Degeneracy-Evil/cpu-designers/Report/media/嵌入式cpu测试.jpg

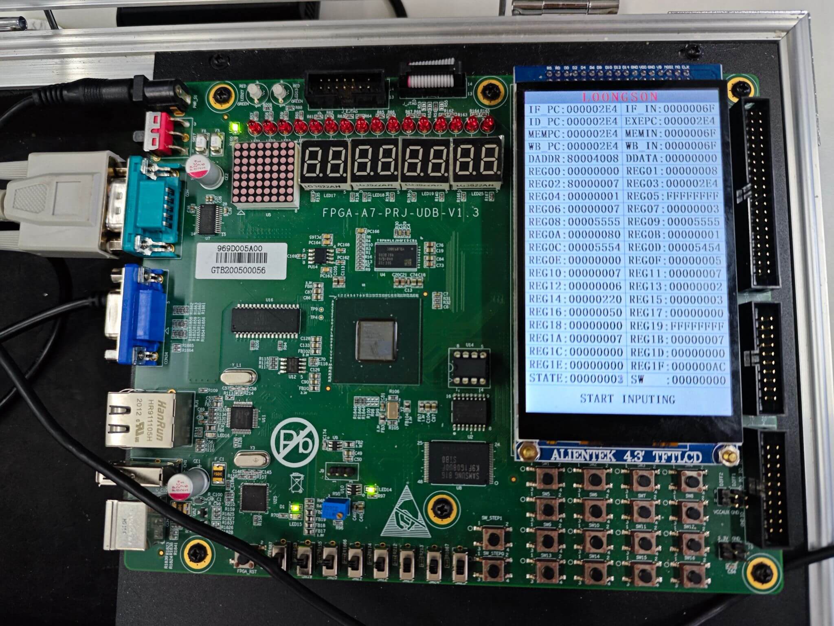
Report/media/嵌入式cpu测试.jpg
