Degeneracy-Evil/cpu-designers/Report/media/debug.jpg

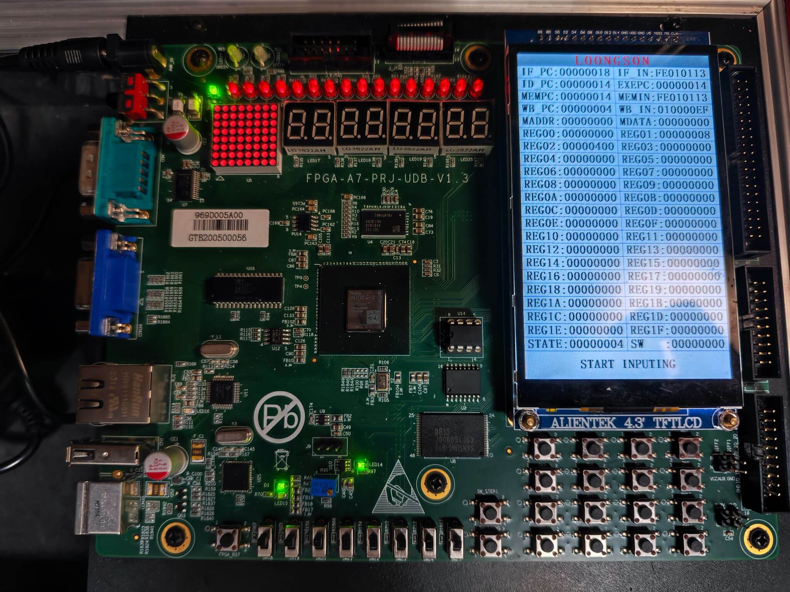
Report/media/debug.jpg
