Degeneracy-Evil/cpu-designers/Reference/FPGA基础信息.md

# FPGA基础信息

芯片型号：xc7a200tfbg676-2

硬件描述：lcd_module.dcp

系统clock频率：100MHz

## 存储模块

SRAM：IDT 71V124SA10TYG，128K（地址空间） × 8位（数据位宽），总容量 1Mbit，10ns
DDR3：Samsung DDR3 SDRAM K4B1G1646G-BCK0 128MB x16 1866Mbps PC3L-14900 CL13
NAND Flash：Samsung K9F1G08U0C-PCB0 128M x 8bits ，异步并行接口，Page=2KB + 64B，Block=128KB + 4KB，ECC
