Degeneracy-Evil/cpu-designers/dev/docs/IS/29-Zc扩展-代码体积缩减.md

## 第29章 "Zc*"扩展：代码体积缩减，版本1.0.0

## 29.1. Zc*概述

Zc*是一组扩展，定义了现有C扩展的子集（Zca、Zcd、Zcf）以及仅包含16位编码的新扩展。

Zcm*都重用了*c.fld*、*c.fsd*、*c.fldsp*、*c.fsdsp*的编码。

*表40. Zc*扩展概览*

|指令|Zca|Zcf|Zcd|Zcb|Zcmp|Zcmt|
|---|---|---|---|---|---|---|
|Zca扩展被添加为一种引用C扩展中不包含浮点加载和存储指令的方式|||||||
|C excl. c.f*|yes||||||
|Zcf扩展被添加为一种引用压缩单精度浮点加载/存储的方式|||||||
|c.flw||rv32|||||
|c.flwsp||rv32|||||
|c.fsw||rv32|||||
|c.fswsp||rv32|||||
|Zcd扩展被添加为一种引用压缩双精度浮点加载/存储的方式|||||||
|c.fld|||yes||||
|c.fldsp|||yes||||
|c.fsd|||yes||||
|c.fsdsp|||yes||||
|可在所有架构上使用的简单操作|||||||
|c.lbu||||yes|||
|c.lh||||yes|||
|c.lhu||||yes|||
|c.sb||||yes|||
|c.sh||||yes|||
|c.zext.b||||yes|||
|c.sext.b||||yes|||
|c.zext.h||||yes|||
|c.sext.h||||yes|||
|c.zext.w||||yes|||
|c.mul||||yes|||
|c.not||||yes|||
|PUSH/POP和双寄存器移动，与*c.fsdsp*编码重叠。面向嵌入式CPU的复杂操作|||||||
|cm.push|||||yes||
|cm.pop|||||yes||
|cm.popret|||||yes||
|cm.popretz|||||yes||
|cm.mva01s|||||yes||
|cm.mvsa01|||||yes||
|表跳转，与*c.fsdsp*编码重叠。面向嵌入式CPU的复杂操作|||||||
|cm.jt||||||yes|
|cm.jalt||||||yes|

## 29.2. C

C扩展是以下扩展的超集：

- Zca
- 如果指定了F，则包含Zcf（仅RV32）
- 如果指定了D，则包含Zcd

由于C定义了与Zca、Zcf和Zcd相同的指令，规则如下：

- C总是蕴含Zca
- C+F蕴含Zcf（仅RV32）
- C+D蕴含Zcd

## 29.3. Zce

Zce扩展旨在用于微控制器，包括所有相关的Zc扩展。

- 在不带F的RV32上指定Zce包含Zca、Zcb、Zcmp、Zcmt
- 在带F的RV32上指定Zce包含Zca、Zcb、Zcmp、Zcmt*和*Zcf
- 在RV64上指定Zce始终包含Zca、Zcb、Zcmp、Zcmt
  - Zcf在RV64中不存在

因此，常见的ISA字符串可以如下更新以包含相关的Zc扩展，例如：

- RV32IMC变为RV32IM_Zce
- RV32IMCF变为RV32IMF_Zce

## 29.4. MISA.C

如果选择了以下扩展，则MISA.C被设置：

- Zca且非F
- Zca、Zcf和F（但非D）被指定（仅RV32）
- Zca、Zcf和Zcd如果D被指定（仅RV32）
  - 此配置排除Zcmp、Zcmt
- Zca、Zcd如果D被指定（仅RV64）
  - 此配置排除Zcmp、Zcmt

## 29.5. Zca

Zca扩展被添加为一种引用C扩展中不包含浮点加载和存储指令的方式。

因此它*排除*了所有16位浮点加载和存储：*c.flw*、*c.flwsp*、*c.fsw*、*c.fswsp*、*c.fld*、*c.fldsp*、*c.fsd*、*c.fsdsp*。

**评论：** C扩展仅在D和F也被指定时才包含F/D指令。

## 29.6. Zcf（仅RV32）

Zcf是现有的压缩单精度浮点加载和存储集合：*c.flw*、*c.flwsp*、*c.fsw*、*c.fswsp*。

Zcf仅与RV32相关，不能为RV64指定。

Zcf扩展依赖于Zca和F扩展。

## 29.7. Zcd

Zcd是现有的压缩双精度浮点加载和存储集合：*c.fld*、*c.fldsp*、*c.fsd*、*c.fsdsp*。

Zcd扩展依赖于Zca和D扩展。

## 29.8. Zcb

Zcb具有简单的代码体积节省指令，这些指令在所有CPU上都容易实现。

所有编码目前对所有架构都是保留的，且与任何现有扩展没有冲突。

**评论：** Zcb可以在任何CPU上实现，因为这些指令是应用类配置文件中现有32位指令的16位版本。

Zcb扩展依赖于Zca扩展。

如各个指令页面所示，Zcb中的许多指令依赖于另一个扩展的实现。例如，*c.mul*仅在M或Zmmul被实现时才实现，*c.sext.b*仅在Zbb被实现时才实现。

*c.mul*编码使用CA寄存器格式，与其他指令如*c.sub*、*c.xor*等一起。

**评论：** *c.sext.w是c.addiw rd, 0 (RV64)的伪指令。*

|RV32|RV64|助记符|指令|
|---|---|---|---|
|yes|yes|c.lbu *rd'*, uimm(*rs1'*)|加载无符号字节，16位编码|
|yes|yes|c.lhu *rd'*, uimm(*rs1'*)|加载无符号半字，16位编码|
|yes|yes|c.lh *rd'*, uimm(*rs1'*)|加载有符号半字，16位编码|
|yes|yes|c.sb *rs2'*, uimm(*rs1'*)|存储字节，16位编码|
|yes|yes|c.sh *rs2'*, uimm(*rs1'*)|存储半字，16位编码|
|yes|yes|c.zext.b *rsd'*|零扩展字节，16位编码|
|yes|yes|c.sext.b *rsd'*|符号扩展字节，16位编码|
|yes|yes|c.zext.h *rsd'*|零扩展半字，16位编码|
|yes|yes|c.sext.h *rsd'*|符号扩展半字，16位编码|
||yes|c.zext.w *rsd'*|零扩展字，16位编码|
|yes|yes|c.not *rsd'*|按位取反，16位编码|
|yes|yes|c.mul *rsd'*, *rs2'*|乘法，16位编码|

## 29.9. Zcmp

Zcmp扩展是一组可以作为现有32位RISC-V指令序列执行的指令。

此扩展重用了*c.fsdsp*的一些编码。因此它与Zcd*不兼容*，Zcd在C和D扩展同时存在时被包含。

**评论：** Zcmp主要面向嵌入式类CPU，因为实现复杂性较高。此外，它不兼容应用类配置文件。

Zcmp扩展依赖于Zca扩展。

PUSH/POP汇编语法使用多个变量，其含义如下：

- *reg_list*是一个包含1到13个寄存器的列表（ra和0到12个s寄存器）
  - 有效值：{ra}、{ra, s0}、{ra, s0-s1}、{ra, s0-s2}、…、{ra, s0-s8}、{ra, s0-s9}、{ra, s0-s11}
  - 注意{ra, s0-s10}是*无效*的，提供12个列表而非13个以获得更好的编码
- *stack_adj*是栈帧的总大小。
  - 有效值随寄存器列表长度和具体编码而变化，详见各指令页面。

|RV32|RV64|助记符|指令|
|---|---|---|---|
|yes|yes|cm.push *{reg_list}*, -*stack_adj*|cm.push|
|yes|yes|cm.pop *{reg_list}*, *stack_adj*|cm.pop|
|yes|yes|cm.popret *{reg_list}*, *stack_adj*|cm.popret|
|yes|yes|cm.popretz *{reg_list}*, *stack_adj*|cm.popretz|
|yes|yes|cm.mva01s *rs1'*, *rs2'*|将两个s0-s7寄存器移动到a0-a1|
|yes|yes|cm.mvsa01 *r1s'*, *r2s'*|将a0-a1移动到两个不同的s0-s7寄存器|

## 29.10. Zcmt

Zcmt添加了表跳转指令，还添加了jvt CSR。如果实现了Smstateen，则jvt CSR需要状态使能。详情参见jvt CSR，表跳转基向量和控制寄存器。

此扩展重用了*c.fsdsp*的一些编码。因此它与Zcd*不兼容*，Zcd在C和D扩展同时存在时被包含。

**评论：** Zcmt主要面向嵌入式类CPU，因为实现复杂性较高。此外，它与RVA配置文件不兼容。

Zcmt扩展依赖于Zca和Zicsr扩展。

|RV32|RV64|助记符|指令|
|---|---|---|---|
|yes|yes|cm.jt *index*|通过表跳转|
|yes|yes|cm.jalt *index*|通过表跳转并链接|

## 29.11. Zc指令格式

本规范中的若干指令使用以下新指令格式。

|格式|指令|15:10|9|8|7|6|5|4|3|2|1|0|
|---|---|---|---|---|---|---|---|---|---|---|---|---|---|
|CLB|c.lbu|funct6|rs1'|||uimm||rd'|||op||
|CSB|c.sb|funct6|rs1'|||uimm||rs2'|||op||
|CLH|c.lhu, c.lh|funct6|rs1'|||funct<br>1|uim<br>m|rd'|||op||
|CSH|c.sh|funct6|rs1'|||funct<br>1|uim<br>m|rs2'|||op||
|CU|c.[sz]ext.*, c.not|funct6|rd'/rs1'|||funct5|||||op||
|CMMV|cm.mvsa01<br>cm.mva01s|funct6|r1s'|||funct2||r2s'|||op||
|CMJT|cm.jt cm.jalt|funct6|index||||||||op||
|CMPP|cm.push*, cm.pop*|funct6|funct2||urlist||||spimm||op||

**评论：** *c.mul使用现有的CA格式。*

## 29.12. Zcb指令

## 29.12.1. c.lbu

### 概要

加载无符号字节，16位编码

### 助记符

c.lbu *rd'* , *uimm* ( *rs1'* )

编码（RV32, RV64）：

|0<br>1<br>2<br>4<br>5<br>6<br>7<br>9<br>10<br>12<br>13<br>15|0<br>1<br>2<br>4<br>5<br>6<br>7<br>9<br>10<br>12<br>13<br>15|0<br>1<br>2<br>4<br>5<br>6<br>7<br>9<br>10<br>12<br>13<br>15|0<br>1<br>2<br>4<br>5<br>6<br>7<br>9<br>10<br>12<br>13<br>15|0<br>1<br>2<br>4<br>5<br>6<br>7<br>9<br>10<br>12<br>13<br>15|0<br>1<br>2<br>4<br>5<br>6<br>7<br>9<br>10<br>12<br>13<br>15|
|---|---|---|---|---|---|---|
|0<br>0<br>1|0<br>0<br>0|rs1'|uimm[0|1]|rd'|0<br>0|
|C0<br>FUNCT3|||||||

立即数偏移量按如下方式形成：

```
  uimm[31:2] = 0;
  uimm[1]    = encoding[5];
  uimm[0]    = encoding[6];
```

### 描述

此指令从内存地址加载一个字节，该地址通过将*rs1'*与零扩展立即数*uimm*相加形成。结果字节被零扩展到XLEN位并写入*rd'*。

**评论：** *rd'和rs1'来自标准8寄存器集x8-x15。*

### 前置条件

无

### 操作

```
//这不是SAIL，是伪代码。SAIL尚未编写。
```

```
X(rdc) = EXTZ(mem[X(rs1c)+EXTZ(uimm)][7..0]);
```

## 29.12.2. c.lhu

### 概要

加载无符号半字，16位编码

### 助记符

c.lhu *rd'* , *uimm* ( *rs1'* )

编码（RV32, RV64）：

|0<br>1<br>2<br>4<br>5<br>6<br>7<br>9<br>10<br>12<br>13<br>15|0<br>1<br>2<br>4<br>5<br>6<br>7<br>9<br>10<br>12<br>13<br>15|0<br>1<br>2<br>4<br>5<br>6<br>7<br>9<br>10<br>12<br>13<br>15|0<br>1<br>2<br>4<br>5<br>6<br>7<br>9<br>10<br>12<br>13<br>15|0<br>1<br>2<br>4<br>5<br>6<br>7<br>9<br>10<br>12<br>13<br>15|0<br>1<br>2<br>4<br>5<br>6<br>7<br>9<br>10<br>12<br>13<br>15|0<br>1<br>2<br>4<br>5<br>6<br>7<br>9<br>10<br>12<br>13<br>15|
|---|---|---|---|---|---|---|
|0<br>0<br>1|1<br>0<br>0|rs1'|0|uimm[1]|rd'<br>|0<br>0|
|C0<br>FUNCT3||||||||

立即数偏移量按如下方式形成：

```
  uimm[31:2] = 0;
  uimm[1]    = encoding[5];
  uimm[0]    = 0;
```

### 描述

此指令从内存地址加载一个半字，该地址通过将*rs1'*与零扩展立即数*uimm*相加形成。结果半字被零扩展到XLEN位并写入*rd'*。

**评论：** *rd'和rs1'来自标准8寄存器集x8-x15。*

### 前置条件

无

### 操作

```
//这不是SAIL，是伪代码。SAIL尚未编写。
```

```
X(rdc) = EXTZ(load_mem[X(rs1c)+EXTZ(uimm)][15..0]);
```

## 29.12.3. c.lh

### 概要

加载有符号半字，16位编码

### 助记符

c.lh *rd'* , *uimm* ( *rs1'* )

编码（RV32, RV64）：

|0<br>1<br>2<br>4<br>5<br>6<br>7<br>9<br>10<br>12<br>13<br>15|0<br>1<br>2<br>4<br>5<br>6<br>7<br>9<br>10<br>12<br>13<br>15|0<br>1<br>2<br>4<br>5<br>6<br>7<br>9<br>10<br>12<br>13<br>15|0<br>1<br>2<br>4<br>5<br>6<br>7<br>9<br>10<br>12<br>13<br>15|0<br>1<br>2<br>4<br>5<br>6<br>7<br>9<br>10<br>12<br>13<br>15|0<br>1<br>2<br>4<br>5<br>6<br>7<br>9<br>10<br>12<br>13<br>15|0<br>1<br>2<br>4<br>5<br>6<br>7<br>9<br>10<br>12<br>13<br>15|
|---|---|---|---|---|---|---|
|0<br>0<br>1|1<br>0<br>0|rs1'|1|uimm[1]|rd'<br>|0<br>0|
|C0<br>FUNCT3||||||||

立即数偏移量按如下方式形成：

```
  uimm[31:2] = 0;
  uimm[1]    = encoding[5];
  uimm[0]    = 0;
```

### 描述

此指令从内存地址加载一个半字，该地址通过将*rs1'*与零扩展立即数*uimm*相加形成。结果半字被符号扩展到XLEN位并写入*rd'*。

**评论：** *rd'和rs1'来自标准8寄存器集x8-x15。*

### 前置条件

无

### 操作

```
//这不是SAIL，是伪代码。SAIL尚未编写。
```

```
X(rdc) = EXTS(load_mem[X(rs1c)+EXTZ(uimm)][15..0]);
```

## 29.12.4. c.sb

### 概要

存储字节，16位编码

### 助记符

c.sb *rs2'* , *uimm* ( *rs1'* )

编码（RV32, RV64）：

|0<br>1<br>2<br>4<br>5<br>6<br>7<br>9<br>10<br>12<br>13<br>15|0<br>1<br>2<br>4<br>5<br>6<br>7<br>9<br>10<br>12<br>13<br>15|0<br>1<br>2<br>4<br>5<br>6<br>7<br>9<br>10<br>12<br>13<br>15|0<br>1<br>2<br>4<br>5<br>6<br>7<br>9<br>10<br>12<br>13<br>15|0<br>1<br>2<br>4<br>5<br>6<br>7<br>9<br>10<br>12<br>13<br>15|0<br>1<br>2<br>4<br>5<br>6<br>7<br>9<br>10<br>12<br>13<br>15|
|---|---|---|---|---|---|---|
|0<br>0<br>1|0<br>1<br>0|rs1'|uimm[0|1]|rs2'|0<br>0|
|C0<br>FUNCT3|||||||

立即数偏移量按如下方式形成：

```
  uimm[31:2] = 0;
  uimm[1]    = encoding[5];
  uimm[0]    = encoding[6];
```

### 描述

此指令将*rs2'*的最低有效字节存储到内存地址，该地址通过将*rs1'*与零扩展立即数*uimm*相加形成。

**评论：** *rs1'和rs2'来自标准8寄存器集x8-x15。*

### 前置条件

无

### 操作

```
//这不是SAIL，是伪代码。SAIL尚未编写。
```

```
mem[X(rs1c)+EXTZ(uimm)][7..0] = X(rs2c)
```

## 29.12.5. c.sh

### 概要

存储半字，16位编码

### 助记符

c.sh *rs2'* , *uimm* ( *rs1'* )

编码（RV32, RV64）：

|0<br>1<br>2<br>4<br>5<br>6<br>7<br>9<br>10<br>12<br>13<br>15|0<br>1<br>2<br>4<br>5<br>6<br>7<br>9<br>10<br>12<br>13<br>15|0<br>1<br>2<br>4<br>5<br>6<br>7<br>9<br>10<br>12<br>13<br>15|0<br>1<br>2<br>4<br>5<br>6<br>7<br>9<br>10<br>12<br>13<br>15|0<br>1<br>2<br>4<br>5<br>6<br>7<br>9<br>10<br>12<br>13<br>15|0<br>1<br>2<br>4<br>5<br>6<br>7<br>9<br>10<br>12<br>13<br>15|0<br>1<br>2<br>4<br>5<br>6<br>7<br>9<br>10<br>12<br>13<br>15|
|---|---|---|---|---|---|---|
|0<br>0<br>1|1<br>1<br>0|rs1'|0|uimm[1]|rs2'<br>|0<br>0|
|C0<br>FUNCT3||||||||

立即数偏移量按如下方式形成：

```
  uimm[31:2] = 0;
  uimm[1]    = encoding[5];
  uimm[0]    = 0;
```

### 描述

此指令将*rs2'*的最低有效半字存储到内存地址，该地址通过将*rs1'*与零扩展立即数*uimm*相加形成。

**评论：** *rs1'和rs2'来自标准8寄存器集x8-x15。*

### 前置条件

无

### 操作

```
//这不是SAIL，是伪代码。SAIL尚未编写。
```

```
mem[X(rs1c)+EXTZ(uimm)][15..0] = X(rs2c)
```

## 29.12.6. c.zext.b

### 概要

零扩展字节，16位编码

### 助记符

c.zext.b *rd'/rs1'*

编码（RV32, RV64）：

|0<br>1<br>2<br>4<br>5<br>6<br>7<br>9<br>10<br>12<br>13<br>15|0<br>1<br>2<br>4<br>5<br>6<br>7<br>9<br>10<br>12<br>13<br>15|0<br>1<br>2<br>4<br>5<br>6<br>7<br>9<br>10<br>12<br>13<br>15|0<br>1<br>2<br>4<br>5<br>6<br>7<br>9<br>10<br>12<br>13<br>15|0<br>1<br>2<br>4<br>5<br>6<br>7<br>9<br>10<br>12<br>13<br>15|0<br>1<br>2<br>4<br>5<br>6<br>7<br>9<br>10<br>12<br>13<br>15|
|---|---|---|---|---|---|---|
|0<br>0<br>1|1<br>1<br>1|rd'/rs1'|1<br>1|0<br>0<br>0|1<br>0|
|C1<br>C.ZEXT.B<br>FUNCT2<br>SRCDST<br>FUNCT3|||||||

### 描述

此指令接受单个源/目标操作数。它将操作数的最低有效字节零扩展到XLEN位，通过在高于7的所有位中插入零。

**评论：** *rd'/rs1'来自标准8寄存器集x8-x15。*

### 前置条件

无

32位等价指令：

```
andi rd'/rs1', rd'/rs1', 0xff
```

**评论：** *rd'/rs1'的SAIL模块变量称为rsdc。*

### 操作

```
X(rsdc) = EXTZ(X(rsdc)[7..0]);
```

## 29.12.7. c.sext.b

### 概要

符号扩展字节，16位编码

### 助记符

c.sext.b *rd'/rs1'*

编码（RV32, RV64）：

|0<br>1<br>2<br>4<br>5<br>6<br>7<br>9<br>10<br>12<br>13<br>15|0<br>1<br>2<br>4<br>5<br>6<br>7<br>9<br>10<br>12<br>13<br>15|0<br>1<br>2<br>4<br>5<br>6<br>7<br>9<br>10<br>12<br>13<br>15|0<br>1<br>2<br>4<br>5<br>6<br>7<br>9<br>10<br>12<br>13<br>15|0<br>1<br>2<br>4<br>5<br>6<br>7<br>9<br>10<br>12<br>13<br>15|0<br>1<br>2<br>4<br>5<br>6<br>7<br>9<br>10<br>12<br>13<br>15|
|---|---|---|---|---|---|---|
|0<br>0<br>1|1<br>1<br>1|rd'/rs1'|1<br>1|1<br>0<br>0|1<br>0|
|C1<br>C.SEXT.B<br>FUNCT2<br>SRCDST<br>FUNCT3|||||||

### 描述

此指令接受单个源/目标操作数。它将操作数中的最低有效字节符号扩展到XLEN位，通过将字节中的最高有效位（即位7）复制到所有更高位。

**评论：** *rd'/rs1'来自标准8寄存器集x8-x15。*

### 前置条件

还需要Zbb。

**评论：** *rd'/rs1'的SAIL模块变量称为rsdc。*

### 操作

```
X(rsdc) = EXTS(X(rsdc)[7..0]);
```

## 29.12.8. c.zext.h

### 概要

零扩展半字，16位编码

### 助记符

c.zext.h *rd'/rs1'*

编码（RV32, RV64）：

|0<br>1<br>2<br>4<br>5<br>6<br>7<br>9<br>10<br>12<br>13<br>15|0<br>1<br>2<br>4<br>5<br>6<br>7<br>9<br>10<br>12<br>13<br>15|0<br>1<br>2<br>4<br>5<br>6<br>7<br>9<br>10<br>12<br>13<br>15|0<br>1<br>2<br>4<br>5<br>6<br>7<br>9<br>10<br>12<br>13<br>15|0<br>1<br>2<br>4<br>5<br>6<br>7<br>9<br>10<br>12<br>13<br>15|0<br>1<br>2<br>4<br>5<br>6<br>7<br>9<br>10<br>12<br>13<br>15|
|---|---|---|---|---|---|---|
|0<br>0<br>1|1<br>1<br>1|rd'/rs1'|1<br>1|0<br>1<br>0|1<br>0|
|C1<br>C.ZEXT.H<br>FUNCT2<br>SRCDST<br>FUNCT3|||||||

### 描述

此指令接受单个源/目标操作数。它将操作数的最低有效半字零扩展到XLEN位，通过在高于15的所有位中插入零。

**评论：** *rd'/rs1'来自标准8寄存器集x8-x15。*

### 前置条件

还需要Zbb。

**评论：** *rd'/rs1'的SAIL模块变量称为rsdc。*

### 操作

```
X(rsdc) = EXTZ(X(rsdc)[15..0]);
```

## 29.12.9. c.sext.h

### 概要

符号扩展半字，16位编码

### 助记符

c.sext.h *rd'/rs1'*

编码（RV32, RV64）：

|0<br>1<br>2<br>4<br>5<br>6<br>7<br>9<br>10<br>12<br>13<br>15|0<br>1<br>2<br>4<br>5<br>6<br>7<br>9<br>10<br>12<br>13<br>15|0<br>1<br>2<br>4<br>5<br>6<br>7<br>9<br>10<br>12<br>13<br>15|0<br>1<br>2<br>4<br>5<br>6<br>7<br>9<br>10<br>12<br>13<br>15|0<br>1<br>2<br>4<br>5<br>6<br>7<br>9<br>10<br>12<br>13<br>15|0<br>1<br>2<br>4<br>5<br>6<br>7<br>9<br>10<br>12<br>13<br>15|
|---|---|---|---|---|---|---|
|0<br>0<br>1|1<br>1<br>1|rd'/rs1'|1<br>1|1<br>1<br>0|1<br>0|
|C1<br>C.SEXT.H<br>FUNCT2<br>SRCDST<br>FUNCT3|||||||

### 描述

此指令接受单个源/目标操作数。它将操作数中的最低有效半字符号扩展到XLEN位，通过将半字中的最高有效位（即位15）复制到所有更高位。

**评论：** *rd'/rs1'来自标准8寄存器集x8-x15。*

### 前置条件

还需要Zbb。

**评论：** *rd'/rs1'的SAIL模块变量称为rsdc。*

### 操作

```
X(rsdc) = EXTS(X(rsdc)[15..0]);
```

## 29.12.10. c.zext.w

### 概要

零扩展字，16位编码

### 助记符

c.zext.w *rd'/rs1'*

编码（RV64）：

|0<br>1<br>2<br>4<br>5<br>6<br>7<br>9<br>10<br>12<br>13<br>15|0<br>1<br>2<br>4<br>5<br>6<br>7<br>9<br>10<br>12<br>13<br>15|0<br>1<br>2<br>4<br>5<br>6<br>7<br>9<br>10<br>12<br>13<br>15|0<br>1<br>2<br>4<br>5<br>6<br>7<br>9<br>10<br>12<br>13<br>15|0<br>1<br>2<br>4<br>5<br>6<br>7<br>9<br>10<br>12<br>13<br>15|0<br>1<br>2<br>4<br>5<br>6<br>7<br>9<br>10<br>12<br>13<br>15|
|---|---|---|---|---|---|---|
|0<br>0<br>1|1<br>1<br>1|rd'/rs1'|1<br>1|0<br>0<br>1|1<br>0|
|C1<br>C.ZEXT.W<br>FUNCT2<br>SRCDST<br>FUNCT3|||||||

### 描述

此指令接受单个源/目标操作数。它将操作数的最低有效字零扩展到XLEN位，通过在高于31的所有位中插入零。

**评论：** *rd'/rs1'来自标准8寄存器集x8-x15。*

### 前置条件

还需要Zba。

32位等价指令：

```
add.uw rd'/rs1', rd'/rs1', zero
```

**评论：** *rd'/rs1'的SAIL模块变量称为rsdc。*

### 操作

```
X(rsdc) = EXTZ(X(rsdc)[31..0]);
```

## 29.12.11. c.not

### 概要

按位取反，16位编码

### 助记符

c.not *rd'/rs1'*

编码（RV32, RV64）：

|0<br>1<br>2<br>4<br>5<br>6<br>7<br>9<br>10<br>12<br>13<br>15|0<br>1<br>2<br>4<br>5<br>6<br>7<br>9<br>10<br>12<br>13<br>15|0<br>1<br>2<br>4<br>5<br>6<br>7<br>9<br>10<br>12<br>13<br>15|0<br>1<br>2<br>4<br>5<br>6<br>7<br>9<br>10<br>12<br>13<br>15|0<br>1<br>2<br>4<br>5<br>6<br>7<br>9<br>10<br>12<br>13<br>15|0<br>1<br>2<br>4<br>5<br>6<br>7<br>9<br>10<br>12<br>13<br>15|
|---|---|---|---|---|---|---|
|0<br>0<br>1|1<br>1<br>1|rd'/rs1'|1<br>1|1<br>0<br>1|1<br>0|
|C1<br>C.NOT<br>FUNCT2<br>SRCDST<br>FUNCT3|||||||

### 描述

此指令取*rd'/rs1'*的反码，并将结果写入同一寄存器。

**评论：** *rd'/rs1'来自标准8寄存器集x8-x15。*

### 前置条件

无

32位等价指令：

```
xori rd'/rs1', rd'/rs1', -1
```

**评论：** *rd'/rs1'的SAIL模块变量称为rsdc。*

### 操作

```
X(rsdc) = X(rsdc) XOR -1;
```

## 29.12.12. c.mul

### 概要

乘法，16位编码

### 助记符

c.mul *rsd'* , *rs2'*

编码（RV32, RV64）：

|0<br>1<br>2<br>4<br>5<br>6<br>7<br>9<br>10<br>12<br>13<br>15|0<br>1<br>2<br>4<br>5<br>6<br>7<br>9<br>10<br>12<br>13<br>15|0<br>1<br>2<br>4<br>5<br>6<br>7<br>9<br>10<br>12<br>13<br>15|0<br>1<br>2<br>4<br>5<br>6<br>7<br>9<br>10<br>12<br>13<br>15|0<br>1<br>2<br>4<br>5<br>6<br>7<br>9<br>10<br>12<br>13<br>15|0<br>1<br>2<br>4<br>5<br>6<br>7<br>9<br>10<br>12<br>13<br>15|
|---|---|---|---|---|---|---|
|0<br>0<br>1|1<br>1<br>1|rd'/rs1'|0<br>1|rs2'|1<br>0|
|C1<br>SRC2<br>FUNCT2<br>SRCDST<br>FUNCT3|||||||

### 描述

此指令将来自*rsd'*和*rs2'*的源操作数的XLEN位相乘，并将结果的最低XLEN位写入*rsd'*。

**评论：** *rd'/rs1'和rs2'来自标准8寄存器集x8-x15。*

### 前置条件

必须配置M或Zmmul。

**评论：** *rd'/rs1'的SAIL模块变量称为rsdc，rs2'的模块变量称为rs2c。*

### 操作

```
let result_wide = to_bits(2 * sizeof(xlen), signed(X(rsdc)) * signed(X(rs2c)));
X(rsdc) = result_wide[(sizeof(xlen) - 1) .. 0];
```

## 29.13. PUSH/POP寄存器指令

这些指令统称为PUSH/POP：

- cm.push
- cm.pop
- cm.popret
- cm.popretz

术语PUSH指*cm.push*。

术语POP指*cm.pop*。

术语POPRET指*cm.popret和cm.popretz*。

这些指令的公共细节在本节中。

## 29.13.1. PUSH/POP功能概述

PUSH、POP、POPRET用于减少函数序幕和尾声的大小。

1. PUSH指令
   - 调整栈指针以创建栈帧
   - 将寄存器列表中指定的寄存器压入（存储到）栈帧

2. POP指令
   - 从栈帧弹出（加载）寄存器列表中的寄存器
   - 调整栈指针以销毁栈帧

3. POPRET指令
   - 从栈帧弹出（加载）寄存器列表中的寄存器
   - *cm.popretz*还将零移入*a0*作为返回值
   - 调整栈指针以销毁栈帧
   - 执行*ret*指令从函数返回

## 29.13.2. 示例用法

此示例说明了PUSH和POPRET的使用。

EMBench基准测试picojpeg中的*processMarkers*函数，位于github上的以下文件：libpicojpeg.c

序幕和尾声使用GCC10编译为：

```
   0001098a <processMarkers>:
   1098a:       711d                    addi    sp,sp,-96 ;#cm.push(1)
   1098c:       c8ca                    sw      s2,80(sp) ;#cm.push(2)
   1098e:       c6ce                    sw      s3,76(sp) ;#cm.push(3)
   10990:       c4d2                    sw      s4,72(sp) ;#cm.push(4)
   10992:       ce86                    sw      ra,92(sp) ;#cm.push(5)
   10994:       cca2                    sw      s0,88(sp) ;#cm.push(6)
   10996:       caa6                    sw      s1,84(sp) ;#cm.push(7)
   10998:       c2d6                    sw      s5,68(sp) ;#cm.push(8)
   1099a:       c0da                    sw      s6,64(sp) ;#cm.push(9)
   1099c:       de5e                    sw      s7,60(sp) ;#cm.push(10)
   1099e:       dc62                    sw      s8,56(sp) ;#cm.push(11)
   109a0:       da66                    sw      s9,52(sp) ;#cm.push(12)
   109a2:       d86a                    sw      s10,48(sp);#cm.push(13)
   109a4:       d66e                    sw      s11,44(sp);#cm.push(14)
...
   109f4:       4501                    li      a0,0      ;#cm.popretz(1)
   109f6:       40f6                    lw      ra,92(sp) ;#cm.popretz(2)
   109f8:       4466                    lw      s0,88(sp) ;#cm.popretz(3)
   109fa:       44d6                    lw      s1,84(sp) ;#cm.popretz(4)
   109fc:       4946                    lw      s2,80(sp) ;#cm.popretz(5)
   109fe:       49b6                    lw      s3,76(sp) ;#cm.popretz(6)
   10a00:       4a26                    lw      s4,72(sp) ;#cm.popretz(7)
   10a02:       4a96                    lw      s5,68(sp) ;#cm.popretz(8)
   10a04:       4b06                    lw      s6,64(sp) ;#cm.popretz(9)
   10a06:       5bf2                    lw      s7,60(sp) ;#cm.popretz(10)
   10a08:       5c62                    lw      s8,56(sp) ;#cm.popretz(11)
   10a0a:       5cd2                    lw      s9,52(sp) ;#cm.popretz(12)
   10a0c:       5d42                    lw      s10,48(sp);#cm.popretz(13)
   10a0e:       5db2                    lw      s11,44(sp);#cm.popretz(14)
   10a10:       6125                    addi    sp,sp,96  ;#cm.popretz(15)
   10a12:       8082                    ret               ;#cm.popretz(16)
```

使用GCC选项*-msave-restore*的输出如下：

```
0001080e <processMarkers>:
   1080e:       73a012ef                jal     t0,11f48 <__riscv_save_12>
   10812:       1101                    addi    sp,sp,-32
...
   10862:       4501                    li      a0,0
   10864:       6105                    addi    sp,sp,32
   10866:       71e0106f                j       11f84 <__riscv_restore_12>
```

使用PUSH/POPRET后简化为：

```
0001080e <processMarkers>:
   1080e:       b8fa                    cm.push    {ra,s0-s11},-96
...
   10866:       bcfa                    cm.popretz {ra,s0-s11}, 96
```

序幕/尾声从原始代码的60字节减少到使用*-msave-restore*的14字节，再减少到使用PUSH和POPRET的4字节。除了减少代码大小外，PUSH和POPRET还消除了调用毫码*save/restore*例程的分支，因此也可能具有更好的性能。

**评论：** *当目标函数超出±1 MB范围时，对<riscv_save_0>/<riscv_restore_0>的调用变为64位，将序幕/尾声大小增加到22字节。POP通常在尾调用序列中使用，在销毁栈帧后不使用ret返回ra。*

## 29.13.2.1. 栈指针调整处理

这些指令都自动调整栈指针，调整量足以覆盖保存或恢复的寄存器所需的内存。此外，编码中的*spimm*字段允许栈指针以16字节的额外增量进行调整。编码中只有一个小范围的可用值；如果范围不够，可以使用单独的*c.addi16sp*来增加范围。

## 29.13.2.2. 寄存器列表处理

不支持不包含*s11*的*{ra, s0-s10}*寄存器列表。因此在这种情况下必须使用*{ra, s0-s11}*寄存器列表。

## 29.13.3. PUSH/POP故障处理

正确执行要求*sp*引用幂等内存（另见非幂等内存处理），因为内核必须能够处理在序列期间检测到的陷阱。整个PUSH/POP序列在从陷阱处理程序返回后重新执行，并且序列期间可能发生多次陷阱。

如果在序列期间发生陷阱，*xEPC*使用指令的PC更新，*xTVAL*（如果不是只读零）使用坏地址更新（如果是访问故障），*xCAUSE*使用陷阱类型更新。

**评论：** *是否允许在序列执行期间发生中断由实现定义。*

## 29.13.4. 执行的软件视图

## 29.13.4.1. PUSH序列的软件视图

从软件角度看，PUSH序列表现为：

- 一系列写入伪代码所需字节的存储操作
  - 字节可以按任何顺序写入。
  - 字节可以组合成更大的访问。
  - 任何字节可能被多次写入。
- 一次栈指针调整

**评论：** *如果实现允许在序列期间中断，并且中断处理程序使用sp分配栈内存，那么在中断之前执行的任何存储操作都可能被处理程序覆盖。这是安全的，因为内存是幂等的，存储操作将在执行恢复时重新执行。*

栈指针调整必须仅在确定整个PUSH指令将提交时才提交。

存储操作也可能从总线返回不精确故障。内核实现是等待总线响应后再继续序列的最后阶段，还是在完成PUSH指令后处理错误响应，由平台定义。

例如：

```
cm.push  {ra, s0-s5}, -64
```

对软件表现为：

```
# sp-1到sp-28的任何字节可能在指令完成之前被多次写入
# 因此这些更新可能在栈指针以下的中断/异常处理程序中可见
sw  s5, -4(sp)
sw  s4, -8(sp)
sw  s3,-12(sp)
sw  s2,-16(sp)
sw  s1,-20(sp)
sw  s0,-24(sp)
sw  ra,-28(sp)
# 这必须只执行一次，并且只在所有存储操作完成且没有任何精确故障后执行
# 因此此更新仅在cm.push已完成时在中断/异常处理程序中可见
addi sp, sp, -64
```

## 29.13.4.2. POP/POPRET序列的软件视图

从软件角度看，POP/POPRET序列表现为：

- 一系列读取伪代码所需字节的加载操作。
  - 字节可以按任何顺序加载。
  - 字节可以组合成更大的访问。
  - 任何字节可能被多次加载。
- 一次栈指针调整
- 可选的`li a0, 0`
- 可选的`ret`

如果在序列期间发生陷阱，则在陷阱之前执行的任何加载操作都可能更新架构状态。一旦陷阱处理程序完成，加载操作将重新执行，因此值将被覆盖。因此允许实现在发生故障之前更新一些目标寄存器。

可选的`li a0, 0`、栈指针调整和可选的`ret`必须仅在确定整个POP/POPRET指令将提交时才提交。

对于POPRET，一旦栈指针调整已提交，`ret`必须执行。

例如：

```
cm.popretz {ra, s0-s3}, 32;
```

对软件表现为：

```
# 这些加载指令中的任何或全部可能多次执行
# 因此这些更新可能在中断/异常处理程序中可见
lw   s3, 28(sp)
lw   s2, 24(sp)
lw   s1, 20(sp)
lw   s0, 16(sp)
lw   ra, 12(sp)
# 这些必须只执行一次，仅在所有加载操作成功完成后执行
# 所有指令必须原子执行
# 因此这些更新在中断/异常处理程序中不可见
li a0, 0
addi sp, sp, 32
ret
```

## 29.13.5. 非幂等内存处理

实现可能需要将PUSH/POP指令发出到非幂等内存。

如果内核实现不支持PUSH/POP到非幂等内存，内核可以使用幂等性PMA来检测它，并采取加载（POP/POPRET）或存储（PUSH）访问故障异常以避免不可预测的结果。

软件应仅在软件能够容忍所需内存访问在导致异常的情况下被重复发出时，才对非幂等内存区域使用这些指令。

## 29.13.6. RV32I PUSH/POP序列示例

包含的示例显示了加载/存储序列展开和栈调整。*cm.popret*和*cm.popretz*的示例未包含，因为展开序列与*cm.pop*的差异在所有情况下都很微小。

## 29.13.6.1. cm.push {ra, s0-s2}, -64

编码：*rlist*=7，*spimm*=3

展开为：

```
sw  s2,  -4(sp);
sw  s1,  -8(sp);
sw  s0, -12(sp);
sw  ra, -16(sp);
addi sp, sp, -64;
```

## 29.13.6.2. cm.push {ra, s0-s11}, -112

编码：*rlist*=15，*spimm*=3

展开为：

```
sw  s11,  -4(sp);
sw  s10,  -8(sp);
sw  s9,  -12(sp);
sw  s8,  -16(sp);
sw  s7,  -20(sp);
sw  s6,  -24(sp);
sw  s5,  -28(sp);
sw  s4,  -32(sp);
sw  s3,  -36(sp);
sw  s2,  -40(sp);
sw  s1,  -44(sp);
sw  s0,  -48(sp);
sw  ra,  -52(sp);
addi sp, sp, -112;
```

## 29.13.6.3. cm.pop {ra}, 16

编码：*rlist*=4，*spimm*=0

展开为：

```
lw   ra, 12(sp);
addi sp, sp, 16;
```

## 29.13.6.4. cm.pop {ra, s0-s3}, 48

编码：*rlist*=8，*spimm*=1

展开为：

```
lw   s3, 44(sp);
lw   s2, 40(sp);
lw   s1, 36(sp);
lw   s0, 32(sp);
lw   ra, 28(sp);
addi sp, sp, 48;
```

## 29.13.6.5. cm.pop {ra, s0-s4}, 64

编码：*rlist*=9，*spimm*=2

展开为：

```
lw   s4, 60(sp);
lw   s3, 56(sp);
lw   s2, 52(sp);
lw   s1, 48(sp);
lw   s0, 44(sp);
lw   ra, 40(sp);
addi sp, sp, 64;
```

## 29.13.7. cm.push

### 概要

创建栈帧：将ra和0到12个保存寄存器存储到栈帧，可选地分配额外的栈空间。

### 助记符

cm.push *{reg_list}*, -*stack_adj*

编码（RV32, RV64）：

|0<br>1<br>2<br>3<br>4<br>7<br>8<br>12<br>13<br>15|0<br>1<br>2<br>3<br>4<br>7<br>8<br>12<br>13<br>15|0<br>1<br>2<br>3<br>4<br>7<br>8<br>12<br>13<br>15|0<br>1<br>2<br>3<br>4<br>7<br>8<br>12<br>13<br>15|0<br>1<br>2<br>3<br>4<br>7<br>8<br>12<br>13<br>15|
|---|---|---|---|---|
|1<br>0<br>1|0<br>0<br>0<br>1<br>1|rlist|spimm|0<br>1|
|C2<br>FUNCT3|||||

**评论：** *rlist值0到3保留用于未来的EABI变体，名为cm.push.e*

汇编语法：

```
cm.push {reg_list},  -stack_adj
cm.push {xreg_list}, -stack_adj
```

汇编语法中使用的变量定义如下。

```
RV32E:
switch (rlist){
  case  4: {reg_list="ra";         xreg_list="x1";}
  case  5: {reg_list="ra, s0";     xreg_list="x1, x8";}
  case  6: {reg_list="ra, s0-s1";  xreg_list="x1, x8-x9";}
default: reserved();
}
stack_adj      = stack_adj_base + spimm * 16;
```

```
RV32I, RV64:
switch (rlist){
  case  4: {reg_list="ra";         xreg_list="x1";}
  case  5: {reg_list="ra, s0";     xreg_list="x1, x8";}
  case  6: {reg_list="ra, s0-s1";  xreg_list="x1, x8-x9";}
  case  7: {reg_list="ra, s0-s2";  xreg_list="x1, x8-x9, x18";}
  case  8: {reg_list="ra, s0-s3";  xreg_list="x1, x8-x9, x18-x19";}
  case  9: {reg_list="ra, s0-s4";  xreg_list="x1, x8-x9, x18-x20";}
  case 10: {reg_list="ra, s0-s5";  xreg_list="x1, x8-x9, x18-x21";}
  case 11: {reg_list="ra, s0-s6";  xreg_list="x1, x8-x9, x18-x22";}
  case 12: {reg_list="ra, s0-s7";  xreg_list="x1, x8-x9, x18-x23";}
  case 13: {reg_list="ra, s0-s8";  xreg_list="x1, x8-x9, x18-x24";}
  case 14: {reg_list="ra, s0-s9";  xreg_list="x1, x8-x9, x18-x25";}
//注意 - 要包含s10，也必须包含s11
  case 15: {reg_list="ra, s0-s11"; xreg_list="x1, x8-x9, x18-x27";}
default: reserved();
}
stack_adj      = stack_adj_base + spimm * 16;
RV32E:
stack_adj_base = 16;
有效值:
stack_adj      = [16|32|48|64];
RV32I:
switch (rlist) {
  case  4.. 7: stack_adj_base = 16;
  case  8..11: stack_adj_base = 32;
  case 12..14: stack_adj_base = 48;
  case     15: stack_adj_base = 64;
}
有效值:
switch (rlist) {
  case  4.. 7: stack_adj = [16|32|48| 64];
  case  8..11: stack_adj = [32|48|64| 80];
  case 12..14: stack_adj = [48|64|80| 96];
  case     15: stack_adj = [64|80|96|112];
}
```

```
RV64:
switch (rlist) {
  case  4.. 5: stack_adj_base =  16;
  case  6.. 7: stack_adj_base =  32;
  case  8.. 9: stack_adj_base =  48;
  case 10..11: stack_adj_base =  64;
  case 12..13: stack_adj_base =  80;
  case     14: stack_adj_base =  96;
  case     15: stack_adj_base = 112;
}
有效值:
switch (rlist) {
  case  4.. 5: stack_adj = [ 16| 32| 48| 64];
  case  6.. 7: stack_adj = [ 32| 48| 64| 80];
  case  8.. 9: stack_adj = [ 48| 64| 80| 96];
  case 10..11: stack_adj = [ 64| 80| 96|112];
  case 12..13: stack_adj = [ 80| 96|112|128];
  case     14: stack_adj = [ 96|112|128|144];
  case     15: stack_adj = [112|128|144|160];
}
```

### 描述

此指令将*reg_list*中的寄存器压入（存储到）栈指针以下的内存，然后通过将栈指针减去*stack_adj*来创建栈帧，包括*spimm*值请求的任何额外栈空间。

**评论：** *所有ABI寄存器映射都是针对UABI的。一旦EABI冻结，计划推出EABI版本。*

更多信息请参见PUSH/POP寄存器指令。

栈调整计算：

*stack_adj_base*是覆盖列表中寄存器所需的最小字节数，以16字节地址增量倍数计算。

*spimm*是为栈帧分配的额外16字节地址增量的数量。

总栈调整量表示栈帧的总大小，即*stack_adj_base*加上*spimm*缩放16倍的值，如上所定义。

### 前置条件

无

32位等价指令：

不存在直接等价编码

### 操作

伪代码的第一部分可能在指令成功完成之前多次执行。

```
//这不是SAIL，是伪代码。SAIL尚未编写。
if (XLEN==32) bytes=4; else bytes=8;
addr=sp-bytes;
for(i in27,26,25,24,23,22,21,20,19,18,9,8,1)  {
//如果寄存器i在xreg_list中
if (xreg_list[i]) {
    switch(bytes) {
4:  asm("sw x[i], 0(addr)");
8:  asm("sd x[i], 0(addr)");
    }
    addr-=bytes;
  }
}
```

伪代码的最后部分原子执行，并且仅当上述部分在没有任何异常或中断的情况下完成时才执行。

```
//这不是SAIL，是伪代码。SAIL尚未编写。
sp-=stack_adj;
```

## 29.13.8. cm.pop

### 概要

销毁栈帧：从栈帧加载ra和0到12个保存寄存器，释放栈帧。

### 助记符

cm.pop *{reg_list}*, *stack_adj*

编码（RV32, RV64）：

|0<br>1<br>2<br>3<br>4<br>7<br>8<br>12<br>13<br>15|0<br>1<br>2<br>3<br>4<br>7<br>8<br>12<br>13<br>15|0<br>1<br>2<br>3<br>4<br>7<br>8<br>12<br>13<br>15|0<br>1<br>2<br>3<br>4<br>7<br>8<br>12<br>13<br>15|0<br>1<br>2<br>3<br>4<br>7<br>8<br>12<br>13<br>15|
|---|---|---|---|---|
|1<br>0<br>1|0<br>1<br>0<br>1<br>1|rlist|spimm|0<br>1|
|C2<br>FUNCT3|||||

**评论：** *rlist值0到3保留用于未来的EABI变体，名为cm.pop.e*

汇编语法：

```
cm.pop {reg_list},  stack_adj
cm.pop {xreg_list}, stack_adj
```

汇编语法中使用的变量定义如下。

```
RV32E:
switch (rlist){
  case  4: {reg_list="ra";         xreg_list="x1";}
  case  5: {reg_list="ra, s0";     xreg_list="x1, x8";}
  case  6: {reg_list="ra, s0-s1";  xreg_list="x1, x8-x9";}
default: reserved();
}
stack_adj      = stack_adj_base + spimm * 16;
```

```
RV32I, RV64:
switch (rlist){
  case  4: {reg_list="ra";         xreg_list="x1";}
  case  5: {reg_list="ra, s0";     xreg_list="x1, x8";}
  case  6: {reg_list="ra, s0-s1";  xreg_list="x1, x8-x9";}
  case  7: {reg_list="ra, s0-s2";  xreg_list="x1, x8-x9, x18";}
  case  8: {reg_list="ra, s0-s3";  xreg_list="x1, x8-x9, x18-x19";}
  case  9: {reg_list="ra, s0-s4";  xreg_list="x1, x8-x9, x18-x20";}
  case 10: {reg_list="ra, s0-s5";  xreg_list="x1, x8-x9, x18-x21";}
  case 11: {reg_list="ra, s0-s6";  xreg_list="x1, x8-x9, x18-x22";}
  case 12: {reg_list="ra, s0-s7";  xreg_list="x1, x8-x9, x18-x23";}
  case 13: {reg_list="ra, s0-s8";  xreg_list="x1, x8-x9, x18-x24";}
  case 14: {reg_list="ra, s0-s9";  xreg_list="x1, x8-x9, x18-x25";}
//注意 - 要包含s10，也必须包含s11
  case 15: {reg_list="ra, s0-s11"; xreg_list="x1, x8-x9, x18-x27";}
default: reserved();
}
stack_adj      = stack_adj_base + spimm * 16;
```

```
RV32E:
stack_adj_base = 16;
有效值:
stack_adj      = [16|32|48|64];
```

```
RV32I:
switch (rlist) {
  case  4.. 7: stack_adj_base = 16;
  case  8..11: stack_adj_base = 32;
  case 12..14: stack_adj_base = 48;
  case     15: stack_adj_base = 64;
}
有效值:
switch (rlist) {
  case  4.. 7: stack_adj = [16|32|48| 64];
  case  8..11: stack_adj = [32|48|64| 80];
  case 12..14: stack_adj = [48|64|80| 96];
  case     15: stack_adj = [64|80|96|112];
}
```

```
RV64:
switch (rlist) {
  case  4.. 5: stack_adj_base =  16;
  case  6.. 7: stack_adj_base =  32;
  case  8.. 9: stack_adj_base =  48;
  case 10..11: stack_adj_base =  64;
  case 12..13: stack_adj_base =  80;
  case     14: stack_adj_base =  96;
  case     15: stack_adj_base = 112;
}
有效值:
switch (rlist) {
  case  4.. 5: stack_adj = [ 16| 32| 48| 64];
  case  6.. 7: stack_adj = [ 32| 48| 64| 80];
  case  8.. 9: stack_adj = [ 48| 64| 80| 96];
  case 10..11: stack_adj = [ 64| 80| 96|112];
  case 12..13: stack_adj = [ 80| 96|112|128];
  case     14: stack_adj = [ 96|112|128|144];
  case     15: stack_adj = [112|128|144|160];
}
```

### 描述

此指令从栈内存弹出（加载）*reg_list*中的寄存器，然后将栈指针调整*stack_adj*。

**评论：** *所有ABI寄存器映射都是针对UABI的。一旦EABI冻结，计划推出EABI版本。*

更多信息请参见PUSH/POP寄存器指令。

栈调整计算：

*stack_adj_base*是覆盖列表中寄存器所需的最小字节数，以16字节地址增量倍数计算。

*spimm*是为栈帧分配的额外16字节地址增量的数量。

总栈调整量表示栈帧的总大小，即*stack_adj_base*加上*spimm*缩放16倍的值，如上所定义。

### 前置条件

无

32位等价指令：

不存在直接等价编码

### 操作

伪代码的第一部分可能在指令成功完成之前多次执行。

```
//这不是SAIL，是伪代码。SAIL尚未编写。
if (XLEN==32) bytes=4; else bytes=8;
addr=sp+stack_adj-bytes;
for(i in27,26,25,24,23,22,21,20,19,18,9,8,1)  {
//如果寄存器i在xreg_list中
if (xreg_list[i]) {
    switch(bytes) {
4:  asm("lw x[i], 0(addr)");
8:  asm("ld x[i], 0(addr)");
    }
    addr-=bytes;
  }
}
```

伪代码的最后部分原子执行，并且仅当上述部分在没有任何异常或中断的情况下完成时才执行。

```
//这不是SAIL，是伪代码。SAIL尚未编写。
sp+=stack_adj;
```

## 29.13.9. cm.popretz

### 概要

销毁栈帧：从栈帧加载ra和0到12个保存寄存器，释放栈帧，将零移入a0，返回ra。

### 助记符

cm.popretz *{reg_list}*, *stack_adj*

编码（RV32, RV64）：

|0<br>1<br>2<br>3<br>4<br>7<br>8<br>12<br>13<br>15|0<br>1<br>2<br>3<br>4<br>7<br>8<br>12<br>13<br>15|0<br>1<br>2<br>3<br>4<br>7<br>8<br>12<br>13<br>15|0<br>1<br>2<br>3<br>4<br>7<br>8<br>12<br>13<br>15|0<br>1<br>2<br>3<br>4<br>7<br>8<br>12<br>13<br>15|
|---|---|---|---|---|
|1<br>0<br>1|0<br>0<br>1<br>1<br>1|rlist|spimm[5:4]|0<br>1|
|C2<br>FUNCT3|||||

**评论：** *rlist值0到3保留用于未来的EABI变体，名为cm.popretz.e*

汇编语法：

```
cm.popretz {reg_list},  stack_adj
cm.popretz {xreg_list}, stack_adj
```

```
RV32E:
switch (rlist){
  case  4: {reg_list="ra";         xreg_list="x1";}
  case  5: {reg_list="ra, s0";     xreg_list="x1, x8";}
  case  6: {reg_list="ra, s0-s1";  xreg_list="x1, x8-x9";}
default: reserved();
}
stack_adj      = stack_adj_base + spimm * 16;
```

```
RV32I, RV64:

switch (rlist){
  case  4: {reg_list="ra";         xreg_list="x1";}
  case  5: {reg_list="ra, s0";     xreg_list="x1, x8";}
  case  6: {reg_list="ra, s0-s1";  xreg_list="x1, x8-x9";}
  case  7: {reg_list="ra, s0-s2";  xreg_list="x1, x8-x9, x18";}
  case  8: {reg_list="ra, s0-s3";  xreg_list="x1, x8-x9, x18-x19";}
  case  9: {reg_list="ra, s0-s4";  xreg_list="x1, x8-x9, x18-x20";}
  case 10: {reg_list="ra, s0-s5";  xreg_list="x1, x8-x9, x18-x21";}
  case 11: {reg_list="ra, s0-s6";  xreg_list="x1, x8-x9, x18-x22";}
  case 12: {reg_list="ra, s0-s7";  xreg_list="x1, x8-x9, x18-x23";}
  case 13: {reg_list="ra, s0-s8";  xreg_list="x1, x8-x9, x18-x24";}
  case 14: {reg_list="ra, s0-s9";  xreg_list="x1, x8-x9, x18-x25";}
//注意 - 要包含s10，也必须包含s11
  case 15: {reg_list="ra, s0-s11"; xreg_list="x1, x8-x9, x18-x27";}
default: reserved();
}
stack_adj      = stack_adj_base + spimm * 16;
```

```
RV32E:
stack_adj_base = 16;
有效值:
stack_adj      = [16|32|48|64];
```

```
RV32I:
switch (rlist) {
  case  4.. 7: stack_adj_base = 16;
  case  8..11: stack_adj_base = 32;
  case 12..14: stack_adj_base = 48;
  case     15: stack_adj_base = 64;
}
有效值:
switch (rlist) {
  case  4.. 7: stack_adj = [16|32|48| 64];
  case  8..11: stack_adj = [32|48|64| 80];
  case 12..14: stack_adj = [48|64|80| 96];
  case     15: stack_adj = [64|80|96|112];
}
```

```
RV64:
switch (rlist) {
  case  4.. 5: stack_adj_base =  16;
  case  6.. 7: stack_adj_base =  32;
  case  8.. 9: stack_adj_base =  48;
  case 10..11: stack_adj_base =  64;
  case 12..13: stack_adj_base =  80;
  case     14: stack_adj_base =  96;
  case     15: stack_adj_base = 112;
}
有效值:
switch (rlist) {
  case  4.. 5: stack_adj = [ 16| 32| 48| 64];
  case  6.. 7: stack_adj = [ 32| 48| 64| 80];
  case  8.. 9: stack_adj = [ 48| 64| 80| 96];
  case 10..11: stack_adj = [ 64| 80| 96|112];
  case 12..13: stack_adj = [ 80| 96|112|128];
  case     14: stack_adj = [ 96|112|128|144];
  case     15: stack_adj = [112|128|144|160];
}
```

### 描述

此指令从栈内存弹出（加载）*reg_list*中的寄存器，将栈指针调整*stack_adj*，将零移入a0，然后返回*ra*。

**评论：** *所有ABI寄存器映射都是针对UABI的。一旦EABI冻结，计划推出EABI版本。*

更多信息请参见PUSH/POP寄存器指令。

栈调整计算：

*stack_adj_base*是覆盖列表中寄存器所需的最小字节数，以16字节地址增量倍数计算。

*spimm*是为栈帧分配的额外16字节地址增量的数量。

总栈调整量表示栈帧的总大小，即*stack_adj_base*加上*spimm*缩放16倍的值，如上所定义。

### 前置条件

无

32位等价指令：

不存在直接等价编码

### 操作

伪代码的第一部分可能在指令成功完成之前多次执行。

```
//这不是SAIL，是伪代码。SAIL尚未编写。
if (XLEN==32) bytes=4; else bytes=8;
addr=sp+stack_adj-bytes;
for(i in27,26,25,24,23,22,21,20,19,18,9,8,1)  {
//如果寄存器i在xreg_list中
if (xreg_list[i]) {
    switch(bytes) {
4:  asm("lw x[i], 0(addr)");
8:  asm("ld x[i], 0(addr)");
    }
    addr-=bytes;
  }
}
```

伪代码的最后部分原子执行，并且仅当上述部分在没有任何异常或中断的情况下完成时才执行。

**评论：** *li a0, 0可以多次执行，但为方便起见包含在原子部分中。*

```
//这不是SAIL，是伪代码。SAIL尚未编写。
asm("li a0, 0");
sp+=stack_adj;
asm("ret");
```

## 29.13.10. cm.popret

### 概要

销毁栈帧：从栈帧加载ra和0到12个保存寄存器，释放栈帧，返回ra。

### 助记符

cm.popret *{reg_list}*, *stack_adj*

编码（RV32, RV64）：

|0<br>1<br>2<br>3<br>4<br>7<br>8<br>12<br>13<br>15|0<br>1<br>2<br>3<br>4<br>7<br>8<br>12<br>13<br>15|0<br>1<br>2<br>3<br>4<br>7<br>8<br>12<br>13<br>15|0<br>1<br>2<br>3<br>4<br>7<br>8<br>12<br>13<br>15|0<br>1<br>2<br>3<br>4<br>7<br>8<br>12<br>13<br>15|
|---|---|---|---|---|
|1<br>0<br>1|0<br>1<br>1<br>1<br>1|rlist|spimm|0<br>1|
|C2<br>FUNCT3|||||

**评论：** *rlist值0到3保留用于未来的EABI变体，名为cm.popret.e*

汇编语法：

```
cm.popret {reg_list},  stack_adj
cm.popret {xreg_list}, stack_adj
```

汇编语法中使用的变量定义如下。

```
RV32E:
switch (rlist){
  case  4: {reg_list="ra";         xreg_list="x1";}
  case  5: {reg_list="ra, s0";     xreg_list="x1, x8";}
  case  6: {reg_list="ra, s0-s1";  xreg_list="x1, x8-x9";}
default: reserved();
}
stack_adj      = stack_adj_base + spimm * 16;
```

```
RV32I, RV64:
switch (rlist){
  case  4: {reg_list="ra";         xreg_list="x1";}
  case  5: {reg_list="ra, s0";     xreg_list="x1, x8";}
  case  6: {reg_list="ra, s0-s1";  xreg_list="x1, x8-x9";}
  case  7: {reg_list="ra, s0-s2";  xreg_list="x1, x8-x9, x18";}
  case  8: {reg_list="ra, s0-s3";  xreg_list="x1, x8-x9, x18-x19";}
  case  9: {reg_list="ra, s0-s4";  xreg_list="x1, x8-x9, x18-x20";}
  case 10: {reg_list="ra, s0-s5";  xreg_list="x1, x8-x9, x18-x21";}
  case 11: {reg_list="ra, s0-s6";  xreg_list="x1, x8-x9, x18-x22";}
  case 12: {reg_list="ra, s0-s7";  xreg_list="x1, x8-x9, x18-x23";}
  case 13: {reg_list="ra, s0-s8";  xreg_list="x1, x8-x9, x18-x24";}
  case 14: {reg_list="ra, s0-s9";  xreg_list="x1, x8-x9, x18-x25";}
//注意 - 要包含s10，也必须包含s11
  case 15: {reg_list="ra, s0-s11"; xreg_list="x1, x8-x9, x18-x27";}
default: reserved();
}
stack_adj      = stack_adj_base + spimm * 16;
```

```
RV32E:
stack_adj_base = 16;
有效值:
stack_adj      = [16|32|48|64];
```

```
RV32I:
switch (rlist) {
  case  4.. 7: stack_adj_base = 16;
  case  8..11: stack_adj_base = 32;
  case 12..14: stack_adj_base = 48;
  case     15: stack_adj_base = 64;
}
有效值:
switch (rlist) {
  case  4.. 7: stack_adj = [16|32|48| 64];
  case  8..11: stack_adj = [32|48|64| 80];
  case 12..14: stack_adj = [48|64|80| 96];
  case     15: stack_adj = [64|80|96|112];
}
```

```
RV64:
switch (rlist) {
  case  4.. 5: stack_adj_base =  16;
  case  6.. 7: stack_adj_base =  32;
  case  8.. 9: stack_adj_base =  48;
  case 10..11: stack_adj_base =  64;
  case 12..13: stack_adj_base =  80;
  case     14: stack_adj_base =  96;
  case     15: stack_adj_base = 112;
}
有效值:
switch (rlist) {
  case  4.. 5: stack_adj = [ 16| 32| 48| 64];
  case  6.. 7: stack_adj = [ 32| 48| 64| 80];
  case  8.. 9: stack_adj = [ 48| 64| 80| 96];
  case 10..11: stack_adj = [ 64| 80| 96|112];
  case 12..13: stack_adj = [ 80| 96|112|128];
  case     14: stack_adj = [ 96|112|128|144];
  case     15: stack_adj = [112|128|144|160];
}
```

### 描述

此指令从栈内存弹出（加载）*reg_list*中的寄存器，将栈指针调整*stack_adj*，然后返回*ra*。

**评论：** *所有ABI寄存器映射都是针对UABI的。一旦EABI冻结，计划推出EABI版本。*

更多信息请参见PUSH/POP寄存器指令。

栈调整计算：

*stack_adj_base*是覆盖列表中寄存器所需的最小字节数，以16字节地址增量倍数计算。

*spimm*是为栈帧分配的额外16字节地址增量的数量。

总栈调整量表示栈帧的总大小，即*stack_adj_base*加上*spimm*缩放16倍的值，如上所定义。

### 前置条件

无

32位等价指令：

不存在直接等价编码

### 操作

伪代码的第一部分可能在指令成功完成之前多次执行。

```
//这不是SAIL，是伪代码。SAIL尚未编写。
if (XLEN==32) bytes=4; else bytes=8;
addr=sp+stack_adj-bytes;
for(i in27,26,25,24,23,22,21,20,19,18,9,8,1)  {
//如果寄存器i在xreg_list中
if (xreg_list[i]) {
    switch(bytes) {
4:  asm("lw x[i], 0(addr)");
8:  asm("ld x[i], 0(addr)");
    }
    addr-=bytes;
  }
}
```

伪代码的最后部分原子执行，并且仅当上述部分在没有任何异常或中断的情况下完成时才执行。

```
//这不是SAIL，是伪代码。SAIL尚未编写。
sp+=stack_adj;
asm("ret");
```

## 29.13.11. cm.mvsa01

### 概要

将a0-a1移动到s0-s7的两个寄存器中

### 助记符

cm.mvsa01 *r1s'* , *r2s'*

编码（RV32, RV64）：

|0<br>1<br>2<br>4<br>5<br>6<br>7<br>9<br>10<br>12<br>13<br>15|0<br>1<br>2<br>4<br>5<br>6<br>7<br>9<br>10<br>12<br>13<br>15|0<br>1<br>2<br>4<br>5<br>6<br>7<br>9<br>10<br>12<br>13<br>15|0<br>1<br>2<br>4<br>5<br>6<br>7<br>9<br>10<br>12<br>13<br>15|0<br>1<br>2<br>4<br>5<br>6<br>7<br>9<br>10<br>12<br>13<br>15|0<br>1<br>2<br>4<br>5<br>6<br>7<br>9<br>10<br>12<br>13<br>15|
|---|---|---|---|---|---|---|
|1<br>0<br>1|1<br>1<br>0|r1s'|1<br>0|r2s'|0<br>1|
|C2<br>FUNCT3|||||||

**评论：** *要使编码合法，r1s' != r2s'。*

汇编语法：

```
cm.mvsa01 r1s', r2s'
```

### 描述

此指令将*a0*移入*r1s'*，将*a1*移入*r2s'*。*r1s'*和*r2s'*必须不同。执行是原子的，因此不可能观察到只有*r1s'*或*r2s'*之一已更新的状态。

编码使用*sreg*编号指示符而不是*xreg*编号指示符以节省编码空间。它们之间的映射在下面的伪代码中指定。

**评论：** *s寄存器映射取自UABI，可能与当前未批准的EABI不匹配。未来可能包含cm.mvsa01.e。*

### 前置条件

无

32位等价指令：

不存在直接等价编码。

### 操作

```
//这不是SAIL，是伪代码。SAIL尚未编写。
if (RV32E && (r1sc>1 || r2sc>1)) {
  reserved();
}
xreg1 = {r1sc[2:1]>0,r1sc[2:1]==0,r1sc[2:0]};
xreg2 = {r2sc[2:1]>0,r2sc[2:1]==0,r2sc[2:0]};
X[xreg1] = X[10];
X[xreg2] = X[11];
```

## 29.13.12. cm.mva01s

### 概要

将两个s0-s7寄存器移动到a0-a1

### 助记符

cm.mva01s *r1s'* , *r2s'*

编码（RV32, RV64）：

|0<br>1<br>2<br>4<br>5<br>6<br>7<br>9<br>10<br>12<br>13<br>15|0<br>1<br>2<br>4<br>5<br>6<br>7<br>9<br>10<br>12<br>13<br>15|0<br>1<br>2<br>4<br>5<br>6<br>7<br>9<br>10<br>12<br>13<br>15|0<br>1<br>2<br>4<br>5<br>6<br>7<br>9<br>10<br>12<br>13<br>15|0<br>1<br>2<br>4<br>5<br>6<br>7<br>9<br>10<br>12<br>13<br>15|0<br>1<br>2<br>4<br>5<br>6<br>7<br>9<br>10<br>12<br>13<br>15|
|---|---|---|---|---|---|---|
|1<br>0<br>1|1<br>1<br>0|r1s'|1<br>1|r2s'|0<br>1|
|C2<br>FUNCT3|||||||

汇编语法：

```
cm.mva01s r1s', r2s'
```

### 描述

此指令将*r1s'*移入*a0*，将*r2s'*移入*a1*。执行是原子的，因此不可能观察到只有*a0*或*a1*之一已更新的状态。

编码使用*sreg*编号指示符而不是*xreg*编号指示符以节省编码空间。它们之间的映射在下面的伪代码中指定。

**评论：** *s寄存器映射取自UABI，可能与当前未批准的EABI不匹配。未来可能包含cm.mva01s.e。*

### 前置条件

无

32位等价指令：

不存在直接等价编码。

### 操作

```
//这不是SAIL，是伪代码。SAIL尚未编写。
if (RV32E && (r1sc>1 || r2sc>1)) {
  reserved();
}
xreg1 = {r1sc[2:1]>0,r1sc[2:1]==0,r1sc[2:0]};
xreg2 = {r2sc[2:1]>0,r2sc[2:1]==0,r2sc[2:0]};
X[10] = X[xreg1];
X[11] = X[xreg2];
```

## 29.14. 表跳转概述

*cm.jt*（通过表跳转）和*cm.jalt*（通过表跳转并链接）被称为表跳转。

表跳转在指令内存中使用一个256条目XLEN宽的表来包含函数地址。表必须至少64字节对齐。

表条目遵循当前数据字节序。这与始终为小端序的正常指令获取不同。

*cm.jt*和*cm.jalt*编码索引该表，允许访问完整XLEN宽地址空间中的函数。

这被用作一种字典压缩形式，以减少*jal* / *auipc+jalr* / *jr* / *auipc+jr*指令的代码大小。

表跳转允许链接器用*cm.jt*或*cm.jalt*编码以及表中的一个条目替换以下指令序列：

- 32位*j*调用
- 32位*jal* ra调用
- 64位*auipc+jr*调用到固定位置
- 64位*auipc+jalr ra*调用到固定位置
  - 使用*auipc+jr/jalr*序列是因为从PC的偏移超出了±1 MB范围。

如果实现了返回地址栈，那么由于*cm.jalt*等价于*jal ra*，它会被压入栈。

## 29.14.1. jvt

表的基址位于jvt CSR中（参见jvt CSR，表跳转基向量和控制寄存器），每个表条目是XLEN位。

如果同一个函数被以链接和不链接两种方式调用，则它必须在表中有两个条目。这通常由同一个函数被以尾调用和非尾调用方式调用引起。

## 29.14.2. 表跳转故障处理

对于表跳转指令，指令选择的表条目被视为指令本身的扩展。因此，表跳转指令的执行涉及两次指令获取，第一次读取指令（*cm.jt* / *cm.jalt*），第二次从跳转向量表（JVT）读取。两次指令获取都是*隐式*读取，并且都需要执行权限；读取权限不相关。建议第二次获取被硬件触发器和断点忽略。

对跳转向量表的内存写入需要指令屏障（*fence.i*）来保证它们对指令获取可见。

多个上下文可能具有不同的跳转向量表。如果自上次*fence.i*以来内存中的表未被更新，则可以在它们之间切换JVT而无需指令屏障。

如果任一次指令获取发生异常，xEPC设置为表跳转指令的PC，xCAUSE设置为预期的故障类型，xTVAL（如果未设置为零）包含导致故障的获取地址。

## 29.14.3. jvt CSR

### 概要

表跳转基向量和控制寄存器

地址：

0x017

权限：

URW

格式（RV32）：

```
31          6  5      0
base[XLEN-1:6] (WARL) mode
XLEN-6              6
```

格式（RV64）：

```
63          6  5      0
base[XLEN-1:6] (WARL) mode
XLEN-6              6
```

### 描述

*jvt*寄存器是一个XLEN位WARL读/写寄存器，保存跳转表配置，包括跳转表基地址（BASE）和跳转表模式（MODE）。

如果实现了第29.10节，则*jvt*也必须实现，但可以包含只读值。如果*jvt*是可写的，寄存器可持有的值集可能因实现而异。BASE字段中的值必须始终在64字节边界上对齐。注意CSR仅包含地址*base*的XLEN-1到6位。在计算跳转表访问时，*base*的低六位填充零以获得XLEN位跳转表基地址*jvt.base*，该地址始终在64字节边界上对齐。

*jvt.base*在启用虚拟内存时是虚拟地址。

*jvt.base*指向的内存被视为指令内存，用于执行表跳转指令，意味着具有执行访问权限。

*表41. jvt.mode定义*

||*表41. jvt.mode定义*|
|---|---|
|jvt.mode|注释|
|000000|跳转表模式|
|其他|保留用于未来标准使用|

*jvt.mode*是一个WARL字段，因此只能被编程为已实现的模式。因此发现机制是尝试编程不同的模式并读回值以查看哪些可用。跳转表模式*必须*被实现。

**评论：** *未来RISC-V Unified Discovery方法将报告可用模式。*

### 架构状态

*jvt* CSR向系统软件上下文（如OS进程）添加架构状态，因此必须在上下文切换时保存/恢复。

## 29.14.4. cm.jt

### 概要

通过表跳转

### 助记符

cm.jt *index*

编码（RV32, RV64）：

|0<br>1<br>2<br>9<br>10<br>12<br>13<br>15|0<br>1<br>2<br>9<br>10<br>12<br>13<br>15|0<br>1<br>2<br>9<br>10<br>12<br>13<br>15|0<br>1<br>2<br>9<br>10<br>12<br>13<br>15|
|---|---|---|---|
|1<br>0<br>1|0<br>0<br>0|index|0<br>1|
|C2<br>FUNCT3||||

**评论：** *要使此编码解码为cm.jt，index<32，否则解码为cm.jalt，参见通过表跳转并链接。*

**评论：** *如果jvt.mode = 0（跳转表模式），则cm.jt按此处指定的行为执行。如果jvt.mode是保留值，则cm.jt也被保留。未来其他定义的jvt.mode值可能改变cm.jt的行为。*

汇编语法：

```
cm.jt index
```

### 描述

*cm.jt*从内存中的跳转向量表读取一个条目，并跳转到读取的地址。

更多信息请参见表跳转概述。

### 前置条件

无

32位等价指令：

不存在直接等价编码。

### 操作

```
//这不是SAIL，是伪代码。SAIL尚未编写。
# table_address是临时内部状态，不代表真实寄存器
# InstMemory是按字节索引的
switch(XLEN) {
32:  table_address[XLEN-1:0] = jvt.base + (index<<2);
64:  table_address[XLEN-1:0] = jvt.base + (index<<3);
}
//从跳转表获取
pc = InstMemory[table_address][XLEN-1:0]&~0x1;  // 清除位0。
```

## 29.14.5. cm.jalt

### 概要

通过表跳转并可选链接

### 助记符

cm.jalt *index*

编码（RV32, RV64）：

|0<br>1<br>2<br>9<br>10<br>12<br>13<br>15|0<br>1<br>2<br>9<br>10<br>12<br>13<br>15|0<br>1<br>2<br>9<br>10<br>12<br>13<br>15|0<br>1<br>2<br>9<br>10<br>12<br>13<br>15|
|---|---|---|---|
|1<br>0<br>1|0<br>0<br>0|index|0<br>1|
|C2<br>FUNCT3||||

**评论：** *要使此编码解码为cm.jalt，index>=32，否则解码为cm.jt，参见通过表跳转。*

**评论：** *如果jvt.mode = 0（跳转表模式），则cm.jalt按此处指定的行为执行。如果jvt.mode是保留值，则cm.jalt也被保留。未来其他定义的jvt.mode值可能改变cm.jalt的行为。*

汇编语法：

```
cm.jalt index
```

### 描述

*cm.jalt*从内存中的跳转向量表读取一个条目，并跳转到读取的地址，链接到*ra*。

更多信息请参见表跳转概述。

### 前置条件

无

32位等价指令：

不存在直接等价编码。

### 操作

```
//这不是SAIL，是伪代码。SAIL尚未编写。
# table_address是临时内部状态，不代表真实寄存器
# InstMemory是按字节索引的
switch(XLEN) {
32:  table_address[XLEN-1:0] = jvt.base + (index<<2);
64:  table_address[XLEN-1:0] = jvt.base + (index<<3);
}
//从跳转表获取
ra = pc+2;
pc = InstMemory[table_address][XLEN-1:0]&~0x1;  // 清除位0。
```
