Degeneracy-Evil/cpu-designers/Reference/plantUML/README.md

# PlantUML 语言参考指引

本文档由 [PlantUML_Language_Reference_Guide_zh.pdf](./PlantUML_Language_Reference_Guide_zh.pdf) 自动提取生成。

版本: 1.2025.0

## 目录

| 章节 | 标题 | 文件 |
|---|---|---|
| 00 | 封面与介绍 | [ch00_封面与介绍.md](./ch00_封面与介绍.md) |
| 01 | 序列图 | [ch01_序列图.md](./ch01_序列图.md) |
| 02 | 用例图 | [ch02_用例图.md](./ch02_用例图.md) |
| 03 | 类图 | [ch03_类图.md](./ch03_类图.md) |
| 04 | 对象图 | [ch04_对象图.md](./ch04_对象图.md) |
| 05 | 活动图（旧语法） | [ch05_活动图（旧语法）.md](./ch05_活动图（旧语法）.md) |
| 06 | 活动图（新语法） | [ch06_活动图（新语法）.md](./ch06_活动图（新语法）.md) |
| 07 | 组件图 | [ch07_组件图.md](./ch07_组件图.md) |
| 08 | 部署图 | [ch08_部署图.md](./ch08_部署图.md) |
| 09 | 状态图 | [ch09_状态图.md](./ch09_状态图.md) |
| 10 | 定时图 | [ch10_定时图.md](./ch10_定时图.md) |
| 11 | JSON数据显示效果图 | [ch11_JSON数据显示效果图.md](./ch11_JSON数据显示效果图.md) |
| 12 | YAML显示效果图 | [ch12_YAML显示效果图.md](./ch12_YAML显示效果图.md) |
| 13 | 网络图(nwdiag) | [ch13_网络图(nwdiag).md](./ch13_网络图(nwdiag).md) |
| 14 | 线框图形界面(Salt) | [ch14_线框图形界面(Salt).md](./ch14_线框图形界面(Salt).md) |
| 15 | 架构图(Archimate) | [ch15_架构图(Archimate).md](./ch15_架构图(Archimate).md) |
| 16 | 甘特图 | [ch16_甘特图.md](./ch16_甘特图.md) |
| 17 | 思维导图(MindMap) | [ch17_思维导图(MindMap).md](./ch17_思维导图(MindMap).md) |
| 18 | 工作分解结构(WBS) | [ch18_工作分解结构(WBS).md](./ch18_工作分解结构(WBS).md) |
| 19 | 数学 | [ch19_数学.md](./ch19_数学.md) |
| 20 | 实体关系图(ER) | [ch20_实体关系图(ER).md](./ch20_实体关系图(ER).md) |
| 21 | 通用命令 | [ch21_通用命令.md](./ch21_通用命令.md) |
| 22 | Creole | [ch22_Creole.md](./ch22_Creole.md) |
| 23 | 精灵图(Sprite) | [ch23_精灵图(Sprite).md](./ch23_精灵图(Sprite).md) |
| 24 | 外观参数(Skinparam) | [ch24_外观参数(Skinparam).md](./ch24_外观参数(Skinparam).md) |
| 25 | 预处理 | [ch25_预处理.md](./ch25_预处理.md) |
| 26 | Ditaa | [ch26_Ditaa.md](./ch26_Ditaa.md) |
| 27 | 标准库(StdLib) | [ch27_标准库(StdLib).md](./ch27_标准库(StdLib).md) |
| 28 | 附录-目录索引 | [ch28_附录-目录索引.md](./ch28_附录-目录索引.md) |
