Degeneracy-Evil/cpu-designers/process/A-extension-process.md

# A 扩展（原子指令）实施进度

> 创建日期: 2026-06-15 | 关联计划: `plan/A-extension-implementation.md`

---

## 总体进度

| Phase | 内容 | 状态 | 完成日期 |
|---|---|---|---|
| Phase 1 | 流水线总线扩展 | ✅ 完成 | 2026-06-15 |
| Phase 2 | 译码级 A 扩展指令识别 | ✅ 完成 | 2026-06-15 |
| Phase 3 | 执行级信号透传 | ✅ 完成 | 2026-06-15 |
| Phase 4 | 访存级 AMO FSM + 保留集 + AMO 计算 | ✅ 完成 | 2026-06-15 |
| Phase 5 | 核心顶层连线 + CSR 更新 | ✅ 完成 | 2026-06-15 |
| Phase 6 | 测试程序 + Testbench | ✅ 完成 | 2026-06-15 |
| Phase 7 | 仿真验证 + Bug 修复 | ✅ 完成 | 2026-06-15 |

---
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
