Degeneracy-Evil/cpu-designers/Report/media/cache仿真结果.png

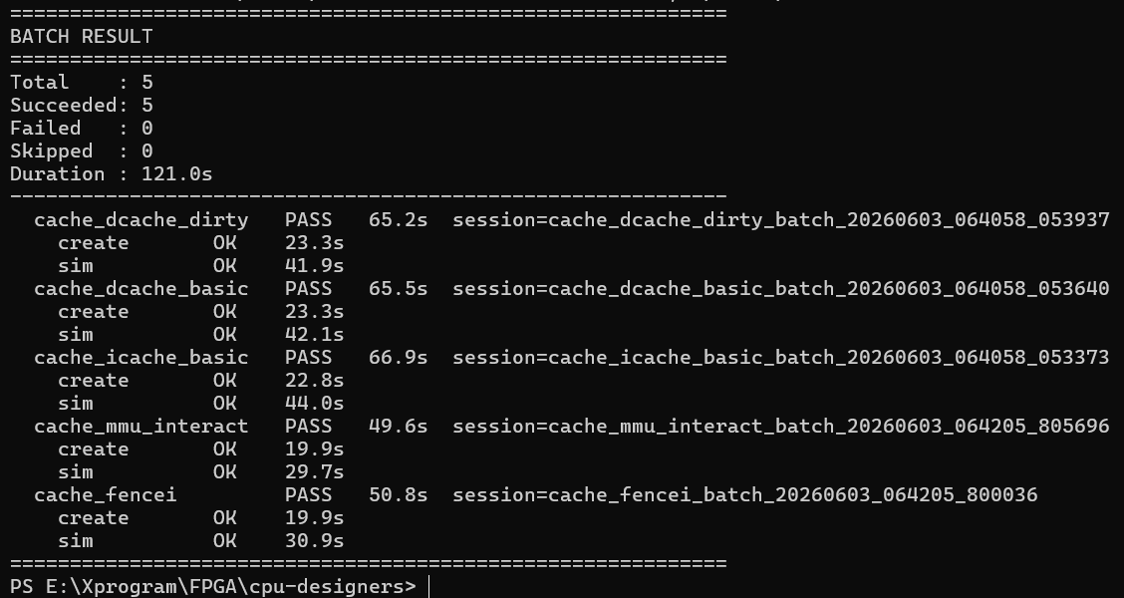
Report/media/cache仿真结果.png
