Degeneracy-Evil/cpu-designers/Report/media/cpu1-控制台.png

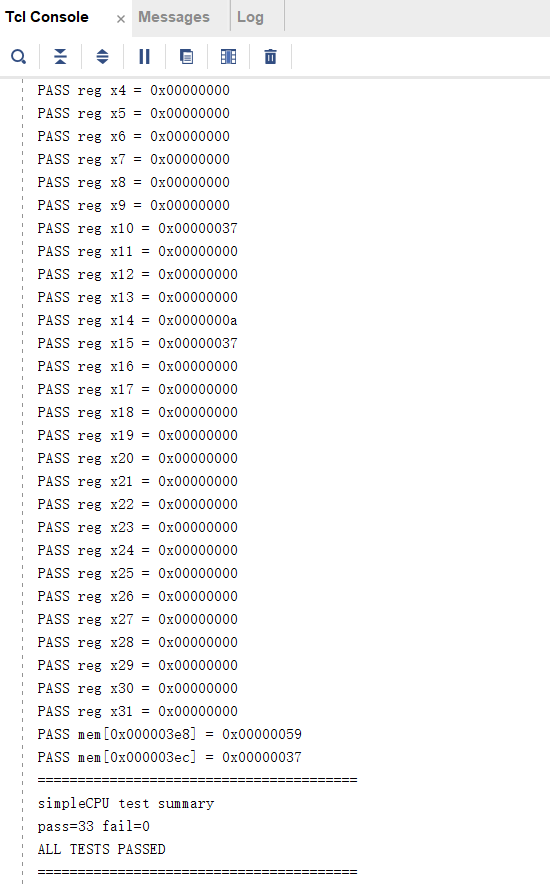
Report/media/cpu1-控制台.png
