Degeneracy-Evil/cpu-designers/Report/media/cpu1-波形.png

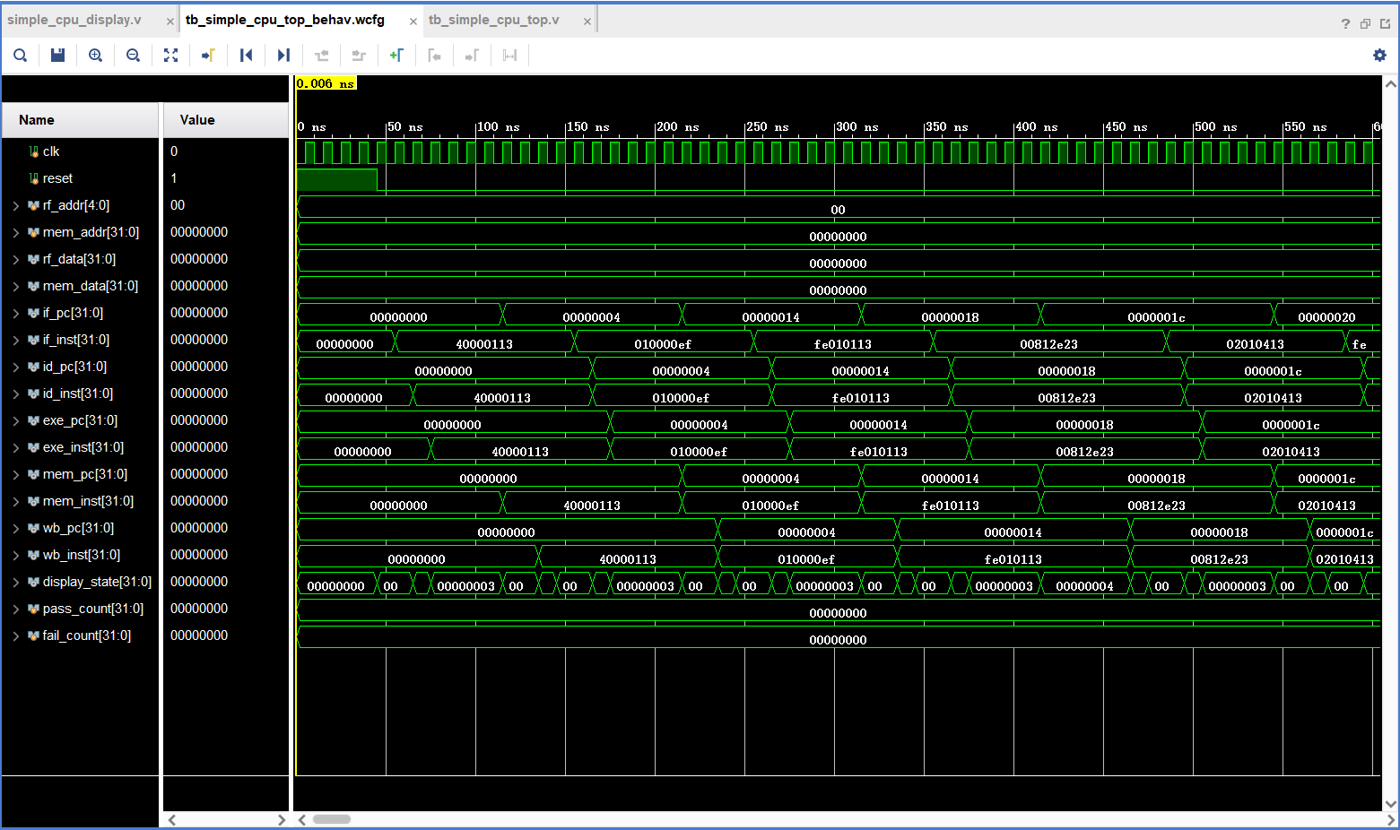
Report/media/cpu1-波形.png
