Degeneracy-Evil/cpu-designers/Report/media/dcache_basic_控制台.png

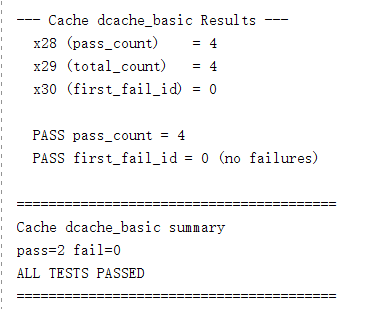
Report/media/dcache_basic_控制台.png
