Degeneracy-Evil/cpu-designers/Report/media/dcache_basic_波形图.png

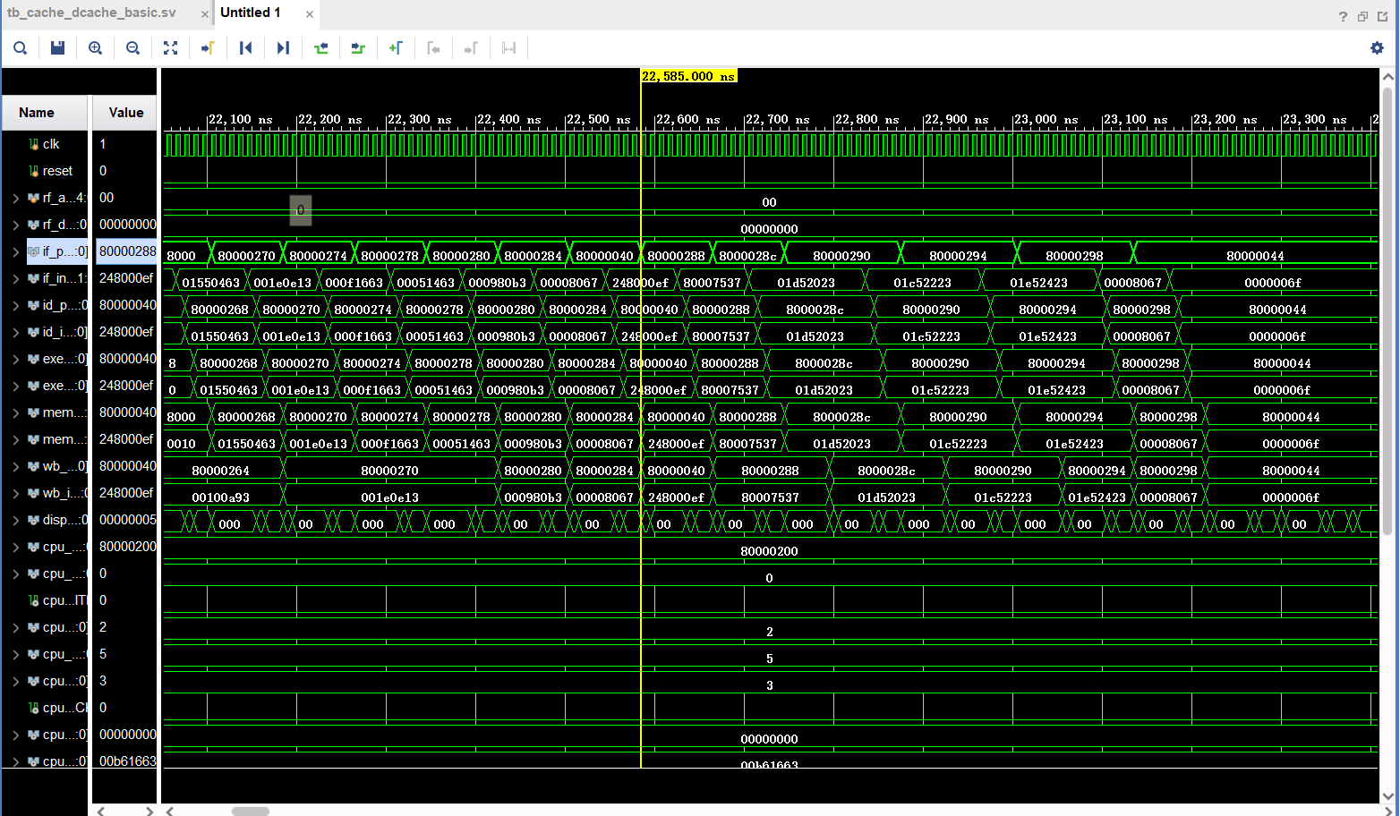
Report/media/dcache_basic_波形图.png
