Degeneracy-Evil/cpu-designers/Report/media/fib10-37.jpg

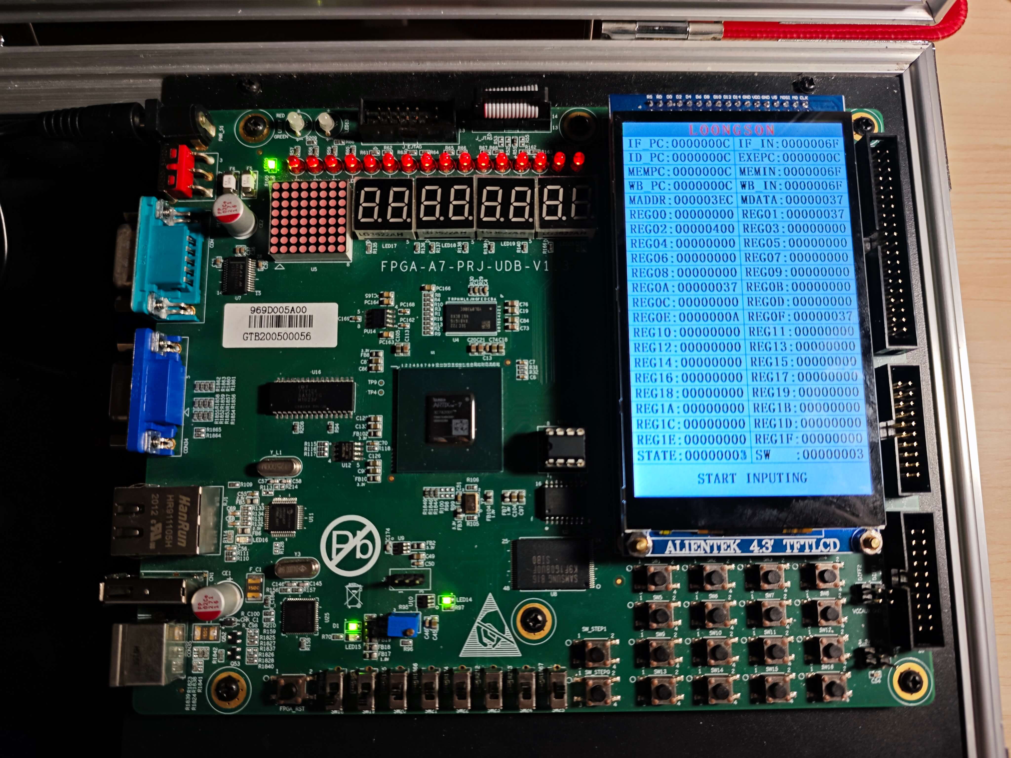
Report/media/fib10-37.jpg
