Degeneracy-Evil/cpu-designers/Report/media/fib10-55.jpg

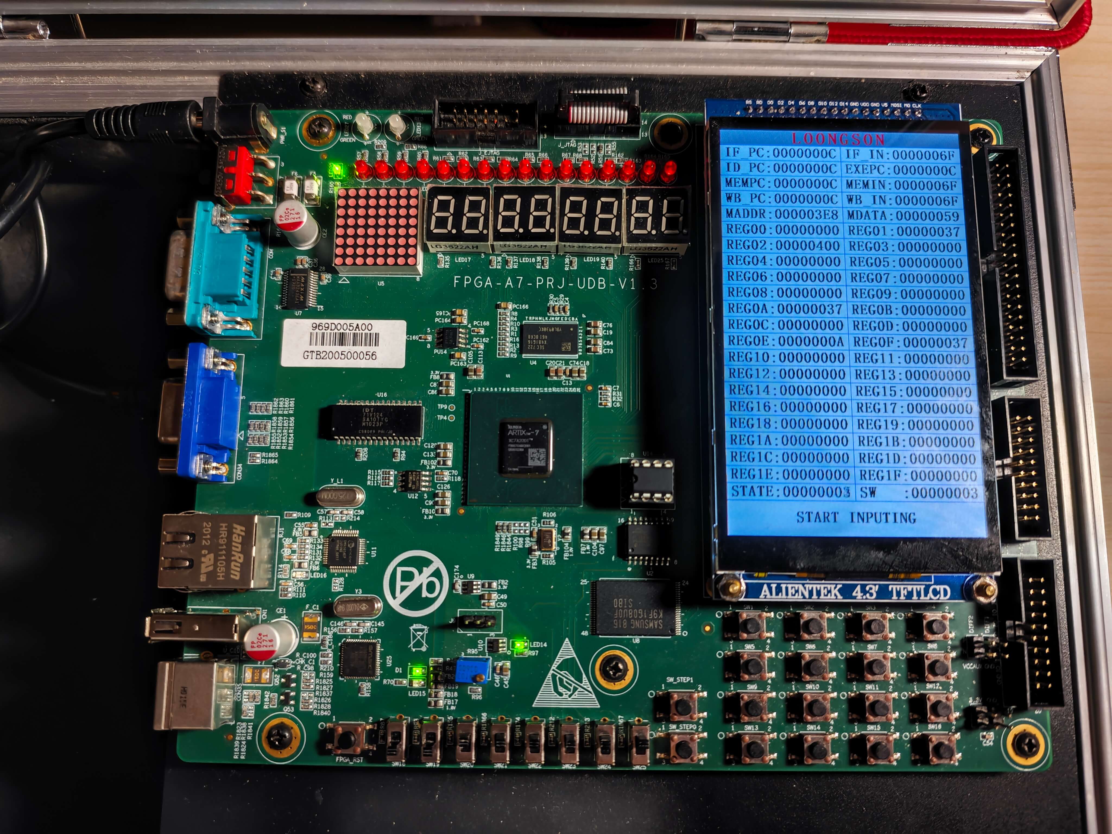
Report/media/fib10-55.jpg
