Degeneracy-Evil/cpu-designers/Report/media/Linux-1.png

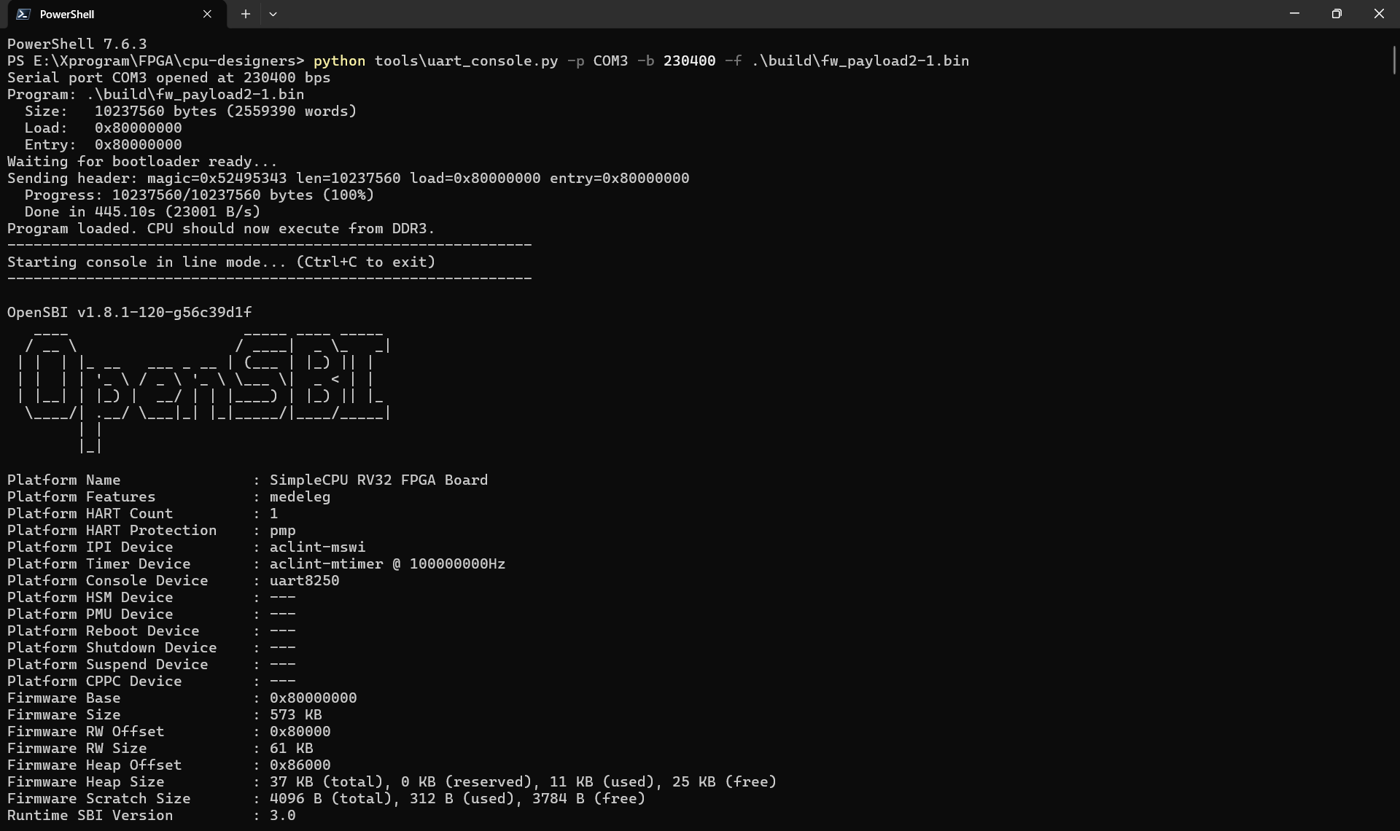
Report/media/Linux-1.png
