Degeneracy-Evil/cpu-designers/Report/media/Linux-2.png

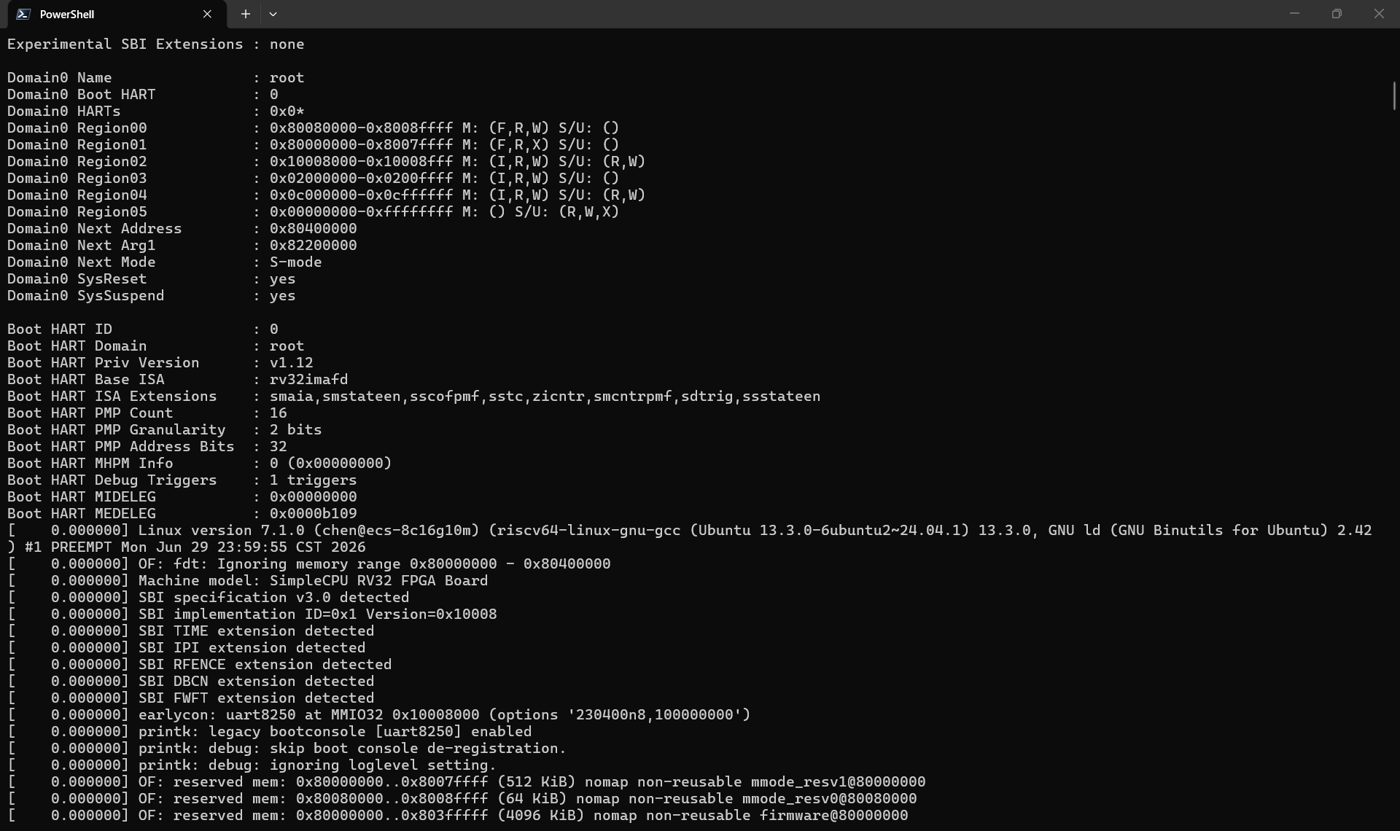
Report/media/Linux-2.png
