Degeneracy-Evil/cpu-designers/Report/media/Linux-3.png

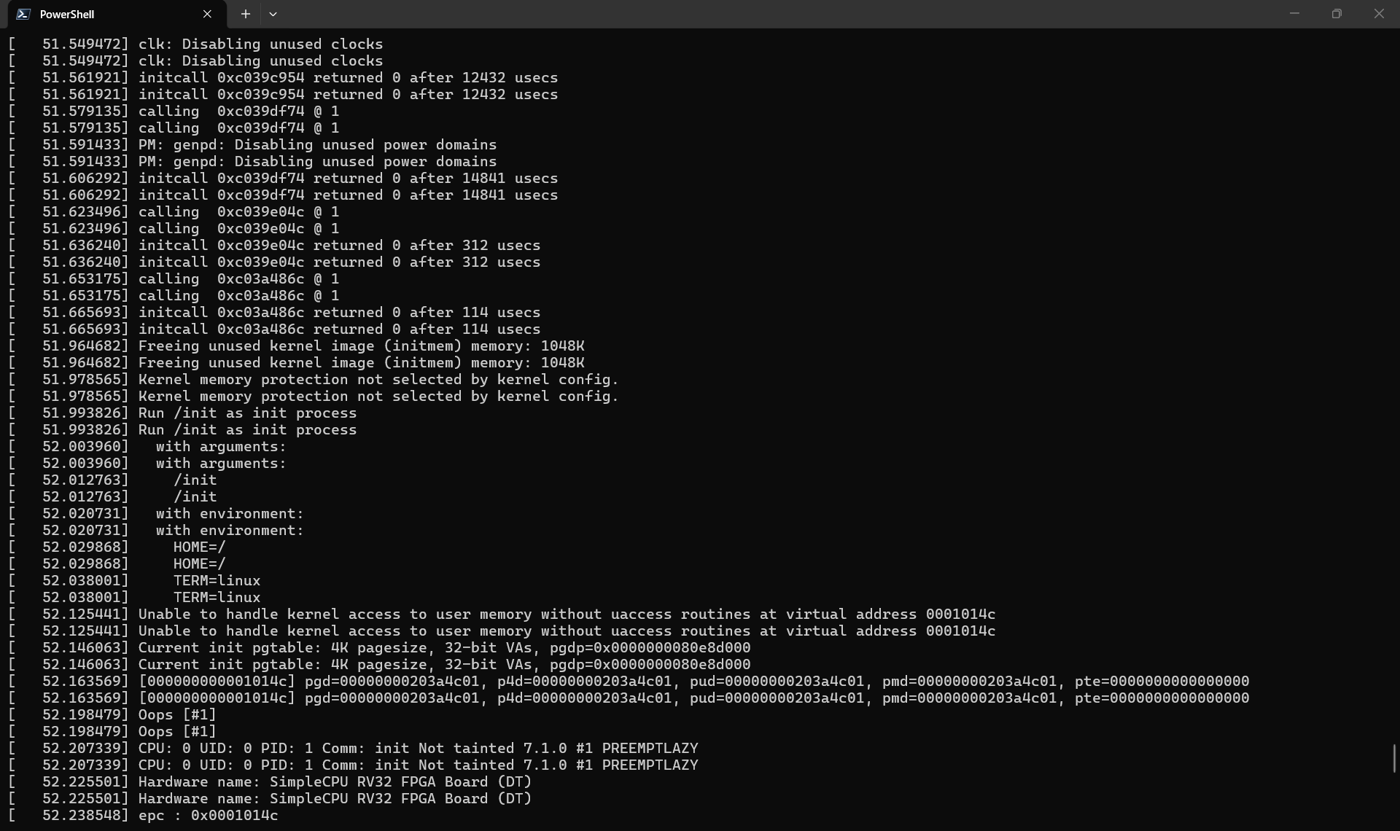
Report/media/Linux-3.png
