Degeneracy-Evil/cpu-designers/Report/media/linux_lcd.jpg

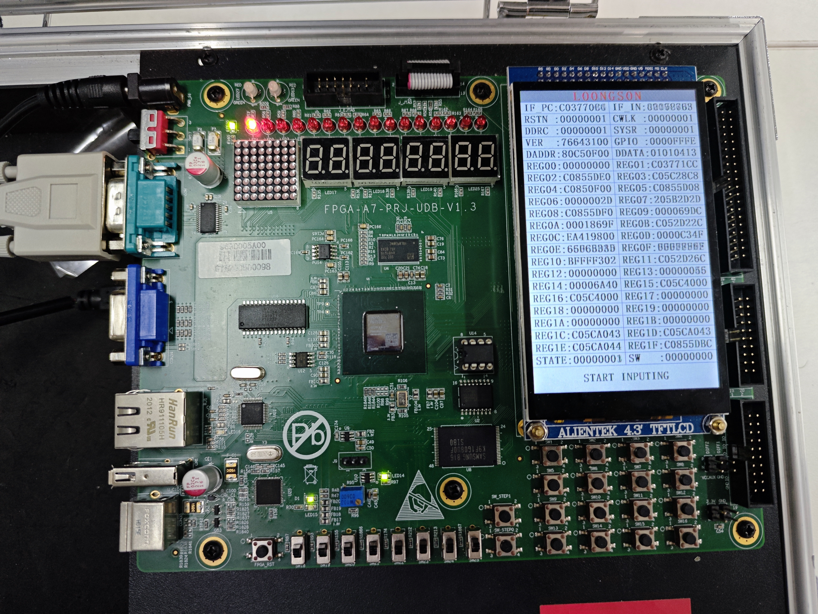
Report/media/linux_lcd.jpg
