Degeneracy-Evil/cpu-designers/Report/media/MMU架构.png

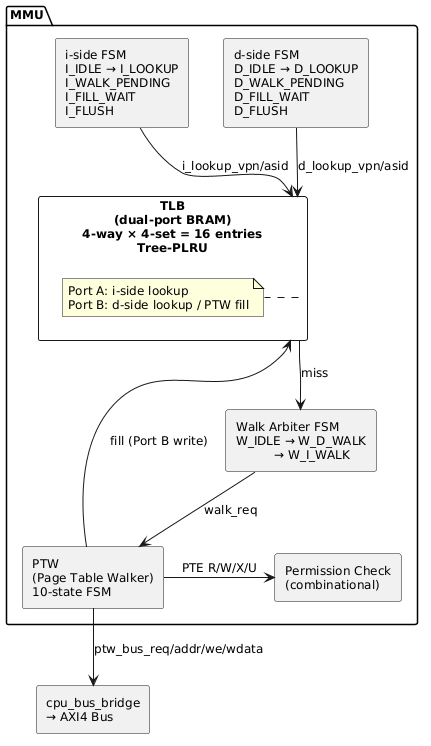
Report/media/MMU架构.png
