Degeneracy-Evil/cpu-designers/Report/media/simpleos_lcd.jpg

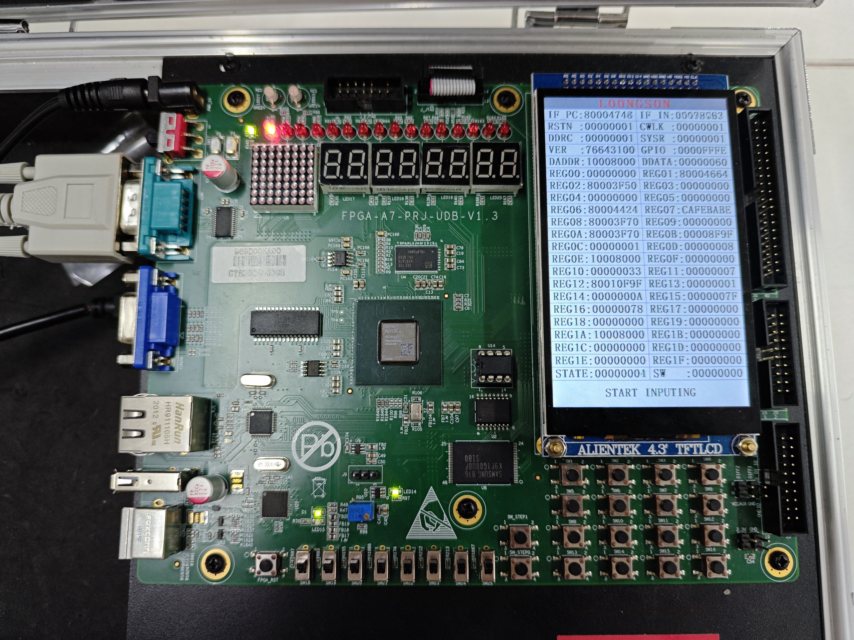
Report/media/simpleos_lcd.jpg
