Degeneracy-Evil/cpu-designers/Report/media/simpleos_uart.png

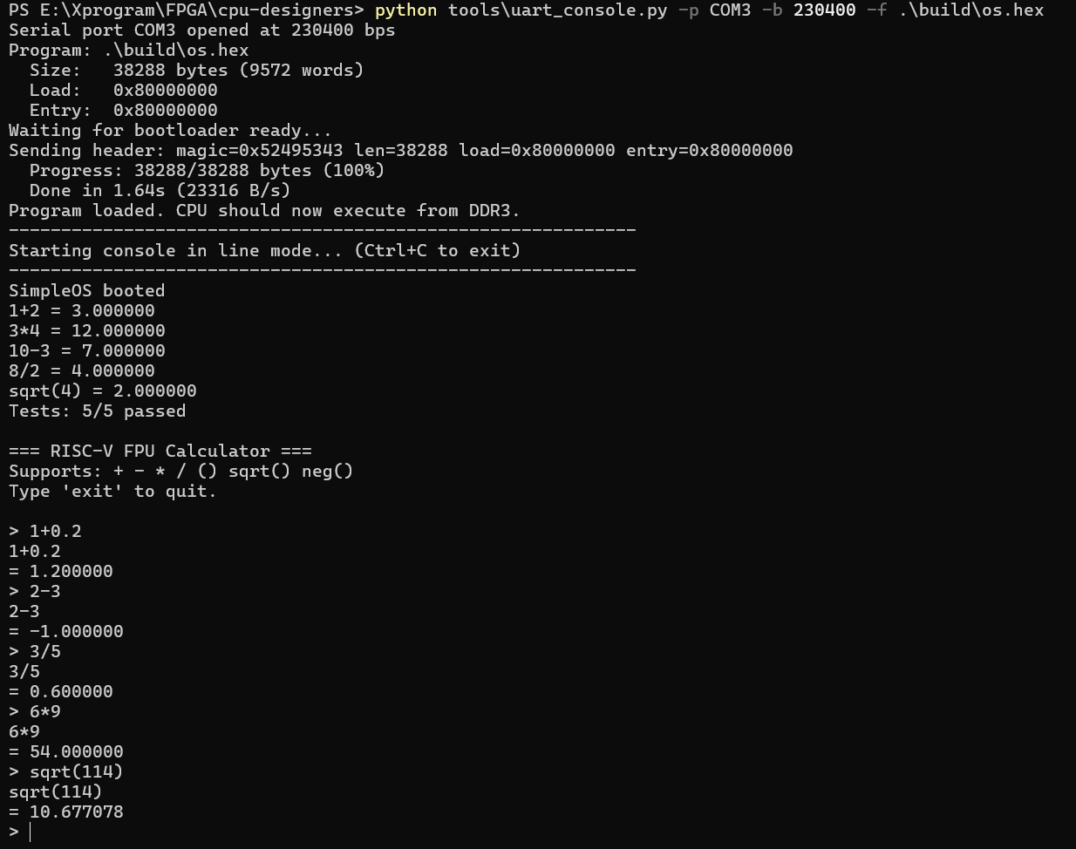
Report/media/simpleos_uart.png
