Degeneracy-Evil/cpu-designers/Report/media/Sv32页表漫游序列图.png

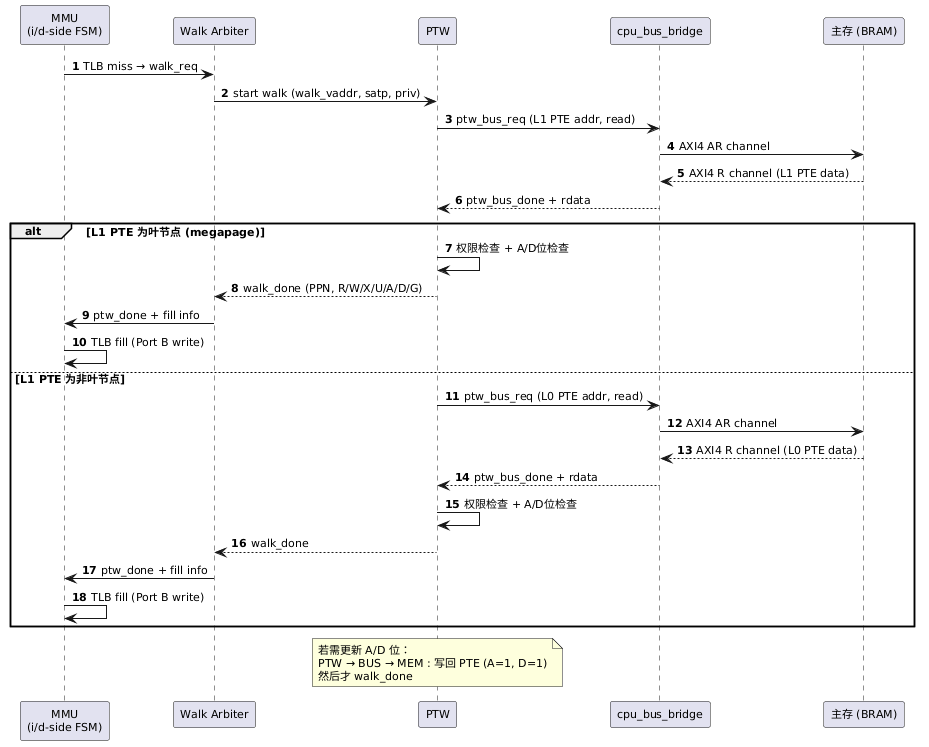
Report/media/Sv32页表漫游序列图.png
