Degeneracy-Evil/cpu-designers/Report/media/uart.jpg

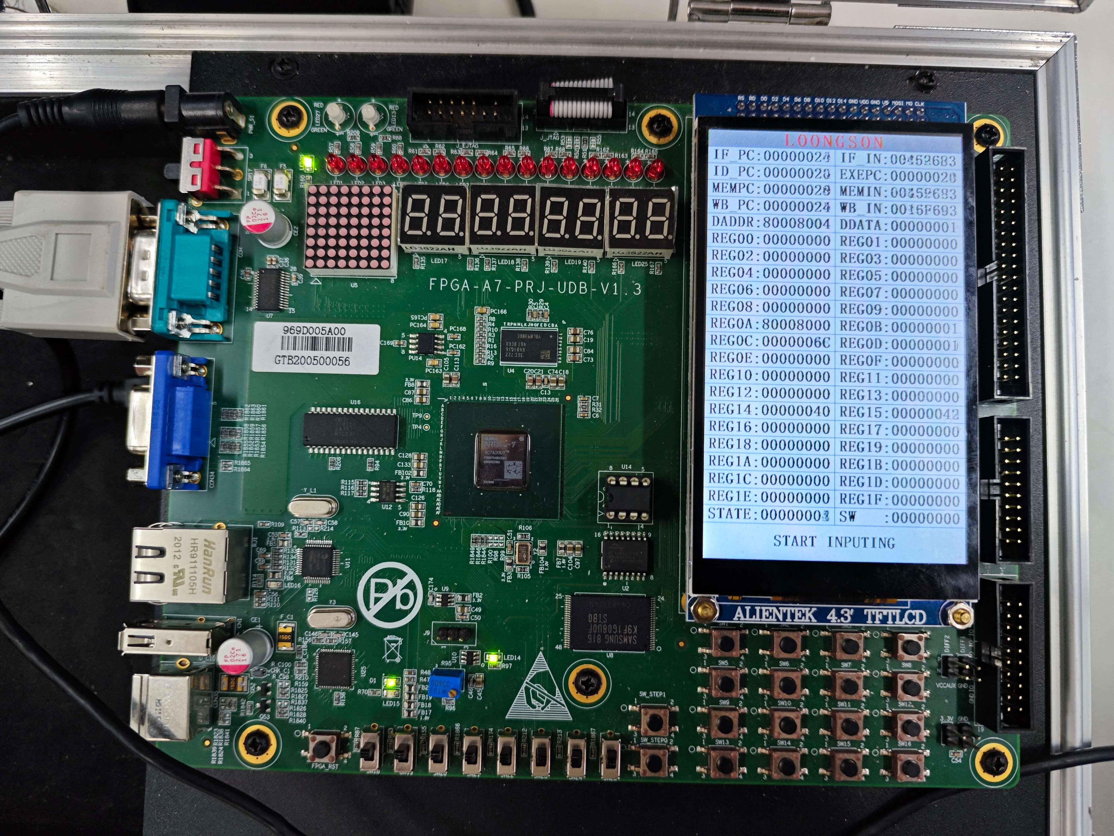
Report/media/uart.jpg
