Degeneracy-Evil/cpu-designers/Report/media/uart_echo_控制台.png

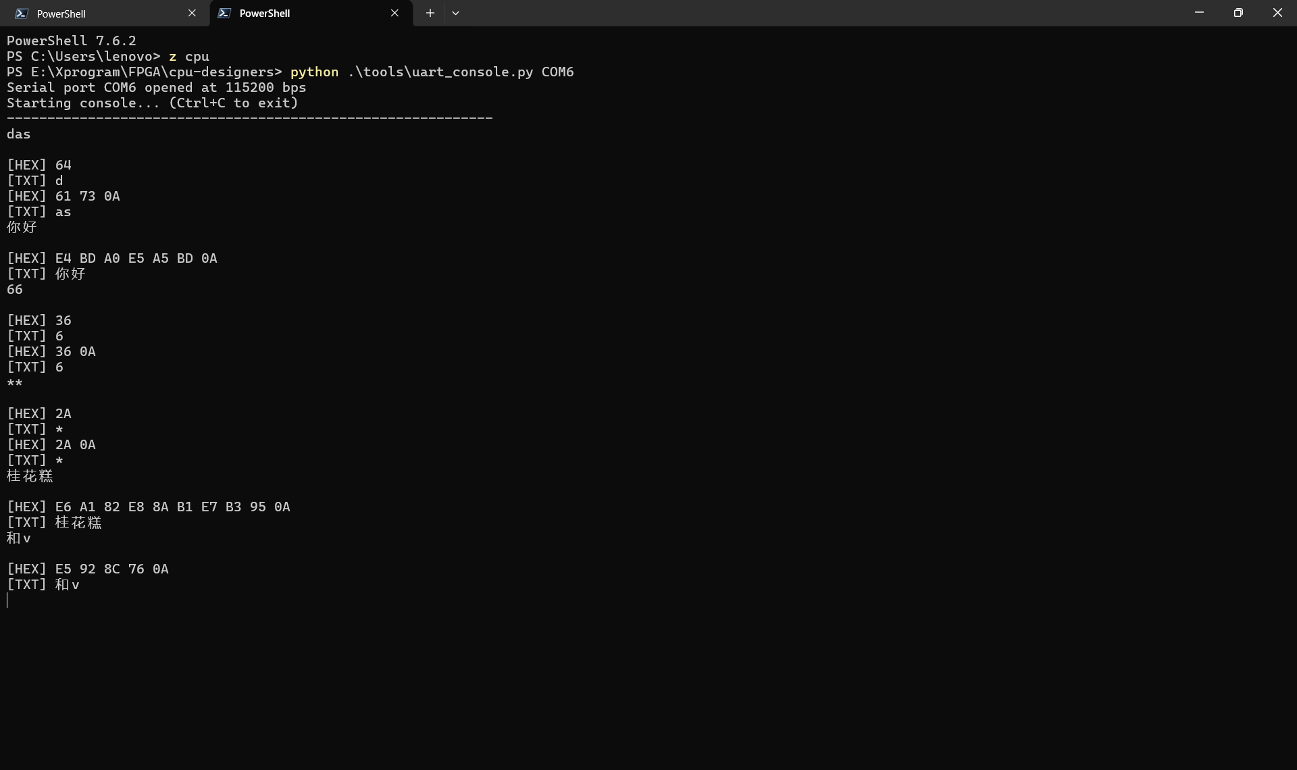
Report/media/uart_echo_控制台.png
