Degeneracy-Evil/cpu-designers/Report/media/上位机读取1.png

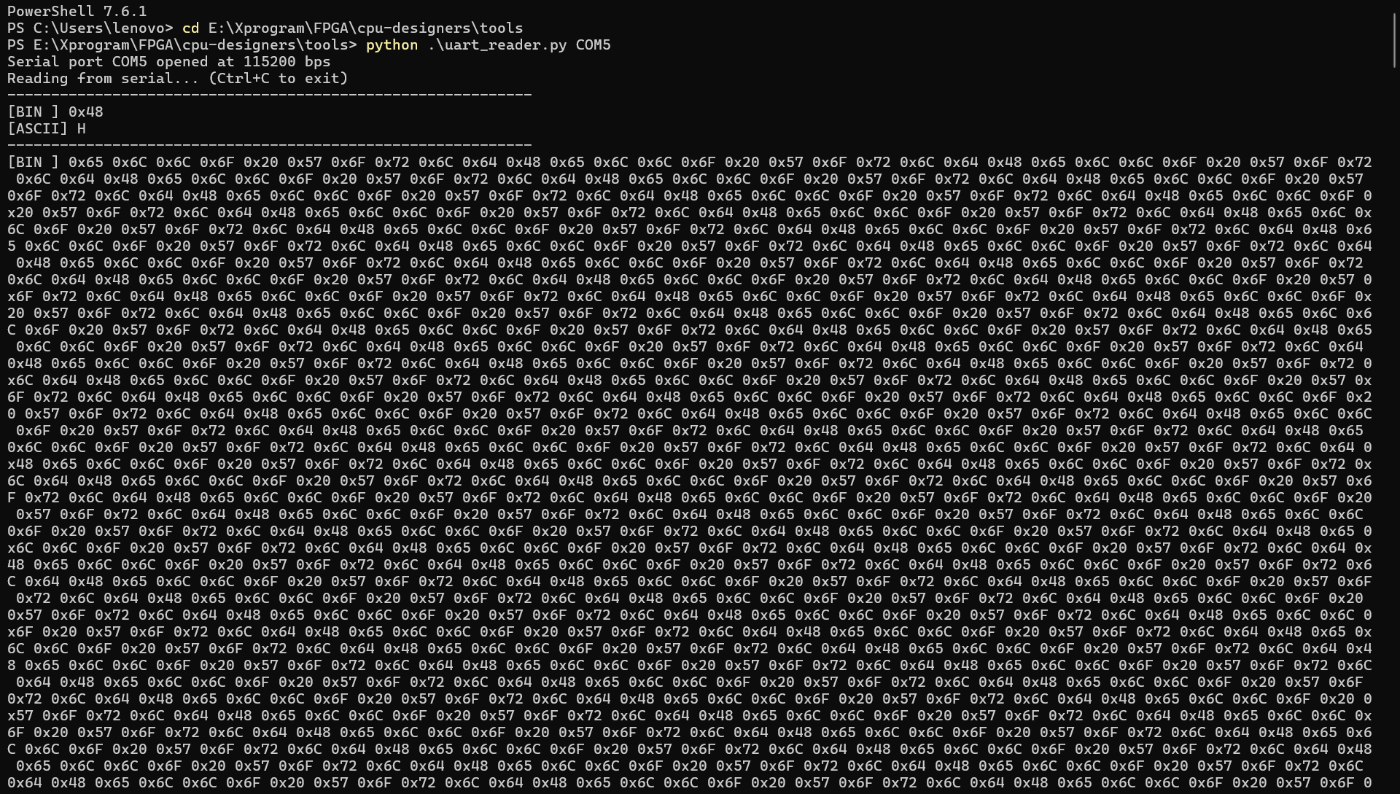
Report/media/上位机读取1.png
