Degeneracy-Evil/cpu-designers/Report/media/上位机读取2.png

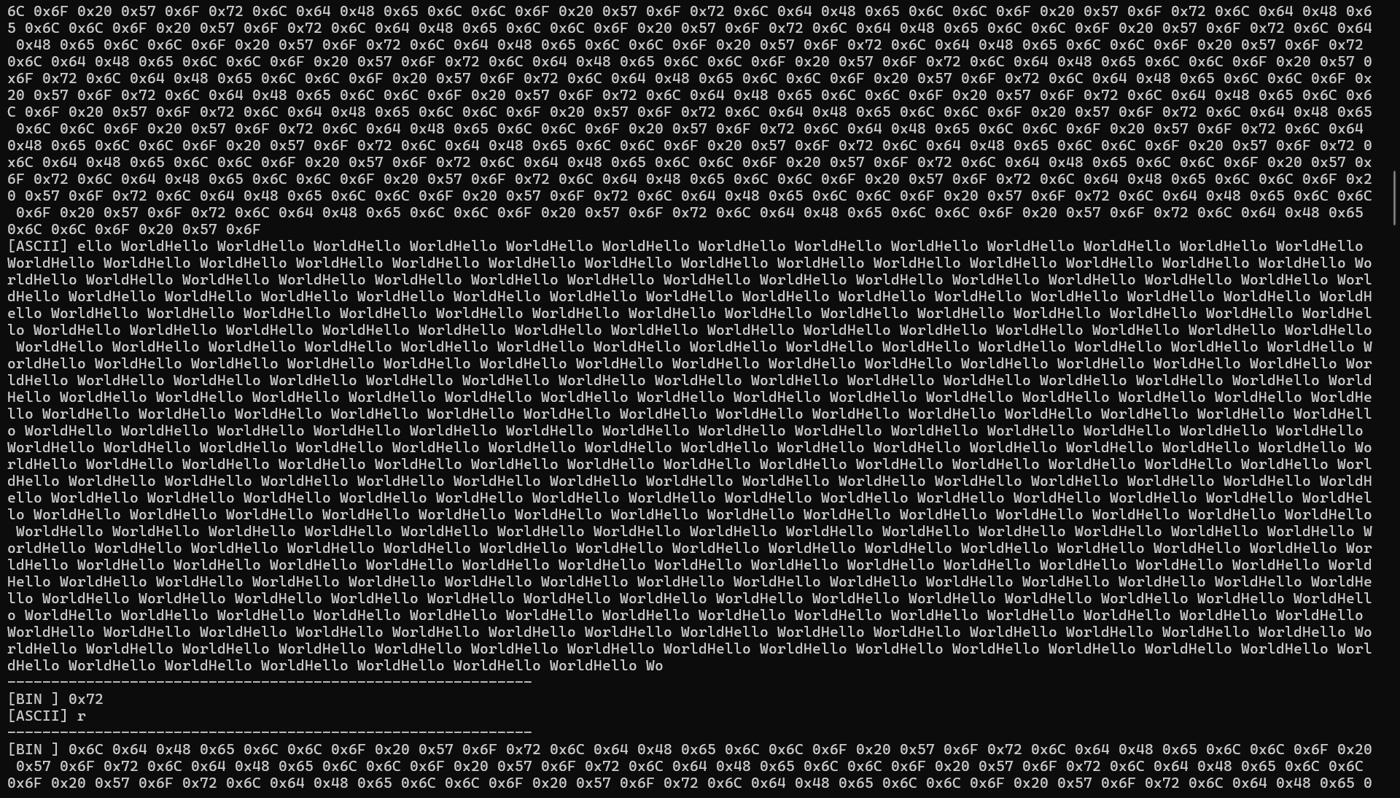
Report/media/上位机读取2.png
