Degeneracy-Evil/cpu-designers/Report/media/嵌入式cpu-控制台.png

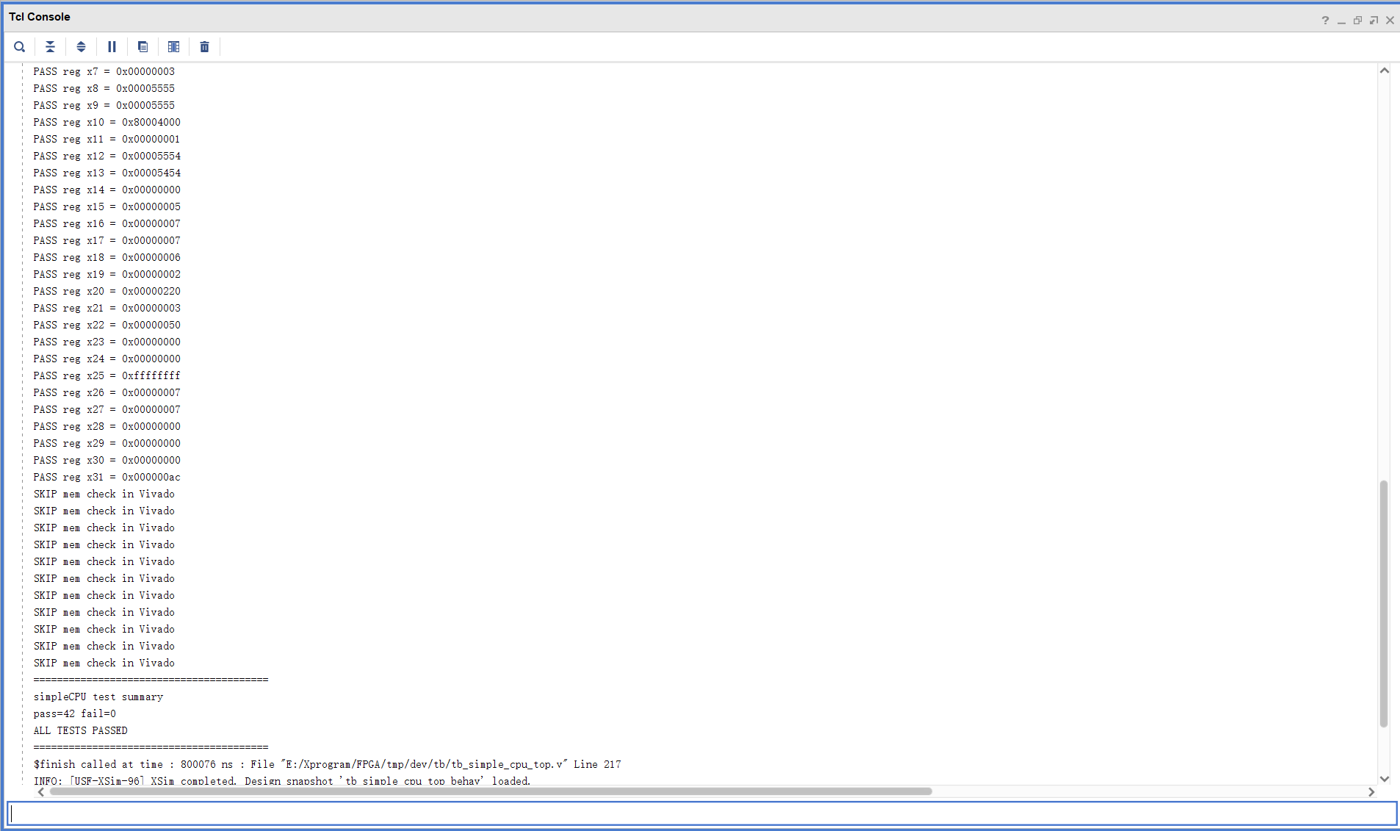
Report/media/嵌入式cpu-控制台.png
