Degeneracy-Evil/cpu-designers/Report/media/嵌入式cpu-波形图.png

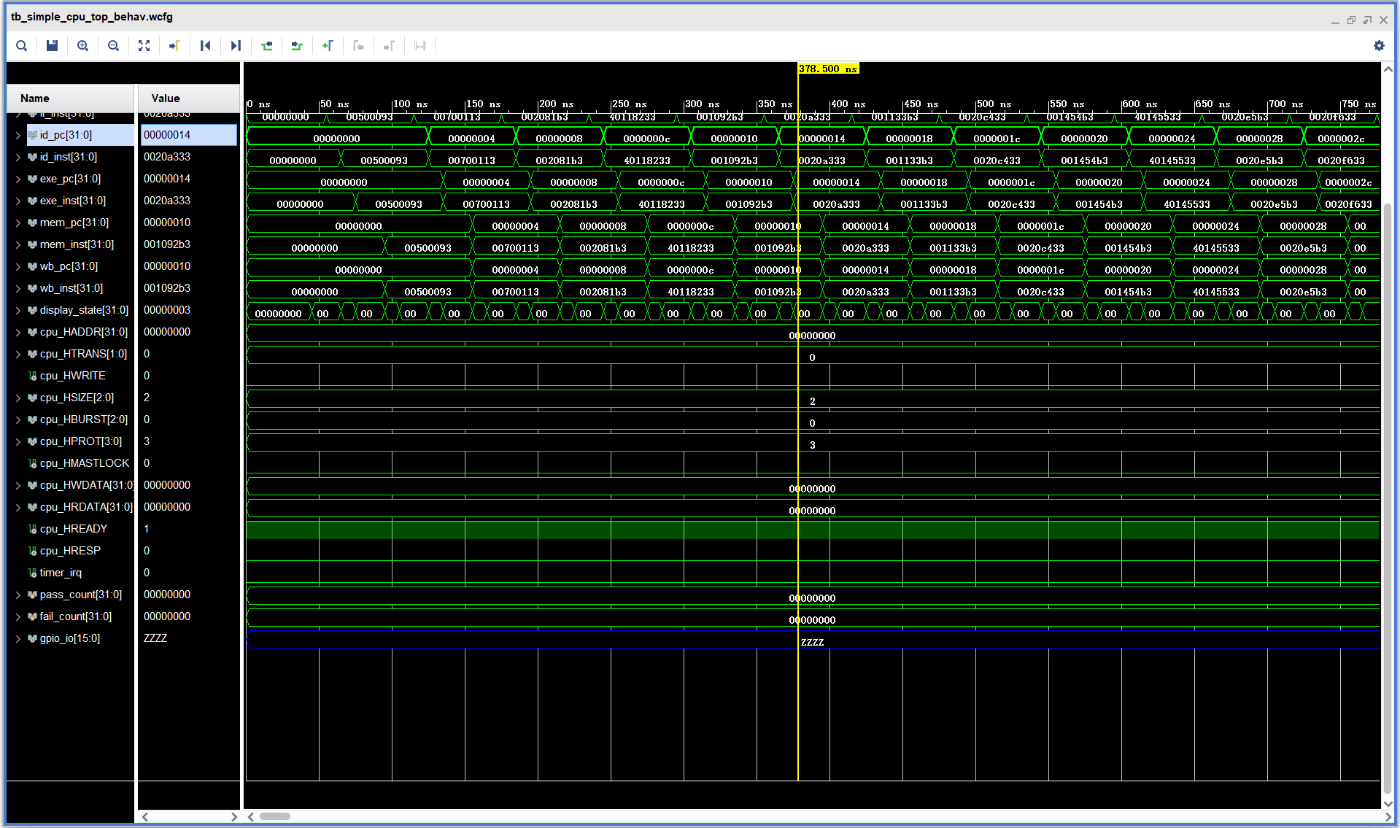
Report/media/嵌入式cpu-波形图.png
