Degeneracy-Evil/cpu-designers/Report/media/架构图-缩略.png

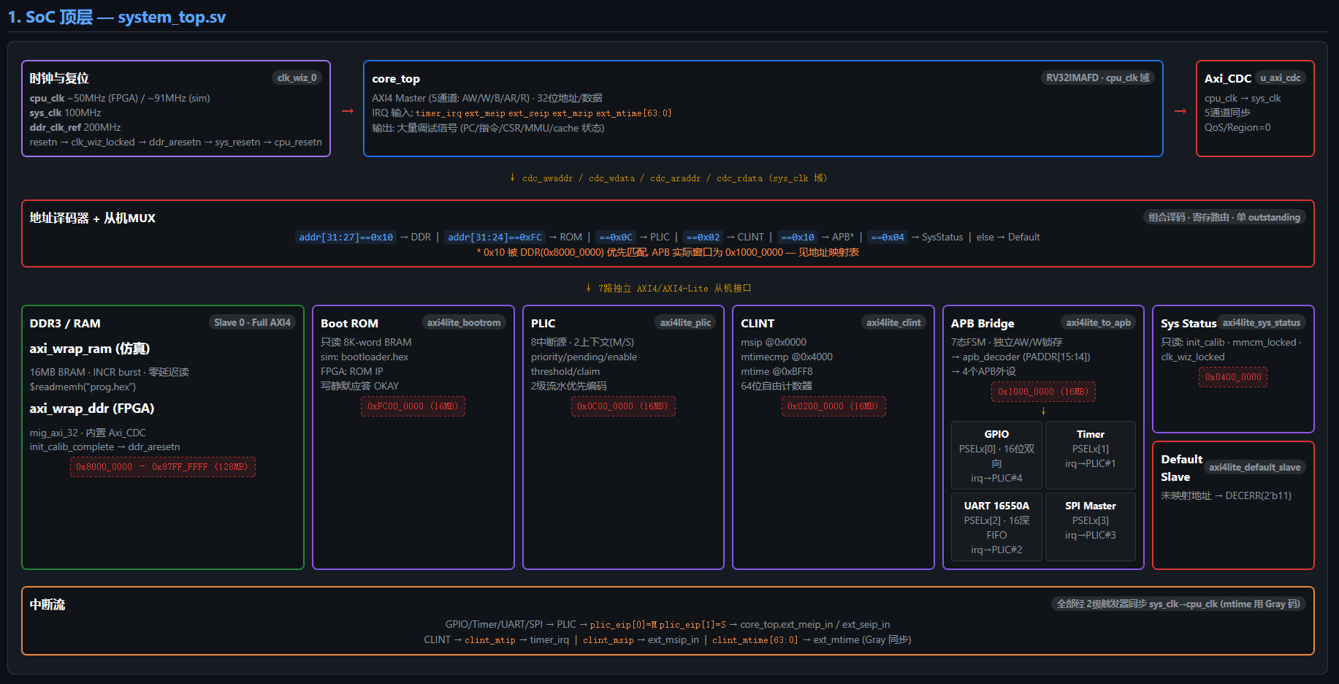
Report/media/架构图-缩略.png
