Degeneracy-Evil/cpu-designers/Report/media/走马灯.jpg

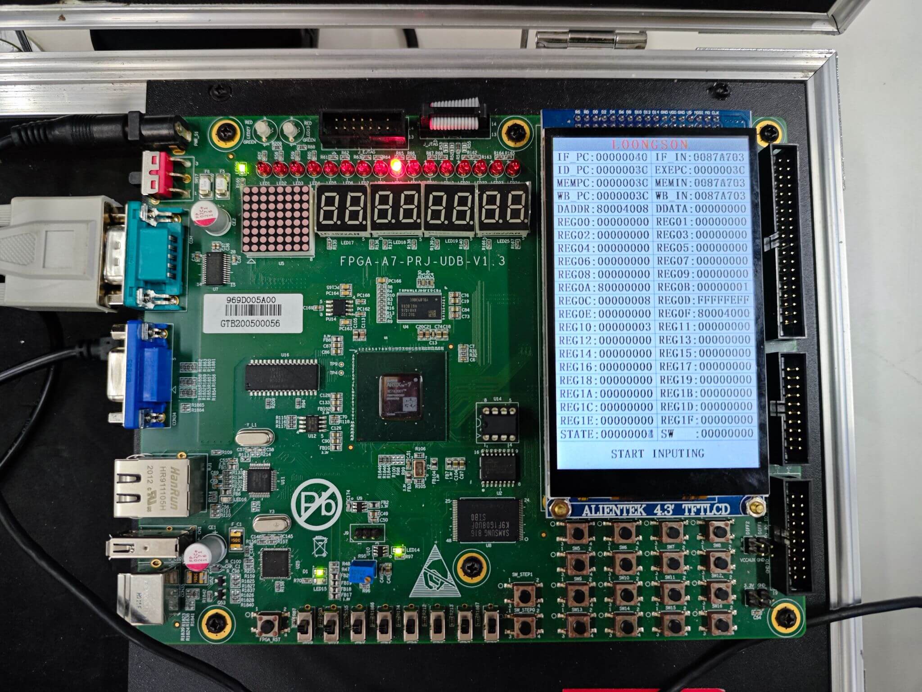
Report/media/走马灯.jpg
