Degeneracy-Evil/cpu-designers/(list of files, cad)

Other CAD files:
dev/program_source/app/calculator_stdio.obj
