Degeneracy-Evil/cpu-designers/dev/rtl/core/icache_ctrl.sv

`timescale 1ns / 1ps
`include "cache_def.svh"

module icache_ctrl(
    input  wire        clk,
    input  wire        resetn,

    input  wire        cpu_req_valid,
    input  wire [31:0] cpu_req_addr,
    input  wire [31:0] cpu_req_vaddr,
    input  wire        mmu_ready,
    input  wire        flush_req,
    output wire [31:0] cpu_req_data,
    output wire        cpu_req_ready,

    output wire        mmio_req,
    input  wire        mmio_accept,
    output wire [31:0] mmio_addr,
    input  wire [31:0] mmio_data,
    input  wire        mmio_valid,

    output wire        refill_req,
    output wire [31:0] refill_addr,
    input  wire [`ICACHE_LINE_WIDTH-1:0] refill_data,
    input  wire        refill_valid,
    input  wire [31:0] refill_resp_addr,
    input  wire        refill_error,      // AXI error during refill — discard data, no tag write

    input  wire        invalidate_req,
    output wire        invalidate_done,
    output wire [2:0]  dbg_state
);

    // --- Cache geometry from config ---
    localparam NUM_SETS      = `ICACHE_NUM_SETS;
    localparam NUM_WAYS      = `ICACHE_NUM_WAYS;
    localparam TAG_WIDTH     = `ICACHE_TAG_WIDTH;
    localparam LINE_WIDTH    = `ICACHE_LINE_WIDTH;
    localparam BRAM_ADDR_W   = `ICACHE_ADDR_WIDTH;
    localparam WEA_WIDTH     = `ICACHE_WEA_WIDTH;
    localparam TAG_ENTRY_W   = `ICACHE_TAG_ENTRY_WIDTH;
    localparam SET_IDX_W     = `ICACHE_SET_IDX_WIDTH;
    localparam WAY_W         = `ICACHE_WAY_WIDTH;
    localparam TAG_BRAM_W    = `ICACHE_TAG_BRAM_WIDTH;
    localparam TAG_BRAM_WEA  = `ICACHE_TAG_BRAM_WEA_WIDTH;
    localparam TAG_BRAM_BS   = `ICACHE_TAG_BRAM_BYTE_SIZE;
    localparam TAG_BRAM_BPW  = `ICACHE_TAG_BRAM_WEA_BITS_PER_WAY;
    // Derived: address layout
    localparam ADDR_UPPER_ZEROS = 30 - `ICACHE_TAG_HI;
    localparam ADDR_LOWER_ZEROS = `ICACHE_SET_IDX_LO;

    // =========================================================================
    // icache FSM states (entry / exit / duration)
    // =========================================================================
    // S_IDLE       : Entry: reset (via S_RST_CLEAR), or any state on flush_req
    //               abort, or S_TAG_READ/S_READ/S_REFILL on completion.
    //               Exit : invalidate_req → S_INVALIDATE;
    //                      cpu_req_valid + mmu_ready + !is_mmio → S_TAG_READ;
    //                      cpu_req_valid + is_mmio → MMIO bypass (stay in S_IDLE).
    //               Duration: 1 cycle (waits for request).
    //
    // S_TAG_READ   : Entry: S_IDLE on cacheable CPU request (tag BRAM Port A
    //               read enabled in S_IDLE, output valid this cycle).
    //               Exit : req_changed → S_IDLE; cache_hit → S_READ;
    //                      cache_miss → S_REFILL (issues refill_req).
    //               Duration: 1 cycle.
    //
    // S_READ       : Entry: S_TAG_READ on cache hit (data BRAM Port A enabled
    //               in S_TAG_READ, output valid this cycle).
    //               Exit : req_changed → S_IDLE; → S_IDLE (returns hit data).
    //               Duration: 1 cycle. Sets cpu_req_ready + updates PLRU.
    //
    // S_REFILL     : Entry: S_TAG_READ on cache miss (refill_req_r asserted).
    //               Exit : req_changed → S_IDLE (abort);
    //                      refill_valid + addr_match → S_IDLE (write tag+data);
    //                      refill_valid + !addr_match → S_IDLE (stale, discard).
    //               Duration: variable (AXI burst latency, ~8-20 cycles).
    //
    // S_INVALIDATE : Entry: S_IDLE on invalidate_req (sfence.vma coherency).
    //               Exit : invalidate_set == NUM_SETS-1 → S_IDLE.
    //               Duration: NUM_SETS cycles (1 BRAM write per set, zeroing
    //               all ways' valid bits). Also clears PLRU state.
    //
    // S_RST_CLEAR  : Entry: reset (ISSUE-4: tag BRAM contents undefined at
    //               reset, valid bits could be X causing X-propagation).
    //               Exit : invalidate_set == NUM_SETS-1 → S_IDLE.
    //               Duration: NUM_SETS cycles. Zero-writes all tag BRAM sets
    //               before accepting any CPU request. Reuses S_INVALIDATE
    //               pattern. No CPU requests accepted during scan.
    //               flush_req is blocked from interrupting this state.
    //
    localparam S_IDLE       = 3'd0;
    localparam S_TAG_READ   = 3'd1;
    localparam S_READ       = 3'd2;
    localparam S_REFILL     = 3'd3;
    localparam S_INVALIDATE = 3'd4;
    localparam S_RST_CLEAR  = 3'd5;  // ISSUE-4: reset-time tag BRAM clear (X-propagation fix)
    localparam S_DONE       = 3'd6;  // ready/done 脉冲缓冲态：消除 S_IDLE 残留

    // Address map:
    //   0x00000000-0x7FFFFFFF: MMIO (peripherals)     — bit[31]=0
    //   0x80000000-0x87FFFFFF: Cacheable (DDR3, 128MB) — bit[31]=1, bit[30]=0, bits[29:27]=0
    //   0x88000000-0xBFFFFFFF: Unmapped (no physical memory; tag aliasing risk if accessed)
    //   0xC0000000-0xFFFFFFFF: MMIO (boot ROM, etc.)  — bit[31]=1, bit[30]=1
    // Boot ROM at 0xFC000000 MUST be uncached: addresses with bit[30]=1
    // are classified as MMIO, so they bypass the cache entirely.
    // Tag width (19 bits) covers exactly 128MB; bits[29:27] are forced zero
    // in refill addresses (ADDR_UPPER_ZEROS=4), so only 0x8000_0000–0x87FF_FFFF
    // is safely cacheable without aliasing.
    //
    // BUG-FIX: MMIO judgment must be based on PHYSICAL address, not virtual address.
    // When Sv32 translation is active, a virtual address in the cacheable range
    // could map to an MMIO physical address (or vice versa). Using the virtual
    // address for this decision would incorrectly route translated MMIO accesses
    // through the cache, or cacheable accesses through the MMIO bypass.
    // The is_mmio signal is only consumed after mmu_ready is asserted (paddr valid).
    wire is_mmio = ~cpu_req_addr[31] | cpu_req_addr[30];

    reg [31:0] active_req_addr_r;
    reg [31:0] active_req_vaddr_r;

    wire lookup_active = (state != S_IDLE);
    wire [31:0] req_addr_sel  = lookup_active ? active_req_addr_r  : cpu_req_addr;
    wire [31:0] req_vaddr_sel = lookup_active ? active_req_vaddr_r : cpu_req_vaddr;
    wire req_changed = lookup_active && cpu_req_valid &&
                       ((cpu_req_addr != active_req_addr_r) || (cpu_req_vaddr != active_req_vaddr_r));

    // PIPT: use paddr for both set index and tag
    wire [TAG_WIDTH-1:0]   req_tag  = req_addr_sel[`ICACHE_TAG_HI:`ICACHE_TAG_LO];
    wire [SET_IDX_W-1:0]   set_idx  = req_addr_sel[`ICACHE_SET_IDX_HI:`ICACHE_SET_IDX_LO];
    wire [SET_IDX_W-1:0]   word_off = req_addr_sel[`ICACHE_WORD_OFF_HI:`ICACHE_WORD_OFF_LO];

    reg [2:0] state;

    // --- PLRU state (kept as registers — too small for BRAM) ---
    reg [NUM_WAYS-2:0] plru_state [0:NUM_SETS-1];

    // =========================================================================
    // Tag BRAM (icachet) — 144-bit × 8 deep, Byte_Size=36, 4-bit WEA
    // Each address = 1 set, data = 4 ways packed: {Way3, Way2, Way1, Way0}
    //   Way N bits: [N*36 +: 36], lower 20 bits = {V(1), tag(19)}, upper 16 = padding
    // =========================================================================
    wire [TAG_BRAM_W-1:0] tag_bram_douta;
    wire [TAG_BRAM_W-1:0] tag_bram_doutb;

    // Port A: CPU read (enable in S_IDLE → output valid in S_TAG_READ)
    // Gated by mmu_ready: is_mmio now depends on physical address, which is
    // only valid when mmu_ready=1. Without this gate, a stale paddr could
    // wrongly enable the tag BRAM for an MMIO access.
    wire tag_bram_ena = (state == S_IDLE) && cpu_req_valid && !cpu_req_ready_r && mmu_ready && !is_mmio;

    // Port B: Refill write / Invalidate write (registered, applied next cycle)
    reg                          tag_bram_enb_r;
    reg [TAG_BRAM_WEA-1:0]      tag_bram_web_r;
    reg [SET_IDX_W-1:0]         tag_bram_addrb_r;
    reg [TAG_BRAM_W-1:0]        tag_bram_dinb_r;

    icachet u_icachet(
        .clka   (clk),
        .ena    (tag_bram_ena),
        .wea    ({TAG_BRAM_WEA{1'b0}}),      // Port A: read only
        .addra  (set_idx),                    // 3-bit set index
        .dina   ({TAG_BRAM_W{1'b0}}),
        .douta  (tag_bram_douta),

        .clkb   (clk),
        .enb    (tag_bram_enb_r),
        .web    (tag_bram_web_r),
        .addrb  (tag_bram_addrb_r),
        .dinb   (tag_bram_dinb_r),
        .doutb  (tag_bram_doutb)
    );

    // --- Tag comparison from BRAM Port A output (valid in S_TAG_READ) ---
    // Each way occupies TAG_BRAM_BS bits in the BRAM word, but only the lower
    // TAG_ENTRY_W bits are meaningful (valid bit + tag). Upper padding is zero.
    wire [TAG_BRAM_BS-1:0] way0_raw = tag_bram_douta[TAG_BRAM_BS*1-1:TAG_BRAM_BS*0];
    wire [TAG_BRAM_BS-1:0] way1_raw = tag_bram_douta[TAG_BRAM_BS*2-1:TAG_BRAM_BS*1];
    wire [TAG_BRAM_BS-1:0] way2_raw = tag_bram_douta[TAG_BRAM_BS*3-1:TAG_BRAM_BS*2];
    wire [TAG_BRAM_BS-1:0] way3_raw = tag_bram_douta[TAG_BRAM_BS*4-1:TAG_BRAM_BS*3];
    wire [TAG_ENTRY_W-1:0] tag_r0 = way0_raw[TAG_ENTRY_W-1:0];
    wire [TAG_ENTRY_W-1:0] tag_r1 = way1_raw[TAG_ENTRY_W-1:0];
    wire [TAG_ENTRY_W-1:0] tag_r2 = way2_raw[TAG_ENTRY_W-1:0];
    wire [TAG_ENTRY_W-1:0] tag_r3 = way3_raw[TAG_ENTRY_W-1:0];

    wire hit0 = tag_r0[TAG_ENTRY_W-1] && (tag_r0[TAG_WIDTH-1:0] == req_tag);
    wire hit1 = tag_r1[TAG_ENTRY_W-1] && (tag_r1[TAG_WIDTH-1:0] == req_tag);
    wire hit2 = tag_r2[TAG_ENTRY_W-1] && (tag_r2[TAG_WIDTH-1:0] == req_tag);
    wire hit3 = tag_r3[TAG_ENTRY_W-1] && (tag_r3[TAG_WIDTH-1:0] == req_tag);

    wire cache_hit = hit0 | hit1 | hit2 | hit3;

    wire [WAY_W-1:0] hit_way;
    assign hit_way = hit0 ? {WAY_W{1'b0}} :
                     hit1 ? {{(WAY_W-1){1'b0}}, 1'b1} :
                     hit2 ? {{(WAY_W-2){1'b0}}, 2'b10} :
                            {{(WAY_W-2){1'b0}}, 2'b11};

    wire inv0 = ~tag_r0[TAG_ENTRY_W-1];
    wire inv1 = ~tag_r1[TAG_ENTRY_W-1];
    wire inv2 = ~tag_r2[TAG_ENTRY_W-1];
    wire inv3 = ~tag_r3[TAG_ENTRY_W-1];

    wire [WAY_W-1:0] plru_victim;
    wire [NUM_WAYS-2:0] plru_next;
    tree_plru u_plru(
        .plru_state (plru_state[set_idx]),
        .victim_way (plru_victim),
        .access_way (hit_way),
        .next_state (plru_next)
    );

    wire [WAY_W-1:0] victim_way = inv0 ? {WAY_W{1'b0}} :
                            inv1 ? {{(WAY_W-1){1'b0}}, 1'b1} :
                            inv2 ? {{(WAY_W-2){1'b0}}, 2'b10} :
                            inv3 ? {{(WAY_W-2){1'b0}}, 2'b11} :
                            plru_victim;

    reg [SET_IDX_W-1:0]  latched_set;
    reg [WAY_W-1:0]      refill_way;
    reg [31:0] latched_addr;

    // =========================================================================
    // Data BRAM (icached) — 256-bit × 32 deep
    // =========================================================================
    wire [BRAM_ADDR_W-1:0] bram_addra = {set_idx, hit_way};
    wire [BRAM_ADDR_W-1:0] bram_addrb = {latched_set, refill_way};

    wire [LINE_WIDTH-1:0] bram_douta;
    wire [LINE_WIDTH-1:0] bram_doutb;

    reg cpu_req_ready_r;
    reg  invalidate_done_r;

    // Data BRAM Port A: enable in S_TAG_READ on hit (hit_way now known)
    // paddr is latched in S_IDLE when mmu_ready=1, so S_TAG_READ can
    // proceed immediately without waiting for a second mmu_ready pulse.
    // The old "ping-pong" wait was needed when MMU re-translated on
    // held-high translate_req; T_COMPLETE state now prevents that.
    // --- Refill address validation: discard stale bridge responses ---
    // When the icache cancels a refill (req_changed in S_REFILL), the bridge
    // may still complete the old request.  Compare the bridge's response
    // address with latched_addr to detect and discard stale data.
    wire refill_addr_match = (refill_resp_addr[31:ADDR_LOWER_ZEROS] == latched_addr[31:ADDR_LOWER_ZEROS]);

    wire bram_ena = (state == S_TAG_READ) && cache_hit;
    wire bram_enb = refill_valid && (state == S_REFILL) && refill_addr_match;

    // CONTRACT: BRAM en=0 output hold. When ena/enb=0, Xilinx BRAM IP holds
    // the last read data on douta/doutb (no explicit output register needed).
    // The FSM relies on this: S_READ reads bram_douta which was latched by
    // the ena pulse in S_TAG_READ. If en=0 caused dout to go X or 0, the hit
    // data would be corrupted. Do NOT add logic that assumes en=0 clears dout.
    icached u_icached(
        .clka   (clk),
        .ena    (bram_ena),
        .wea    ({WEA_WIDTH{1'b0}}),
        .addra  (bram_addra),
        .dina   ({LINE_WIDTH{1'b0}}),
        .douta  (bram_douta),

        .clkb   (clk),
        .enb    (bram_enb),
        .web    ({WEA_WIDTH{1'b1}}),
        .addrb  (bram_addrb),
        .dinb   (refill_data),
        .doutb  (bram_doutb)
    );

    reg [31:0] bypass_data;
    reg        mmio_pending_r;
    reg [31:0] mmio_addr_r;

    // BUG-86 fix is in the bus bridge (cpu_bus_bridge.sv): when a stale
    // MMIO instruction response arrives after a branch redirect, the bus
    // bridge detects addr_r != icache_mmio_addr and discards the stale
    // response, then restarts with the new address.  No icache changes
    // needed — the bus bridge guarantees that ahb_inst_valid is only
    // asserted for the *current* icache_mmio_addr.

    wire [SET_IDX_W-1:0] sel_word_off = (state == S_REFILL) ? latched_addr[`ICACHE_WORD_OFF_HI:`ICACHE_WORD_OFF_LO] : word_off;
    wire [LINE_WIDTH-1:0] sel_line     = (state == S_REFILL) ? refill_data : bram_douta;
    wire [31:0]  sel_word;
    assign sel_word = sel_line[sel_word_off*32 +: 32];

    assign cpu_req_data = is_mmio ? mmio_data : bypass_data;

    reg refill_req_r;
    reg [31:0] refill_addr_r;

    assign refill_req  = refill_req_r;
    assign refill_addr = refill_addr_r;

    assign mmio_req  = mmio_pending_r;
    assign mmio_addr = mmio_addr_r;

    assign cpu_req_ready = cpu_req_ready_r;
    assign invalidate_done = invalidate_done_r;
    assign dbg_state = state;

    wire [NUM_WAYS-2:0] plru_next_refill;
    tree_plru u_plru_refill(
        .plru_state (plru_state[latched_set]),
        .victim_way (),
        .access_way (refill_way),
        .next_state (plru_next_refill)
    );

    // --- Invalidate counter (multi-cycle: 1 BRAM write per set) ---
    reg [SET_IDX_W-1:0] invalidate_set;

    // --- Helper: pack a single way's tag entry into the BRAM line position ---
    // new_entry is TAG_ENTRY_W bits wide; placed at refill_way * TAG_BRAM_BS offset
    wire [TAG_ENTRY_W-1:0] refill_new_entry = {1'b1, latched_addr[`ICACHE_TAG_HI:`ICACHE_TAG_LO]};
    wire [TAG_BRAM_W-1:0]  refill_tag_din   = ({TAG_BRAM_W{1'b0}} | {{(TAG_BRAM_W-TAG_ENTRY_W){1'b0}}, refill_new_entry}) << (refill_way * TAG_BRAM_BS);

    always_ff @(posedge clk or negedge resetn) begin
        if (!resetn) begin
                        state <= S_RST_CLEAR;  // ISSUE-4: clear tag BRAM before accepting requests
            refill_req_r     <= 1'b0;
            refill_addr_r    <= 32'b0;
            latched_set      <= {SET_IDX_W{1'b0}};
            refill_way       <= {WAY_W{1'b0}};
            latched_addr     <= 32'b0;
            active_req_addr_r <= 32'b0;
            active_req_vaddr_r <= 32'b0;
            bypass_data      <= 32'b0;
            cpu_req_ready_r  <= 1'b0;
            mmio_pending_r   <= 1'b0;
            mmio_addr_r      <= 32'b0;
            invalidate_done_r <= 1'b0;
            invalidate_set   <= {SET_IDX_W{1'b0}};
            tag_bram_enb_r   <= 1'b0;
            tag_bram_web_r   <= {TAG_BRAM_WEA{1'b0}};
            tag_bram_addrb_r <= {SET_IDX_W{1'b0}};
            tag_bram_dinb_r  <= {TAG_BRAM_W{1'b0}};
            for (integer s = 0; s < NUM_SETS; s = s + 1) begin
                plru_state[s] <= {NUM_WAYS-1{1'b0}};
            end
        end else begin
            cpu_req_ready_r  <= 1'b0;
            invalidate_done_r <= 1'b0;
            tag_bram_enb_r   <= 1'b0;  // default: no tag BRAM write
            if (mmio_accept)
                mmio_pending_r <= 1'b0;

            // CONTRACT: flush_req can abort S_REFILL mid-flight by dropping refill_req_r.
            // The bus bridge (cpu_bus_bridge.sv) MUST tolerate request cancellation:
            //   - Bridge latches refill address before req edge
            //   - Stale responses are discarded via refill_addr_match check (L202, L403)
            //   - Bridge re-accepts new refill requests from S_IDLE
            // Removing this abort capability would deadlock on trap-during-refill.
            // See also: cpu_bus_bridge.sv refill request handling.
            if (flush_req && (state != S_INVALIDATE) && (state != S_RST_CLEAR)) begin
                state             <= S_IDLE;
                refill_req_r      <= 1'b0;
                mmio_pending_r    <= 1'b0;
                active_req_addr_r <= 32'b0;
                active_req_vaddr_r<= 32'b0;
            end else case (state)
                S_IDLE: begin
                    refill_req_r <= 1'b0;
                    if (invalidate_req) begin
                        state <= S_INVALIDATE;
                        invalidate_set <= {SET_IDX_W{1'b0}};
                    end else if (cpu_req_valid && !cpu_req_ready_r) begin
                        // BUG-FIX: Wait for mmu_ready before deciding MMIO vs cache,
                        // because is_mmio now depends on physical address (cpu_req_addr)
                        // which is only valid when mmu_ready=1.
                        if (mmu_ready) begin
                            if (is_mmio) begin
                                if (!mmio_pending_r) begin
                                    mmio_pending_r <= 1'b1;
                                    mmio_addr_r    <= cpu_req_addr;
                                end
                                if (mmio_valid) begin
                                    bypass_data     <= mmio_data;
                                    cpu_req_ready_r <= 1'b1;
                                end
                            end else begin
                                active_req_addr_r  <= cpu_req_addr;
                                active_req_vaddr_r <= cpu_req_vaddr;
                                // Enable tag BRAM Port A (addra=set_idx already wired)
                                // Output will be valid next cycle in S_TAG_READ
                                state <= S_TAG_READ;
                            end
                        end else begin
                            // mmu_ready not yet — wait for physical address.
                            // Handle any already-pending MMIO response from a
                            // previous request (shouldn't normally happen, but
                            // defensive coding avoids deadlocking the handshake).
                            if (mmio_valid) begin
                                bypass_data     <= mmio_data;
                                cpu_req_ready_r <= 1'b1;
                            end
                        end
                    end
                end

                S_TAG_READ: begin
                    // T_COMPLETE in MMU.sv holds translate_done high until !translate_req,
                    // so mmu_ready stays stable after translation — no ping-pong wait needed.
                    if (req_changed) begin
                        refill_req_r <= 1'b0;
                        state <= S_IDLE;
                    end else if (cache_hit) begin
                        // Data BRAM Port A enabled this cycle (bram_ena above)
                        // Data available next cycle in S_READ
                        state <= S_READ;
                    end else begin
                        latched_set  <= set_idx;
                        latched_addr <= req_addr_sel;
                        refill_way   <= victim_way;
                        refill_req_r <= 1'b1;
                        refill_addr_r <= {1'b1, {ADDR_UPPER_ZEROS{1'b0}}, req_tag, set_idx, {ADDR_LOWER_ZEROS{1'b0}}};
                        state <= S_REFILL;
                    end
                end

                S_READ: begin
                    if (req_changed) begin
                        state <= S_IDLE;
                    end else begin
                        // Data BRAM Port A output is now valid
                        bypass_data     <= sel_word;
                        cpu_req_ready_r <= 1'b1;
                        plru_state[set_idx] <= plru_next;
state <= S_DONE;
                    end
                end

                S_REFILL: begin
                    if (req_changed) begin
                        refill_req_r <= 1'b0;
                        state <= S_IDLE;
                    end else begin
                        refill_req_r <= 1'b1;
                    end
                    // Error path: AXI error during refill — discard data, no tag write
                    if (!req_changed && refill_valid && refill_error) begin
                        refill_req_r <= 1'b0;
                        state <= S_IDLE;
                    end
                    else if (!req_changed && refill_valid && refill_addr_match) begin
                        refill_req_r    <= 1'b0;
                        bypass_data     <= sel_word;
                        cpu_req_ready_r <= 1'b1;
                        // Write tag BRAM Port B: update only the refilled way
                        tag_bram_enb_r   <= 1'b1;
                        tag_bram_web_r   <= ((1 << TAG_BRAM_BPW) - 1) << (refill_way * TAG_BRAM_BPW);
                        tag_bram_addrb_r <= latched_set;
                        tag_bram_dinb_r  <= refill_tag_din;
                        plru_state[latched_set] <= plru_next_refill;
                        state <= S_DONE;
                    end
                    // Stale refill (refill_valid && !refill_addr_match):
                    //   Discard the data — do NOT write tag/data BRAM,
                    //   do NOT set cpu_req_ready.  Return to S_IDLE so
                    //   pending invalidate_req can be serviced (avoids
                    //   deadlock with sfence.vma) and a fresh refill
                    //   request will be issued on the next miss.
                    else if (!req_changed && refill_valid && !refill_addr_match) begin
                        refill_req_r <= 1'b0;
                        state <= S_IDLE;
                    end
                end

                S_INVALIDATE: begin
                    // Write one set per cycle with all zeros (clear all valid bits)
                    tag_bram_enb_r   <= 1'b1;
                    tag_bram_web_r   <= {TAG_BRAM_WEA{1'b1}};   // write all 4 ways
                    tag_bram_addrb_r <= invalidate_set;
                    tag_bram_dinb_r  <= {TAG_BRAM_W{1'b0}};     // all zeros
                    if (invalidate_set == NUM_SETS - 1) begin
                        // Last set written — done
                        for (integer s = 0; s < NUM_SETS; s = s + 1) begin
                            plru_state[s] <= {NUM_WAYS-1{1'b0}};
                        end
                        invalidate_done_r <= 1'b1;
                        state <= S_DONE;
                    end else begin
                        invalidate_set <= invalidate_set + 1'b1;
                    end
                end

                S_RST_CLEAR: begin
                    // ISSUE-4: At reset, tag BRAM contents are undefined (X in
                    // simulation). Since valid bits live in BRAM (TAG_ENTRY_W:
                    // V+D+tag), undefined BRAM means valid bits could be X,
                    // causing X-propagation on first access. Scan all sets and
                    // write zeros to clear valid bits before accepting any
                    // CPU request. Reuses the S_INVALIDATE zero-write pattern.
                    // No CPU requests accepted here — stay until scan complete.
                    tag_bram_enb_r   <= 1'b1;
                    tag_bram_web_r   <= {TAG_BRAM_WEA{1'b1}};   // write all 4 ways
                    tag_bram_addrb_r <= invalidate_set;
                    tag_bram_dinb_r  <= {TAG_BRAM_W{1'b0}};     // all zeros
                    if (invalidate_set == NUM_SETS - 1) begin
                        state <= S_IDLE;
                    end else begin
                        invalidate_set <= invalidate_set + 1'b1;
                    end
                end

                S_DONE: begin
                    // ready/done 信号在上一状态已置 1（非阻塞赋值），
                    // 本周期可见并输出给消费者。下一周期转 S_IDLE，
                    // 默认清零生效，无残留。
                    state <= S_IDLE;
                end

                default: state <= S_IDLE;
            endcase
        end
    end

endmodule
