Degeneracy-Evil/cpu-designers/tasks.yaml

# Task definitions for Vivado orchestration
# Each task maps to a testbench + optional program image + runtime
# For FPGA-only tasks (bitstream), specify 'top' instead of 'tb'
#
# ⚠ COE field in simulation:
#   The `coe` field is used ONLY for FPGA bitstream generation (BRAM IP initialization).
#   In simulation, `ifdef SIMULATION` bypasses COE loading entirely — the RTL uses
#   $readmemh("prog.hex") to load the hex file directly instead (see axi_wrap_ram.sv,
#   axi4lite_bootrom.sv).  The `hex_file` field (or auto-derived from `coe` by
#   replacing .coe → .hex) is what actually takes effect during simulation.
#   The `coe` field still serves two indirect purposes in simulation:
#     1. Auto-derivation of hex_file path (if hex_file is not explicitly set)
#     2. COE-layer hash staleness detection for incremental refresh
#
# Task categories (annotated per section):
#   仿真       — behavioral simulation (SIMULATION=TRUE auto-injected)
#   DDR3仿真   — DDR3 model simulation (sim_mode: ddr3, SIMULATION in verilog_defines)
#   FPGA上板   — bitstream generation + JTAG programming (top module, no tb)

tasks:
  # ── Linux 启动仿真 ──

  linux_boot:
    tb: tb_simple_cpu_top
    blhex: boot/bootloader_phase1.hex
    phex: firmware/fw_payload.hex
    runtime: 60s
    verilog_defines:
      LINUX_BOOT: "TRUE"

  os_boot:
    tb: tb_simple_cpu_top
    blhex: boot/bootloader_phase1.hex
    phex: app/os.hex
    runtime: 10s
    verilog_defines:
      LINUX_BOOT: "TRUE"

  # ── 集成仿真 ──

  cpu_full:
    tb: tb_simple_cpu_top
    blhex: boot/bootloader_phase1.hex
    phex: test/integration/cpu_full.hex
    runtime: 50s

  # ── DDR3仿真 ──

  cpu_full_ddr3:
    tb: tb_simple_cpu_top
    blhex: boot/bootloader.hex
    sim_mode: ddr3
    verilog_defines:
      SIM_BYPASS_INIT_CAL: FAST
      SIMULATION: "TRUE"
      SIMU_USE_DDR: 1
      SIMU_USE_PLL: 0
      SIMU_DDR_MODE: 1
      sg125: 1
    phex: test/integration/cpu_full.hex
    runtime: 1s

  cpu_compute:
    tb: tb_simple_cpu_compute
    blhex: boot/bootloader_phase1.hex
    phex: test/integration/cpu_compute.hex
    runtime: 5ms

  cpu_trap:
    tb: tb_simple_cpu_trap
    blhex: boot/bootloader_phase1.hex
    phex: test/integration/cpu_trap.hex
    runtime: 3ms

  # ── ISA 仿真 ──

  isa_alu:
    tb: tb_isa_alu
    blhex: boot/bootloader_phase1.hex
    phex: test/isa/alu.hex
    runtime: 5ms

  isa_branch:
    tb: tb_isa_branch
    blhex: boot/bootloader_phase1.hex
    phex: test/isa/branch.hex
    runtime: 5ms

  isa_memory:
    tb: tb_isa_memory
    blhex: boot/bootloader_phase1.hex
    phex: test/isa/memory.hex
    runtime: 5ms

  isa_upper_imm:
    tb: tb_isa_upper_imm
    blhex: boot/bootloader_phase1.hex
    phex: test/isa/upper_imm.hex
    runtime: 5ms

  isa_jump:
    tb: tb_isa_jump
    blhex: boot/bootloader_phase1.hex
    phex: test/isa/jump.hex
    runtime: 5ms

  isa_csr:
    tb: tb_isa_csr
    blhex: boot/bootloader_phase1.hex
    phex: test/isa/csr.hex
    runtime: 5ms

  isa_m_ext:
    tb: tb_isa_m_ext
    blhex: boot/bootloader_phase1.hex
    phex: test/isa/m_ext.hex
    runtime: 5ms

  isa_a_ext:
    tb: tb_isa_a_ext
    blhex: boot/bootloader_phase1.hex
    phex: test/isa/a_ext.hex
    runtime: 200ms

  isa_f_ext:
    tb: tb_isa_f_ext
    blhex: boot/bootloader_phase1.hex
    phex: test/isa/f_ext.hex
    runtime: 10ms

  isa_f_ext_special:
    tb: tb_isa_f_ext_special
    blhex: boot/bootloader_phase1.hex
    phex: test/isa/f_ext_special.hex
    runtime: 10ms

  isa_f_f0_writable:
    tb: tb_isa_f_f0_writable
    blhex: boot/bootloader_phase1.hex
    phex: test/isa/f0_writable.hex
    runtime: 10ms

  isa_d_smoke:
    tb: tb_isa_d_smoke
    blhex: boot/bootloader_phase1.hex
    phex: test/isa/d_smoke.hex
    runtime: 10ms

  isa_d_ext:
    tb: tb_isa_d_ext
    blhex: boot/bootloader_phase1.hex
    phex: test/isa/d_ext.hex
    runtime: 20ms

  isa_d_ext_special:
    tb: tb_isa_d_ext_special
    blhex: boot/bootloader_phase1.hex
    phex: test/isa/d_ext_special.hex
    runtime: 20ms

  # ── 异常仿真 ──

  exception_ecall:
    tb: tb_exception_ecall
    blhex: boot/bootloader_phase1.hex
    phex: test/exception/ecall.hex
    runtime: 5ms

  exception_ebreak:
    tb: tb_exception_ebreak
    blhex: boot/bootloader_phase1.hex
    phex: test/exception/ebreak.hex
    runtime: 5ms

  exception_illegal_inst:
    tb: tb_exception_illegal_inst
    blhex: boot/bootloader_phase1.hex
    phex: test/exception/illegal_inst.hex
    runtime: 5ms

  exception_access_fault:
    tb: tb_exception_access_fault
    blhex: boot/bootloader_phase1.hex
    phex: test/exception/access_fault.hex
    runtime: 5ms

  exception_timer_irq:
    tb: tb_exception_timer_irq
    blhex: boot/bootloader_phase1.hex
    phex: test/exception/timer_irq.hex
    runtime: 10ms

  exception_interrupt_basic:
    tb: tb_exception_interrupt_basic
    blhex: boot/bootloader_phase1.hex
    phex: test/exception/interrupt_basic.hex
    runtime: 10ms

  # ── 特权仿真 ──

  privilege_priv_transition:
    tb: tb_privilege_priv_transition
    blhex: boot/bootloader_phase1.hex
    phex: test/privilege/priv_transition.hex
    runtime: 20ms

  privilege_delegation:
    tb: tb_privilege_delegation
    blhex: boot/bootloader_phase1.hex
    phex: test/privilege/delegation.hex
    runtime: 20ms

  privilege_csr_access_priv:
    tb: tb_privilege_csr_access_priv
    blhex: boot/bootloader_phase1.hex
    phex: test/privilege/csr_access_priv.hex
    runtime: 10ms

  privilege_priv_exceptions:
    tb: tb_privilege_priv_exceptions
    blhex: boot/bootloader_phase1.hex
    phex: test/privilege/priv_exceptions.hex
    runtime: 20ms

  privilege_sret_debug:
    tb: tb_privilege_sret_debug
    blhex: boot/bootloader_phase1.hex
    phex: test/privilege/sret_debug.hex
    runtime: 20ms

  # ── MMU 仿真 ──

  mmu_sv32_basic:
    tb: tb_mmu_sv32_basic
    blhex: boot/bootloader_phase1.hex
    phex: test/mmu/sv32_basic.hex
    runtime: 20ms

  mmu_tlb_basic:
    tb: tb_mmu_tlb_basic
    blhex: boot/bootloader_phase1.hex
    phex: test/mmu/tlb_basic.hex
    runtime: 20ms

  mmu_tlb_flush:
    tb: tb_mmu_tlb_flush
    blhex: boot/bootloader_phase1.hex
    phex: test/mmu/tlb_flush.hex
    runtime: 20ms

  mmu_page_fault:
    tb: tb_mmu_page_fault
    blhex: boot/bootloader_phase1.hex
    phex: test/mmu/page_fault.hex
    runtime: 20ms

  mmu_permission:
    tb: tb_mmu_permission
    blhex: boot/bootloader_phase1.hex
    phex: test/mmu/permission.hex
    runtime: 20ms

  mmu_tlb_replace:
    tb: tb_mmu_tlb_replace
    blhex: boot/bootloader_phase1.hex
    phex: test/mmu/tlb_replace.hex
    runtime: 20ms

  mmu_tlb_asid:
    tb: tb_mmu_tlb_asid
    blhex: boot/bootloader_phase1.hex
    phex: test/mmu/tlb_asid.hex
    runtime: 20ms

  mmu_tlb_megapage:
    tb: tb_mmu_tlb_megapage
    blhex: boot/bootloader_phase1.hex
    phex: test/mmu/tlb_megapage.hex
    runtime: 20ms

  mmu_tlb_stress:
    tb: tb_mmu_tlb_stress
    blhex: boot/bootloader_phase1.hex
    phex: test/mmu/tlb_stress.hex
    runtime: 20ms

  mmu_ptw_walk:
    tb: tb_mmu_ptw_walk
    blhex: boot/bootloader_phase1.hex
    phex: test/mmu/ptw_walk.hex
    runtime: 20ms

  mmu_sv32_edge:
    tb: tb_mmu_sv32_edge
    blhex: boot/bootloader_phase1.hex
    phex: test/mmu/sv32_edge.hex
    runtime: 20ms

  mmu_unified_mmu:
    tb: tb_mmu_unified_mmu
    blhex: boot/bootloader_phase1.hex
    phex: test/mmu/unified_mmu.hex
    runtime: 150ms

  mmu_pmp_violation:
    tb: tb_mmu_pmp_violation
    blhex: boot/bootloader_phase1.hex
    phex: test/mmu/pmp_violation.hex
    runtime: 20ms
    expected_fail: true  # PMP not yet implemented (ptw_pmp_grant hardwired to 1'b1)

  # ── Cache 仿真 ──

  cache_icache_basic:
    tb: tb_cache_icache_basic
    blhex: boot/bootloader_phase1.hex
    phex: test/cache/icache_basic.hex
    runtime: 5ms

  cache_dcache_basic:
    tb: tb_cache_dcache_basic
    blhex: boot/bootloader_phase1.hex
    phex: test/cache/dcache_basic.hex
    runtime: 5ms

  cache_dcache_dirty:
    tb: tb_cache_dcache_dirty
    blhex: boot/bootloader_phase1.hex
    phex: test/cache/dcache_dirty.hex
    runtime: 5ms

  cache_fencei:
    tb: tb_cache_fencei
    blhex: boot/bootloader_phase1.hex
    phex: test/cache/fencei.hex
    runtime: 10ms

  cache_mmu_interact:
    tb: tb_cache_cache_mmu_interact
    blhex: boot/bootloader_phase1.hex
    phex: test/cache/cache_mmu_interact.hex
    runtime: 20ms

  # ── MMIO 仿真 ──

  mmio_clint:
    tb: tb_mmio_clint
    blhex: boot/bootloader_phase1.hex
    phex: test/mmio/clint.hex
    runtime: 150ms

  mmio_plic:
    tb: tb_mmio_plic
    blhex: boot/bootloader_phase1.hex
    phex: test/mmio/plic.hex
    runtime: 150ms

  # ── 审计仿真 (bug verification + discovery) ──

  audit_csr_bugs:
    tb: tb_audit_csr_bugs
    blhex: boot/bootloader_phase1.hex
    phex: test/audit/csr_bugs.hex
    runtime: 20ms

  audit_mmu_bugs:
    tb: tb_audit_mmu_bugs
    blhex: boot/bootloader_phase1.hex
    phex: test/audit/mmu_bugs.hex
    runtime: 30ms

  audit_plic_bugs:
    tb: tb_audit_plic_bugs
    blhex: boot/bootloader_phase1.hex
    phex: test/audit/plic_bugs.hex
    runtime: 20ms

  audit_plic_seip:
    tb: tb_audit_plic_seip
    blhex: boot/bootloader_phase1.hex
    phex: test/audit/plic_seip.hex
    runtime: 20ms

  # ── 回归仿真 ──

  reg_tlb_fill_way:
    tb: tb_regression_reg_tlb_fill_way
    blhex: boot/bootloader_phase1.hex
    phex: test/regression/reg_tlb_fill_way.hex
    runtime: 20ms

  reg_ptw_fault_latch:
    tb: tb_regression_reg_ptw_fault_latch
    blhex: boot/bootloader_phase1.hex
    phex: test/regression/reg_ptw_fault_latch.hex
    runtime: 20ms

  reg_sfence_during_walk:
    tb: tb_regression_reg_sfence_during_walk
    blhex: boot/bootloader_phase1.hex
    phex: test/regression/reg_sfence_during_walk.hex
    runtime: 20ms

  reg_stale_paddr:
    tb: tb_regression_reg_stale_paddr
    blhex: boot/bootloader_phase1.hex
    phex: test/regression/reg_stale_paddr.hex
    runtime: 20ms

  reg_bug16_tlb_valid_pulse:
    tb: tb_regression_reg_bug16_tlb_valid_pulse
    blhex: boot/bootloader_phase1.hex
    phex: test/regression/reg_bug16_tlb_valid_pulse.hex
    runtime: 20ms

  reg_bare_no_miss:
    tb: tb_regression_reg_bare_no_miss
    blhex: boot/bootloader_phase1.hex
    phex: test/regression/reg_bare_no_miss.hex
    runtime: 10ms

  reg_mmio_ready:
    tb: tb_regression_reg_mmio_ready
    blhex: boot/bootloader_phase1.hex
    phex: test/regression/reg_mmio_ready.hex
    runtime: 60ms

  reg_dcache_refill_error:
    tb: tb_regression_reg_dcache_refill_error
    blhex: boot/bootloader_phase1.hex
    phex: test/regression/reg_dcache_refill_error.hex
    runtime: 20ms

  reg_dcache_wb_error:
    tb: tb_regression_reg_dcache_wb_error
    blhex: boot/bootloader_phase1.hex
    phex: test/regression/reg_dcache_wb_error.hex
    runtime: 20ms

  reg_fencei_wb_error:
    tb: tb_regression_reg_fencei_wb_error
    blhex: boot/bootloader_phase1.hex
    phex: test/regression/reg_fencei_wb_error.hex
    runtime: 20ms

  reg_sfence_wb_error:
    tb: tb_regression_reg_sfence_wb_error
    blhex: boot/bootloader_phase1.hex
    phex: test/regression/reg_sfence_wb_error.hex
    runtime: 20ms

  reg_wb_error_multi_dirty:
    tb: tb_regression_reg_wb_error_multi_dirty
    blhex: boot/bootloader_phase1.hex
    phex: test/regression/reg_wb_error_multi_dirty.hex
    runtime: 20ms

  reg_pf_latch:
    tb: tb_regression_reg_pf_latch
    blhex: boot/bootloader_phase1.hex
    phex: test/regression/reg_pf_latch.hex
    runtime: 20ms

  reg_linux_ptr_reload:
    tb: tb_regression_reg_linux_ptr_reload
    blhex: boot/bootloader_phase1.hex
    phex: test/regression/reg_linux_ptr_reload.hex
    runtime: 20ms

  reg_linux_field_values:
    tb: tb_regression_reg_linux_field_values
    blhex: boot/bootloader_phase1.hex
    phex: test/regression/reg_linux_field_values.hex
    runtime: 20ms

  # reg_linux_ptr_reload_ddr3:
  #   tb: tb_regression_reg_linux_ptr_reload
  #   blhex: boot/bootloader.hex
  #   sim_mode: ddr3
  #   verilog_defines:
  #     SIM_BYPASS_INIT_CAL: FAST
  #     SIMULATION: "TRUE"
  #     SIMU_USE_DDR: 1
  #     SIMU_USE_PLL: 0
  #     SIMU_DDR_MODE: 1
  #     sg125: 1
  #   phex: test/regression/reg_linux_ptr_reload.hex
  #   runtime: 1s

  # ── 应用仿真 ──

  uart_hello:
    tb: tb_uart_hello
    blhex: boot/bootloader_phase1.hex
    phex: app/uart_hello.hex
    runtime: 20ms

  uart_echo:
    tb: tb_uart_echo
    blhex: boot/bootloader_phase1.hex
    phex: app/uart_echo.hex
    runtime: 50ms

  fpu_minimal_test:
    tb: tb_uart_echo
    blhex: boot/bootloader_phase1.hex
    phex: app/fpu_minimal_test.hex
    runtime: 20ms

  led_marquee:
    tb: tb_led_marquee
    blhex: boot/bootloader_phase1.hex
    phex: app/led_marquee.hex
    runtime: 2s

  # ── 单元仿真 ──

  ahb_bus:
    tb: tb_ahb_bus
    blhex: boot/bootloader_phase1.hex
    runtime: 5000ns

  apb_perips:
    tb: tb_apb_perips
    blhex: boot/bootloader_phase1.hex
    runtime: 200us

  axi4lite_plic_unit:
    tb: tb_axi4lite_plic_unit
    blhex: boot/bootloader_phase1.hex
    runtime: 20us

  axi4lite_clint_unit:
    tb: tb_axi4lite_clint_unit
    blhex: boot/bootloader_phase1.hex
    runtime: 20us

  alu_integration:
    tb: tb_alu_cpu_integration
    blhex: boot/bootloader_phase1.hex
    runtime: 5000ns

  mu_unit:
    tb: tb_mu_unit
    blhex: boot/bootloader_phase1.hex
    runtime: 5000ns

  # ── MMU/TLB 单元仿真 (dev/tb/mmu_tlb_unit/) ──

  mmu_unit:
    tb: tb_mmu_unit
    blhex: boot/bootloader_phase1.hex
    runtime: 500us

  tlb_unit:
    tb: tb_tlb_unit
    blhex: boot/bootloader_phase1.hex
    runtime: 500us

  divider:
    tb: tb_non_restoring_divider
    blhex: boot/bootloader_phase1.hex
    runtime: 5000ns

  fpu_adder:
    tb: tb_fpu_adder
    blhex: boot/bootloader_phase1.hex
    runtime: 10us

  fpu_multiplier:
    tb: tb_fpu_multiplier
    blhex: boot/bootloader_phase1.hex
    runtime: 10us

  fpu_divider:
    tb: tb_fpu_divider
    blhex: boot/bootloader_phase1.hex
    runtime: 50us

  fpu_sqrt:
    tb: tb_fpu_sqrt
    blhex: boot/bootloader_phase1.hex
    runtime: 50us

  fpu_cvt:
    tb: tb_fpu_cvt
    blhex: boot/bootloader_phase1.hex
    runtime: 10us

  # ── D extension 单元仿真 ──

  fpu_adder_d:
    tb: tb_fpu_adder_d
    blhex: boot/bootloader_phase1.hex
    runtime: 10us

  fpu_multiplier_d:
    tb: tb_fpu_multiplier_d
    blhex: boot/bootloader_phase1.hex
    runtime: 10us

  fpu_divider_d:
    tb: tb_fpu_divider_d
    blhex: boot/bootloader_phase1.hex
    runtime: 50us

  fpu_sqrt_d:
    tb: tb_fpu_sqrt_d
    blhex: boot/bootloader_phase1.hex
    runtime: 50us

  fpu_cvt_d:
    tb: tb_fpu_cvt_d
    blhex: boot/bootloader_phase1.hex
    runtime: 10us

  fpu_compare_d:
    tb: tb_fpu_compare_d
    blhex: boot/bootloader_phase1.hex
    runtime: 10us

  fpu_unit:
    tb: tb_fpu_unit
    blhex: boot/bootloader_phase1.hex
    runtime: 50us

  fpu_fsm:
    tb: tb_fpu_fsm
    blhex: boot/bootloader_phase1.hex
    runtime: 500us

  calculator:
    tb: tb_calculator
    blhex: boot/bootloader_phase1.hex
    phex: app/calculator.hex
    runtime: 300ms

  # ── FPGA上板 ──

  fpga:
    top: system_top
    blcoe: boot/bootloader.coe
    verilog_defines:
      SIMU_USE_DDR: 1
      SIMU_USE_PLL: 1

  # DDR3 IP 验证 — 仅创建项目，不仿真/不生成 bitstream
  # Use: python -m tools.vivado_cli -task ddr3_test -create
  ddr3_test:
    top: system_top

  # ── DDR3仿真 ──

  ddr3_mig_ex:
    tb: tb_ddr3_mig_ex
    blhex: boot/bootloader.hex
    sim_mode: ddr3
    verilog_defines:
      SIM_BYPASS_INIT_CAL: FAST
      SIMULATION: "TRUE"
    runtime: 1000us

  ddr3_ahb_ex:
    tb: tb_ddr3_ahb_ex
    blhex: boot/bootloader.hex
    sim_mode: ddr3
    verilog_defines:
      SIM_BYPASS_INIT_CAL: FAST
      SIMULATION: "TRUE"
    runtime: 1000us

  ddr3_basic:
    tb: tb_ddr3_basic
    blhex: boot/bootloader.hex
    sim_mode: ddr3
    verilog_defines:
      SIM_BYPASS_INIT_CAL: FAST
      SIMULATION: "TRUE"
    runtime: 1000us

  ddr3_system:
    tb: tb_ddr3_system
    blhex: boot/bootloader.hex
    sim_mode: ddr3
    verilog_defines:
      SIM_BYPASS_INIT_CAL: FAST
      SIMULATION: "TRUE"
      sg125: 1
      DDR3_BYPASS_CLK_WIZ: 1
    phex: app/ddr3_test.hex
    runtime: 100ms

  ddr3_system_v2:
    tb: tb_ddr3_system_v2
    blhex: boot/bootloader.hex
    sim_mode: ddr3
    verilog_defines:
      SIM_BYPASS_INIT_CAL: FAST
      SIMULATION: "TRUE"
      sg125: 1
      DDR3_BYPASS_CLK_WIZ: 1
    phex: app/ddr3_test.hex
    runtime: 100ms

  ddr3_system_v3:
    tb: tb_ddr3_system_v3
    blhex: boot/bootloader.hex
    sim_mode: ddr3
    verilog_defines:
      SIM_BYPASS_INIT_CAL: FAST
      SIMULATION: "TRUE"
      sg125: 1
      DDR3_BYPASS_CLK_WIZ: 1
    phex: app/ddr3_test.hex
    runtime: 100ms

  # ── Linux Kernel Boot 仿真 (DDR3) ──
  # Loads OpenSBI+kernel payload into DDR3 via AXI4 force writes,
  # then releases CPU to boot. Trap delegation debug enabled.
  # Expected wall-clock time: 2-8 hours depending on crash point.
  kernel_boot_ddr3:
    tb: tb_kernel_boot
    blhex: boot/bootloader_phase1.hex
    phex: firmware/fw_payload.hex
    runtime: 300s
    verilog_defines:
      LINUX_BOOT: "TRUE"
      DEBUG_TRAP_DELEG: 1
      DEBUG_UART_TX: 1
