Degeneracy-Evil/cpu-designers/dev/rtl/core/cpu_decode.sv

`timescale 1ns / 1ps

module cpu_decode(
    input              id_valid,
    input      [95:0]  if_id_bus_r,
    input      [31:0]  rs1_value,
    input      [31:0]  rs2_value,
    output     [4:0]   rs1_addr,
    output     [4:0]   rs2_addr,
    output     [4:0]   rs3_addr,      // FMA rs3 address (inst[31:27])
    output             id_done,
    output             illegal_inst,
    output             dec_is_branch,
    output             dec_need_exe,
    output     [350:0] id_exe_bus,

    output     [31:0]  id_pc,
    output     [31:0]  id_inst,

    output             dec_is_csr,
    output             dec_is_ecall,
    output             dec_is_ebreak,
    output             dec_is_mret,
    output             dec_is_sret,
    output             dec_is_nop_like,
    output             dec_is_fencei,
    output             dec_is_sfence_vma,
    output     [11:0]  dec_csr_addr,
    output     [2:0]   dec_csr_funct3,
    output             dec_csr_addr_valid,
    output             dec_csr_access_ok,

    input      [1:0]   priv_mode,
    input      [31:0]  csr_mstatus
  );
  localparam PRIV_U = 2'b00;
  localparam PRIV_S = 2'b01;
  localparam PRIV_M = 2'b11;

  localparam OPCODE_LUI    = 7'b0110111;
  localparam OPCODE_AUIPC  = 7'b0010111;
  localparam OPCODE_JAL    = 7'b1101111;
  localparam OPCODE_JALR   = 7'b1100111;
  localparam OPCODE_BRANCH = 7'b1100011;
  localparam OPCODE_LOAD   = 7'b0000011;
  localparam OPCODE_STORE  = 7'b0100011;
  localparam OPCODE_OP_IMM = 7'b0010011;
  localparam OPCODE_OP     = 7'b0110011;
  localparam OPCODE_FENCE  = 7'b0001111;
  localparam OPCODE_SYSTEM = 7'b1110011;
  localparam OPCODE_LOAD_FP  = 7'b0000111;  // FLW
  localparam OPCODE_STORE_FP = 7'b0100111;  // FSW
  localparam OPCODE_OP_FP    = 7'b1010011;  // FADD.S/FSUB.S/FMUL.S/FDIV.S/...
  localparam OPCODE_MADD     = 7'b1000011;  // FMADD.S (R4 format)
  localparam OPCODE_MSUB     = 7'b1000111;  // FMSUB.S  (R4 format)
  localparam OPCODE_NMSUB    = 7'b1001011;  // FNMSUB.S (R4 format)
  localparam OPCODE_NMADD    = 7'b1001111;  // FNMADD.S (R4 format)
  localparam OPCODE_AMO      = 7'b0101111;  // LR.W/SC.W/AMO*.W

  wire [31:0] pc_plus4;
  wire [31:0] pc;
  wire [31:0] inst;
  assign {pc_plus4, pc, inst} = if_id_bus_r;

  wire [6:0] opcode;
  wire [2:0] funct3;
  wire [6:0] funct7;
  wire [4:0] rs1;
  wire [4:0] rs2;
  wire [4:0] rd;
  wire [4:0] rs3;        // R4 format: inst[31:27] for FMA instructions
  wire [1:0] fmt;        // R4 format: inst[26:25] (00=S, 01=D)
  wire [31:0] imm_i;
  wire [31:0] imm_s;
  wire [31:0] imm_b;
  wire [31:0] imm_u;
  wire [31:0] imm_j;

  op_regroup u_op_regroup(
               .op32bit(inst),
               .opcode(opcode),
               .funct3(funct3),
               .funct7(funct7),
               .rs1(rs1),
               .rs2(rs2),
               .rd(rd),
               .immI(imm_i),
               .immS(imm_s),
               .immB(imm_b),
               .immU(imm_u),
               .immJ(imm_j)
             );

  // R4 format fields for FMA instructions
  assign rs3 = inst[31:27];   // top 5 bits = rs3 in R4 format
  assign fmt = inst[26:25];   // fmt field: 00=S (single), 01=D (double)

  wire inst_lui;
  wire inst_auipc;
  wire inst_jal;
  wire inst_jalr;
  wire inst_beq;
  wire inst_bne;
  wire inst_blt;
  wire inst_bge;
  wire inst_bltu;
  wire inst_bgeu;
  wire inst_lb;
  wire inst_lh;
  wire inst_lw;
  wire inst_lbu;
  wire inst_lhu;
  wire inst_sb;
  wire inst_sh;
  wire inst_sw;
  wire inst_addi;
  wire inst_slti;
  wire inst_sltiu;
  wire inst_xori;
  wire inst_ori;
  wire inst_andi;
  wire inst_slli;
  wire inst_srli;
  wire inst_srai;
  wire inst_add;
  wire inst_sub;
  wire inst_sll;
  wire inst_slt;
  wire inst_sltu;
  wire inst_xor;
  wire inst_srl;
  wire inst_sra;
  wire inst_or;
  wire inst_and;

  wire inst_mul;
  wire inst_mulh;
  wire inst_mulhsu;
  wire inst_mulhu;
  wire inst_div;
  wire inst_divu;
  wire inst_rem;
  wire inst_remu;

  assign inst_lui   = (opcode == OPCODE_LUI);
  assign inst_auipc = (opcode == OPCODE_AUIPC);
  assign inst_jal   = (opcode == OPCODE_JAL);
  assign inst_jalr  = (opcode == OPCODE_JALR)   && (funct3 == 3'b000);

  assign inst_beq  = (opcode == OPCODE_BRANCH) && (funct3 == 3'b000);
  assign inst_bne  = (opcode == OPCODE_BRANCH) && (funct3 == 3'b001);
  assign inst_blt  = (opcode == OPCODE_BRANCH) && (funct3 == 3'b100);
  assign inst_bge  = (opcode == OPCODE_BRANCH) && (funct3 == 3'b101);
  assign inst_bltu = (opcode == OPCODE_BRANCH) && (funct3 == 3'b110);
  assign inst_bgeu = (opcode == OPCODE_BRANCH) && (funct3 == 3'b111);

  assign inst_lb  = (opcode == OPCODE_LOAD) && (funct3 == 3'b000);
  assign inst_lh  = (opcode == OPCODE_LOAD) && (funct3 == 3'b001);
  assign inst_lw  = (opcode == OPCODE_LOAD) && (funct3 == 3'b010);
  assign inst_lbu = (opcode == OPCODE_LOAD) && (funct3 == 3'b100);
  assign inst_lhu = (opcode == OPCODE_LOAD) && (funct3 == 3'b101);

  assign inst_sb = (opcode == OPCODE_STORE) && (funct3 == 3'b000);
  assign inst_sh = (opcode == OPCODE_STORE) && (funct3 == 3'b001);
  assign inst_sw = (opcode == OPCODE_STORE) && (funct3 == 3'b010);

  assign inst_addi  = (opcode == OPCODE_OP_IMM) && (funct3 == 3'b000);
  assign inst_slti  = (opcode == OPCODE_OP_IMM) && (funct3 == 3'b010);
  assign inst_sltiu = (opcode == OPCODE_OP_IMM) && (funct3 == 3'b011);
  assign inst_xori  = (opcode == OPCODE_OP_IMM) && (funct3 == 3'b100);
  assign inst_ori   = (opcode == OPCODE_OP_IMM) && (funct3 == 3'b110);
  assign inst_andi  = (opcode == OPCODE_OP_IMM) && (funct3 == 3'b111);
  assign inst_slli  = (opcode == OPCODE_OP_IMM) && (funct3 == 3'b001) && (inst[31:25] == 7'b0000000);
  assign inst_srli  = (opcode == OPCODE_OP_IMM) && (funct3 == 3'b101) && (inst[31:25] == 7'b0000000);
  assign inst_srai  = (opcode == OPCODE_OP_IMM) && (funct3 == 3'b101) && (inst[31:25] == 7'b0100000);

  assign inst_add  = (opcode == OPCODE_OP) && (funct3 == 3'b000) && (funct7 == 7'b0000000);
  assign inst_sub  = (opcode == OPCODE_OP) && (funct3 == 3'b000) && (funct7 == 7'b0100000);
  assign inst_sll  = (opcode == OPCODE_OP) && (funct3 == 3'b001) && (funct7 == 7'b0000000);
  assign inst_slt  = (opcode == OPCODE_OP) && (funct3 == 3'b010) && (funct7 == 7'b0000000);
  assign inst_sltu = (opcode == OPCODE_OP) && (funct3 == 3'b011) && (funct7 == 7'b0000000);
  assign inst_xor  = (opcode == OPCODE_OP) && (funct3 == 3'b100) && (funct7 == 7'b0000000);
  assign inst_srl  = (opcode == OPCODE_OP) && (funct3 == 3'b101) && (funct7 == 7'b0000000);
  assign inst_sra  = (opcode == OPCODE_OP) && (funct3 == 3'b101) && (funct7 == 7'b0100000);
  assign inst_or   = (opcode == OPCODE_OP) && (funct3 == 3'b110) && (funct7 == 7'b0000000);
  assign inst_and  = (opcode == OPCODE_OP) && (funct3 == 3'b111) && (funct7 == 7'b0000000);

  assign inst_mul    = (opcode == OPCODE_OP) && (funct3 == 3'b000) && (funct7 == 7'b0000001);
  assign inst_mulh   = (opcode == OPCODE_OP) && (funct3 == 3'b001) && (funct7 == 7'b0000001);
  assign inst_mulhsu = (opcode == OPCODE_OP) && (funct3 == 3'b010) && (funct7 == 7'b0000001);
  assign inst_mulhu  = (opcode == OPCODE_OP) && (funct3 == 3'b011) && (funct7 == 7'b0000001);
  assign inst_div    = (opcode == OPCODE_OP) && (funct3 == 3'b100) && (funct7 == 7'b0000001);
  assign inst_divu   = (opcode == OPCODE_OP) && (funct3 == 3'b101) && (funct7 == 7'b0000001);
  assign inst_rem    = (opcode == OPCODE_OP) && (funct3 == 3'b110) && (funct7 == 7'b0000001);
  assign inst_remu   = (opcode == OPCODE_OP) && (funct3 == 3'b111) && (funct7 == 7'b0000001);

  // FPU instruction matches
  wire inst_flw = (opcode == OPCODE_LOAD_FP) && (funct3 == 3'b010);
  wire inst_fsw = (opcode == OPCODE_STORE_FP) && (funct3 == 3'b010);

  // D extension load/store: FLD (width=3'b011), FSD (width=3'b011)
  wire inst_fld = (opcode == OPCODE_LOAD_FP)  && (funct3 == 3'b011);
  wire inst_fsd = (opcode == OPCODE_STORE_FP) && (funct3 == 3'b011);

  wire inst_fadd_s  = (opcode == OPCODE_OP_FP) && (funct7 == 7'b0000000);
  wire inst_fsub_s  = (opcode == OPCODE_OP_FP) && (funct7 == 7'b0000100);
  wire inst_fmul_s  = (opcode == OPCODE_OP_FP) && (funct7 == 7'b0001000);
  wire inst_fdiv_s  = (opcode == OPCODE_OP_FP) && (funct7 == 7'b0001100);
  wire inst_fsqrt_s = (opcode == OPCODE_OP_FP) && (funct7 == 7'b0101100) && (rs2 == 5'd0);
  wire inst_fsgnj_s  = (opcode == OPCODE_OP_FP) && (funct7 == 7'b0010000) && (funct3 == 3'b000);
  wire inst_fsgnjn_s = (opcode == OPCODE_OP_FP) && (funct7 == 7'b0010000) && (funct3 == 3'b001);
  wire inst_fsgnjx_s = (opcode == OPCODE_OP_FP) && (funct7 == 7'b0010000) && (funct3 == 3'b010);
  wire inst_fmin_s   = (opcode == OPCODE_OP_FP) && (funct7 == 7'b0010100) && (funct3 == 3'b000);
  wire inst_fmax_s   = (opcode == OPCODE_OP_FP) && (funct7 == 7'b0010100) && (funct3 == 3'b001);
  wire inst_fcvt_w_s  = (opcode == OPCODE_OP_FP) && (funct7 == 7'b1100000) && (rs2 == 5'd0);
  wire inst_fcvt_wu_s = (opcode == OPCODE_OP_FP) && (funct7 == 7'b1100000) && (rs2 == 5'd1);
  wire inst_fcvt_s_w  = (opcode == OPCODE_OP_FP) && (funct7 == 7'b1101000) && (rs2 == 5'd0);
  wire inst_fcvt_s_wu = (opcode == OPCODE_OP_FP) && (funct7 == 7'b1101000) && (rs2 == 5'd1);
  wire inst_feq_s     = (opcode == OPCODE_OP_FP) && (funct7 == 7'b1010000) && (funct3 == 3'b010);
  wire inst_flt_s     = (opcode == OPCODE_OP_FP) && (funct7 == 7'b1010000) && (funct3 == 3'b001);
  wire inst_fle_s     = (opcode == OPCODE_OP_FP) && (funct7 == 7'b1010000) && (funct3 == 3'b000);
  wire inst_fclass_s  = (opcode == OPCODE_OP_FP) && (funct7 == 7'b1110000) && (funct3 == 3'b001) && (rs2 == 5'd0);
  wire inst_fmv_x_w   = (opcode == OPCODE_OP_FP) && (funct7 == 7'b1110000) && (funct3 == 3'b000) && (rs2 == 5'd0);
  wire inst_fmv_w_x   = (opcode == OPCODE_OP_FP) && (funct7 == 7'b1111000) && (funct3 == 3'b000) && (rs2 == 5'd0);

  // D extension OP-FP instructions (fmt=01 for double-precision)
  // funct7 for D = funct7 for F with bit 0 set (fmt[0]=1)
  wire inst_fadd_d   = (opcode == OPCODE_OP_FP) && (funct7 == 7'b0000001);
  wire inst_fsub_d   = (opcode == OPCODE_OP_FP) && (funct7 == 7'b0000101);
  wire inst_fmul_d   = (opcode == OPCODE_OP_FP) && (funct7 == 7'b0001001);
  wire inst_fdiv_d   = (opcode == OPCODE_OP_FP) && (funct7 == 7'b0001101);
  wire inst_fsqrt_d  = (opcode == OPCODE_OP_FP) && (funct7 == 7'b0101101) && (rs2 == 5'd0);
  wire inst_fsgnj_d  = (opcode == OPCODE_OP_FP) && (funct7 == 7'b0010001) && (funct3 == 3'b000);
  wire inst_fsgnjn_d = (opcode == OPCODE_OP_FP) && (funct7 == 7'b0010001) && (funct3 == 3'b001);
  wire inst_fsgnjx_d = (opcode == OPCODE_OP_FP) && (funct7 == 7'b0010001) && (funct3 == 3'b010);
  wire inst_fmin_d   = (opcode == OPCODE_OP_FP) && (funct7 == 7'b0010101) && (funct3 == 3'b000);
  wire inst_fmax_d   = (opcode == OPCODE_OP_FP) && (funct7 == 7'b0010101) && (funct3 == 3'b001);
  wire inst_feq_d    = (opcode == OPCODE_OP_FP) && (funct7 == 7'b1010001) && (funct3 == 3'b010);
  wire inst_flt_d    = (opcode == OPCODE_OP_FP) && (funct7 == 7'b1010001) && (funct3 == 3'b001);
  wire inst_fle_d    = (opcode == OPCODE_OP_FP) && (funct7 == 7'b1010001) && (funct3 == 3'b000);
  wire inst_fclass_d = (opcode == OPCODE_OP_FP) && (funct7 == 7'b1110001) && (funct3 == 3'b001) && (rs2 == 5'd0);
  wire inst_fcvt_w_d   = (opcode == OPCODE_OP_FP) && (funct7 == 7'b1100001) && (rs2 == 5'd0);
  wire inst_fcvt_wu_d  = (opcode == OPCODE_OP_FP) && (funct7 == 7'b1100001) && (rs2 == 5'd1);
  wire inst_fcvt_d_w   = (opcode == OPCODE_OP_FP) && (funct7 == 7'b1101001) && (rs2 == 5'd0);
  wire inst_fcvt_d_wu  = (opcode == OPCODE_OP_FP) && (funct7 == 7'b1101001) && (rs2 == 5'd1);
  wire inst_fcvt_s_d   = (opcode == OPCODE_OP_FP) && (funct7 == 7'b0100000) && (rs2 == 5'd1);
  wire inst_fcvt_d_s   = (opcode == OPCODE_OP_FP) && (funct7 == 7'b0100001) && (rs2 == 5'd0);

  // FMA instructions (R4 format): fmt must be S (00) for single-precision
  wire inst_fmadd_s  = (opcode == OPCODE_MADD)  && (fmt == 2'b00);
  wire inst_fmsub_s  = (opcode == OPCODE_MSUB)  && (fmt == 2'b00);
  wire inst_fnmsub_s = (opcode == OPCODE_NMSUB) && (fmt == 2'b00);
  wire inst_fnmadd_s = (opcode == OPCODE_NMADD) && (fmt == 2'b00);
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
